Polarisru/kicad6_library/README.md

# Own parts library for KiCad6

## How to install

1. Start KiCad and select **Preferences → Configure Paths**:

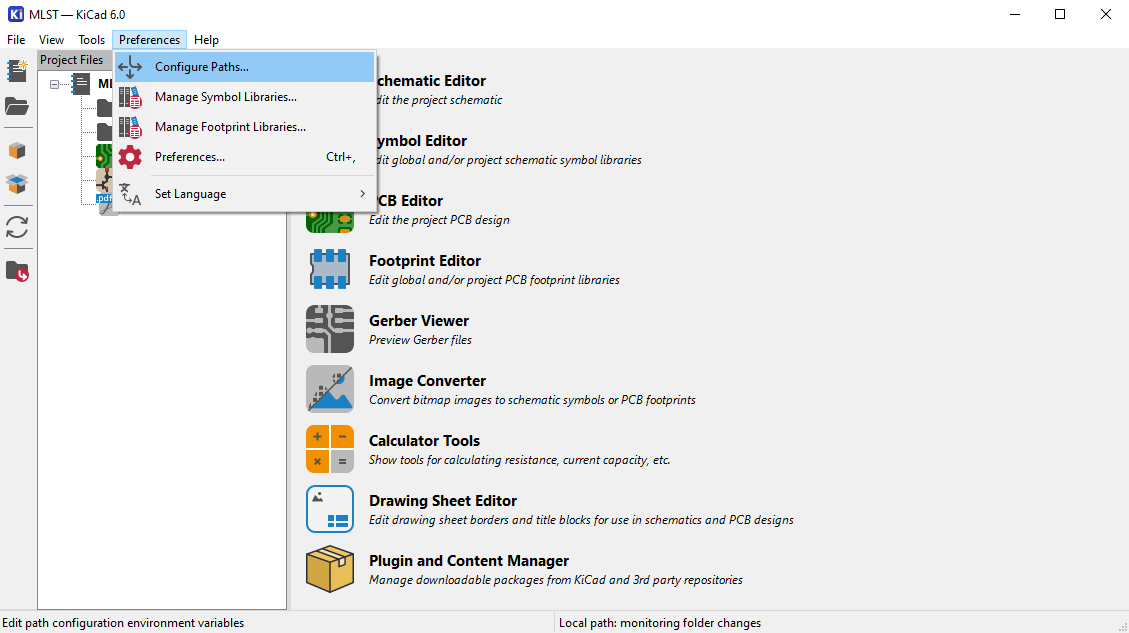
[picture p1: pics/KiCad_path_0.png]
Path configuration


2. Press **Plus** button and enter **KICAD_OWN_LIB** as Name, then select your kicad-library folder (here it‘s *E:\Projects\MLST\kicad-library*):

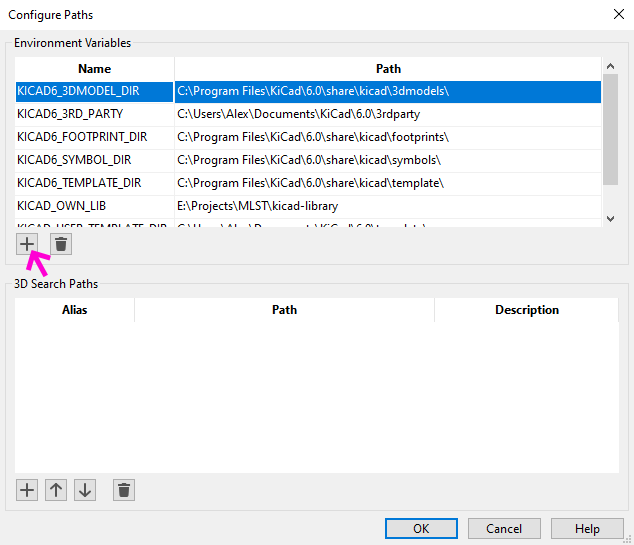
[picture p2: pics/KiCad_path.png]
Path configuration


3. Select **Preferences → Manage Symbol Libraries**:

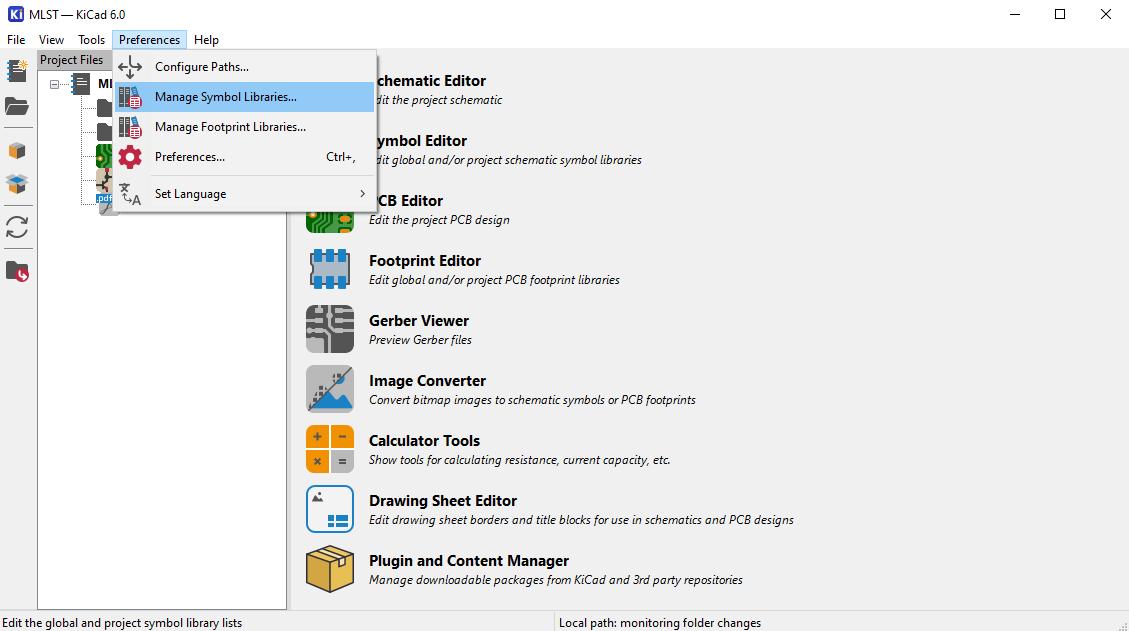
[picture p3: pics/KiCad_symbol_0.png]


4. Press **Folder** button and add you symbol library (*OwnLib.kicad_sym*):

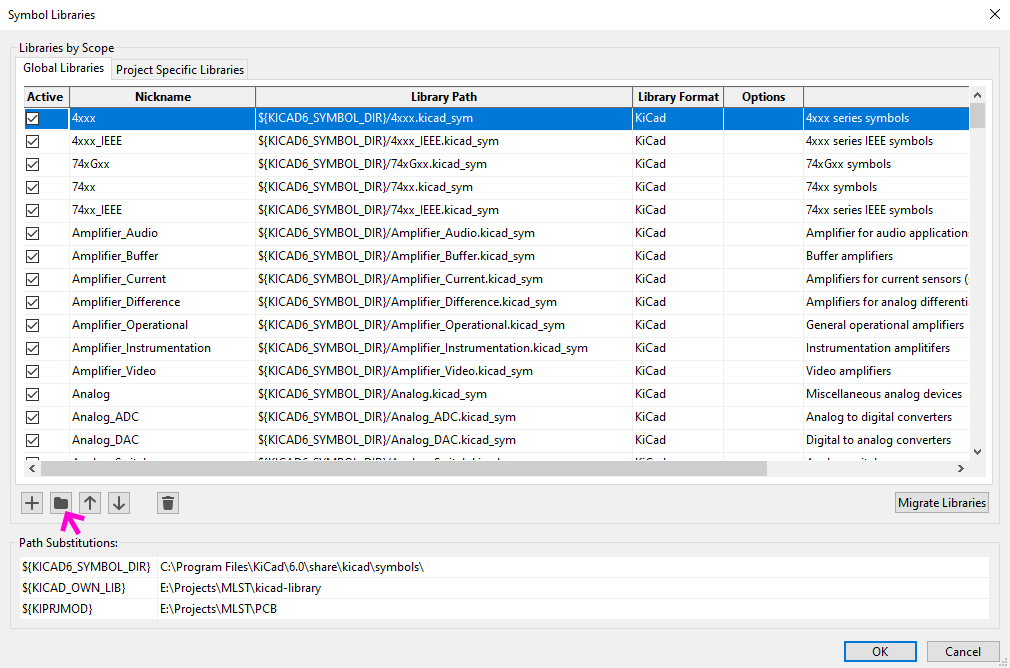
[picture p4: pics/KiCad_symbol.png]


5. Select **Preferences → Manage Footprint Libraries**:

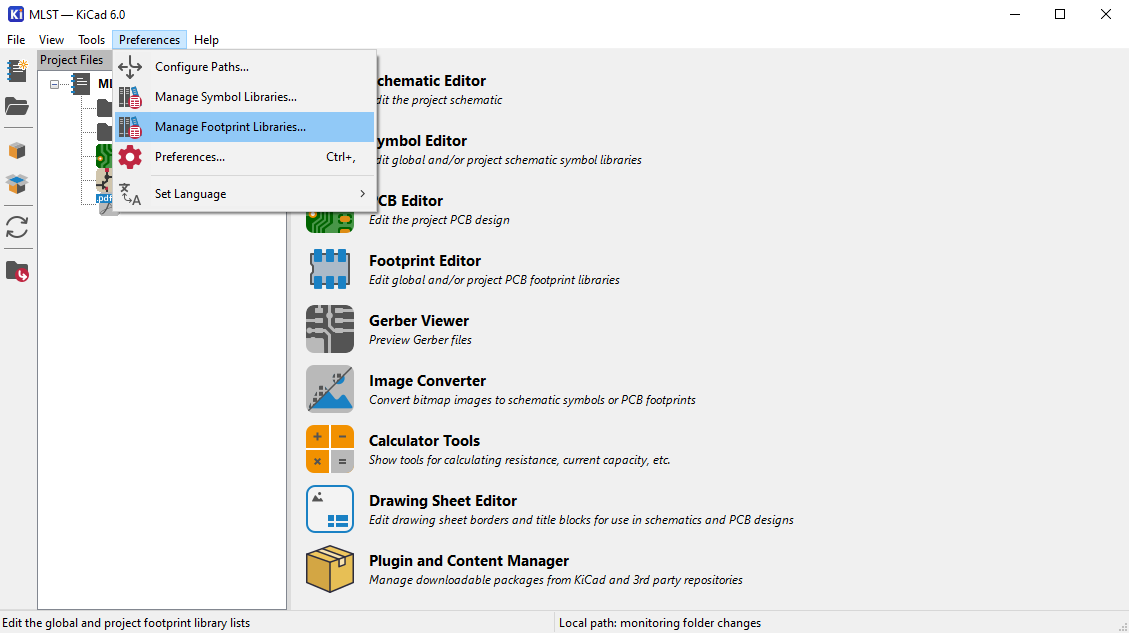
[picture p5: pics/KiCad_footprint_0.png]


6. Press **Folder** button and add you footprint folder (*OwnLib.pretty*):

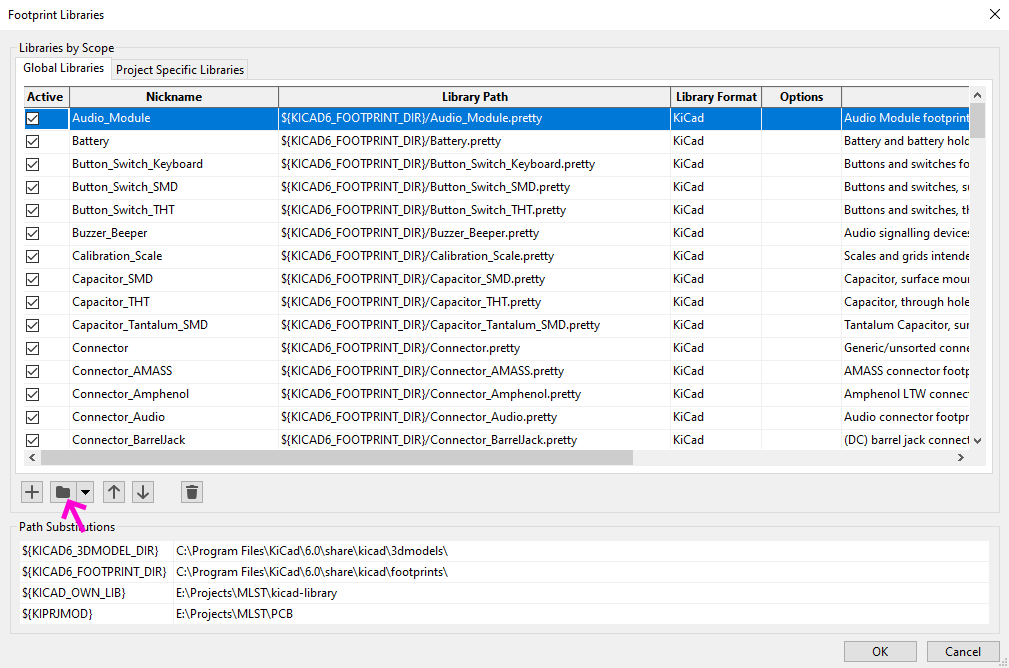
[picture p6: pics/KiCad_footprint.png]


Ready!
