Polarisru/kicad6_library/3DPackages/SX1262LoRaNode.step

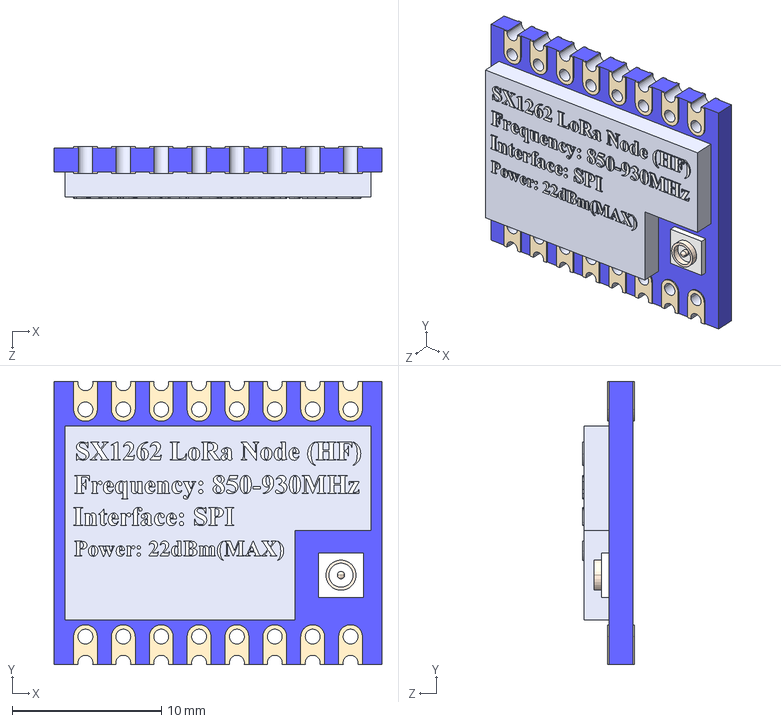
[picture p7: CAD file, 2026-10-09]
3DPackages/SX1262LoRaNode.step
22.0 x 19.0 x 3.47 mm
