Polarisru/kicad6_library/3DPackages/ATGM336H.step

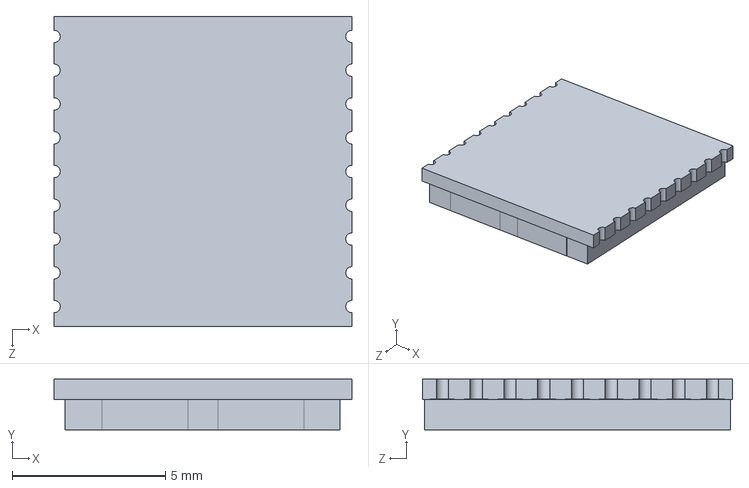
[picture p8: CAD file, 2026-10-09]
3DPackages/ATGM336H.step
9.70 x 1.66 x 10.1 mm
