Polarisru/kicad6_library/3DPackages/AA_Holder.step

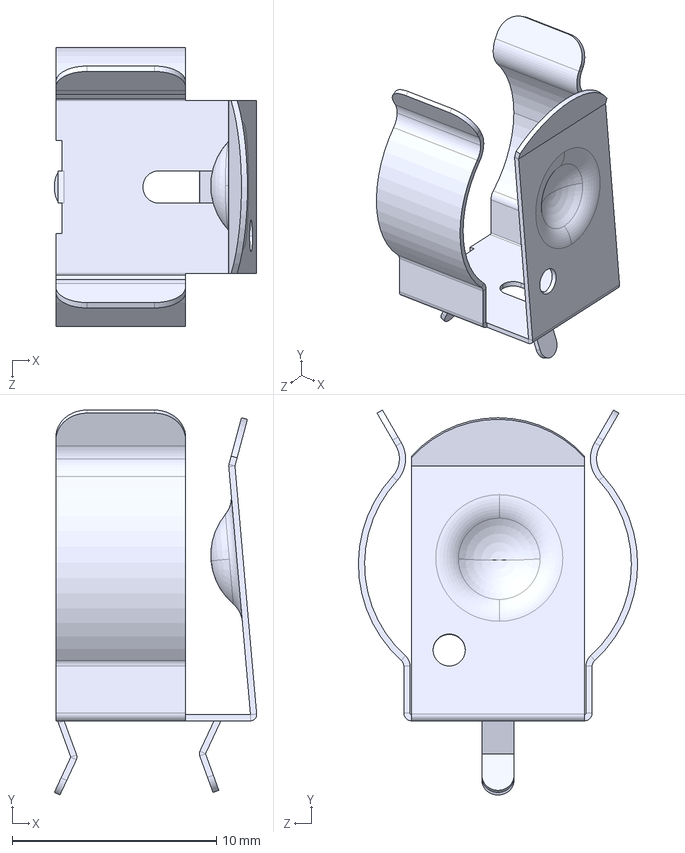
[picture p9: CAD file, 2026-04-12]
3DPackages/AA_Holder.step
9.91 x 18.8 x 13.7 mm
