Polarisru/kicad6_library/3DPackages/SW_PUSH-12mm.step

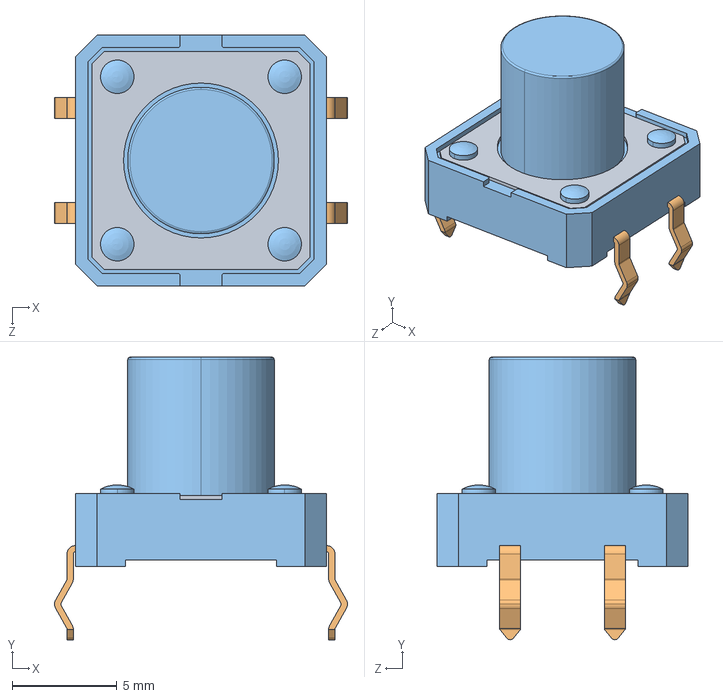
[picture p10: CAD file, 2026-04-12]
3DPackages/SW_PUSH-12mm.step
14.0 x 13.5 x 12.0 mm
