Polarisru/kicad6_library/3DPackages/MDBT42Q.step

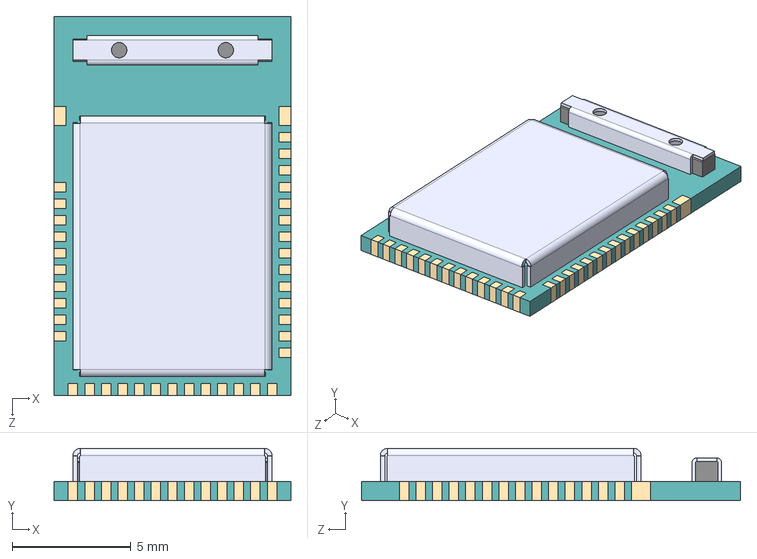
[picture p11: CAD file, 2025-12-02]
3DPackages/MDBT42Q.step
10.0 x 2.20 x 16.0 mm
