Polarisru/kicad6_library/3DPackages/DF11-6DP-2DSA.stp

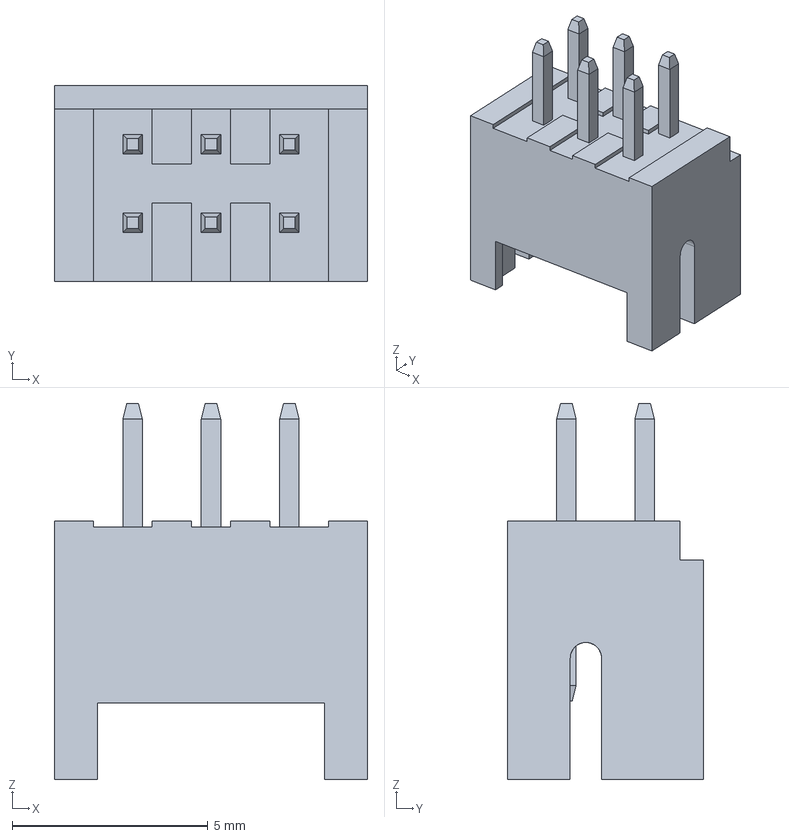
[picture p12: CAD file, 2025-06-15]
3DPackages/DF11-6DP-2DSA.stp
8.00 x 5.00 x 9.60 mm
