Polarisru/kicad6_library/3DPackages/PinHeader_1x07_P2.54mm_Vertical.step

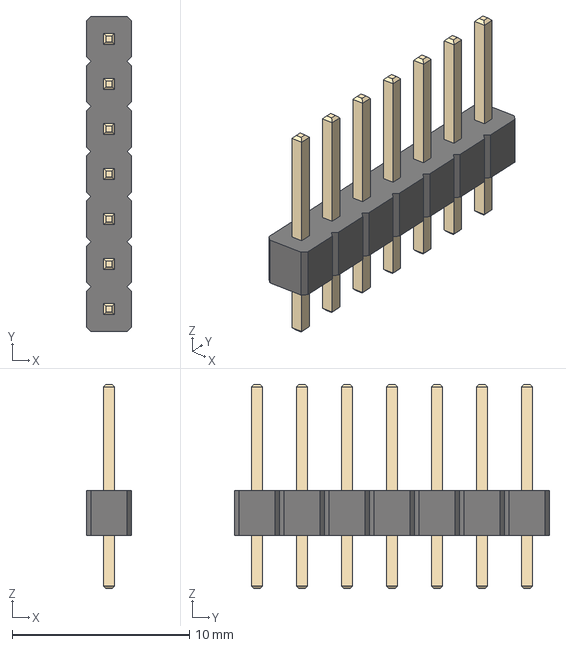
[picture p13: CAD file, 2025-06-12]
3DPackages/PinHeader_1x07_P2.54mm_Vertical.step
2.54 x 17.8 x 11.5 mm
