Polarisru/kicad6_library/3DPackages/TSSOP-16_4.4x5mm_P0.65mm.step

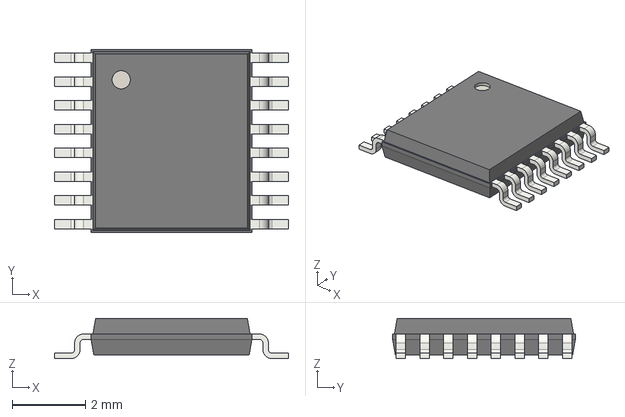
[picture p14: CAD file, 2025-06-05]
3DPackages/TSSOP-16_4.4x5mm_P0.65mm.step
6.40 x 5.00 x 1.10 mm
