Polarisru/kicad6_library/3DPackages/ICM-42688-P.step

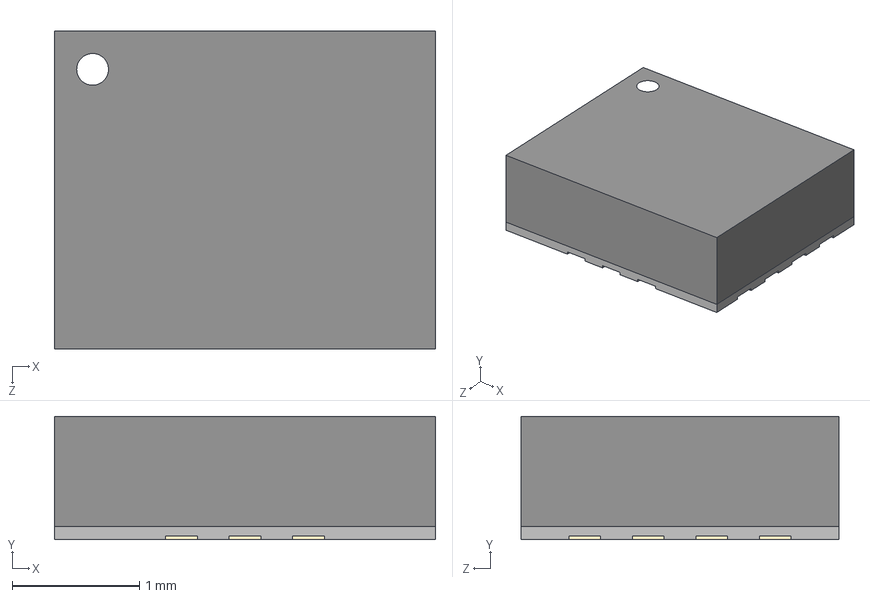
[picture p15: CAD file, 2025-06-04]
3DPackages/ICM-42688-P.step
3.00 x 0.97 x 2.50 mm
