Polarisru/kicad6_library/3DPackages/PinHeader_2x02_P2.54mm_Vertical.step

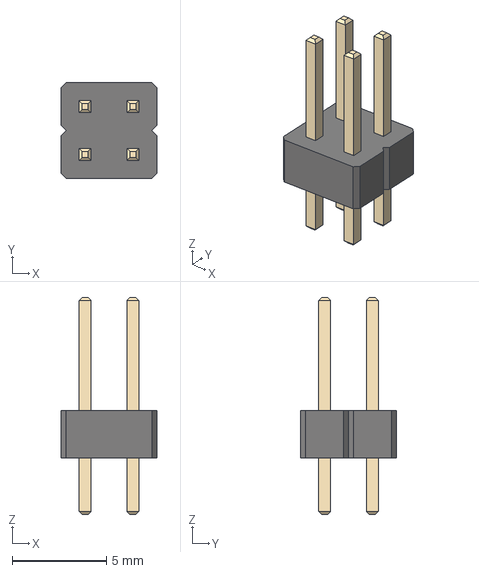
[picture p16: CAD file, 2025-06-04]
3DPackages/PinHeader_2x02_P2.54mm_Vertical.step
5.08 x 5.08 x 11.5 mm
