Polarisru/kicad6_library/3DPackages/Crystal_D2.1mm_L6.2mm_Horizontal_SMD.step

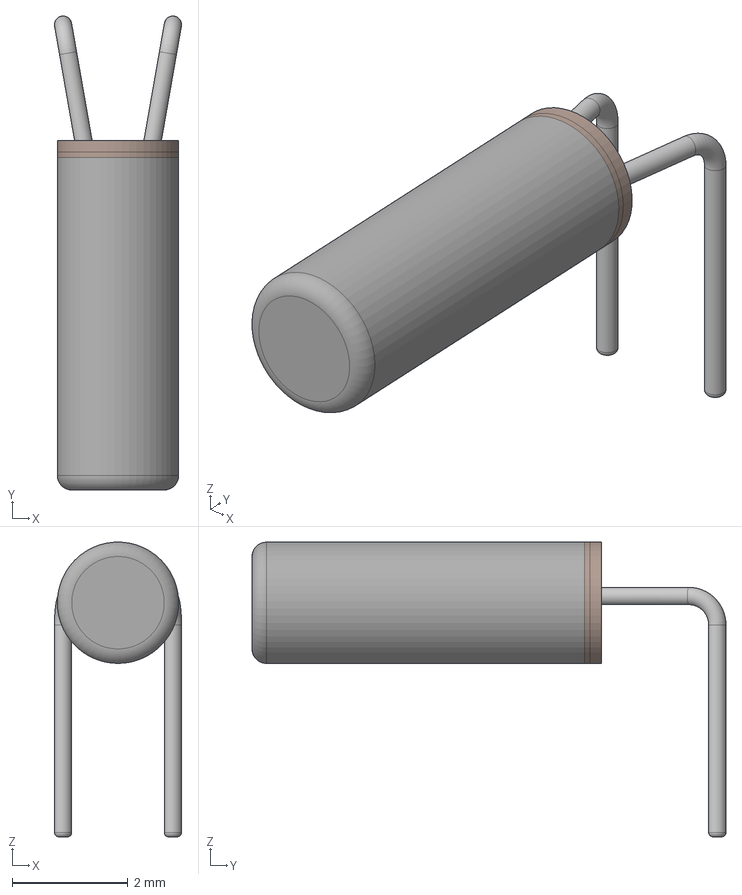
[picture p17: CAD file, 2025-04-22]
3DPackages/Crystal_D2.1mm_L6.2mm_Horizontal_SMD.step
2.20 x 8.20 x 5.10 mm
