Polarisru/kicad6_library/3DPackages/LGA-28.step

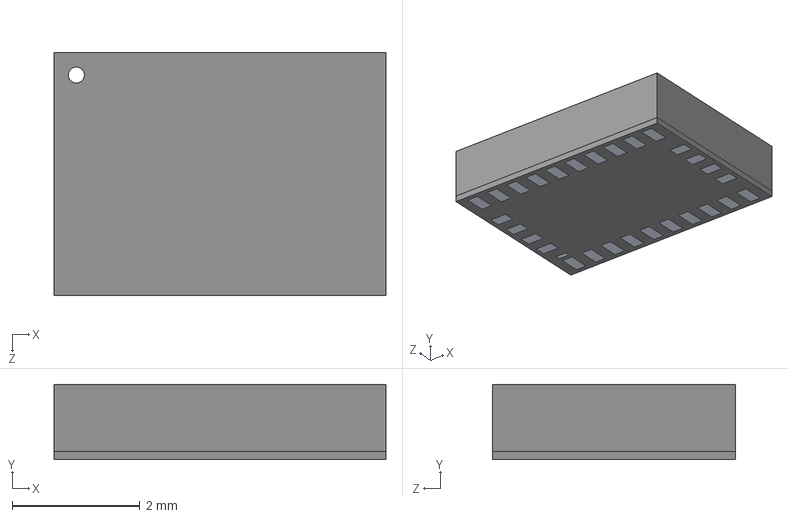
[picture p18: CAD file, 2025-04-22]
3DPackages/LGA-28.step
5.20 x 1.18 x 3.80 mm
