Polarisru/kicad6_library/3DPackages/ESP32-C3_SuperMini.step

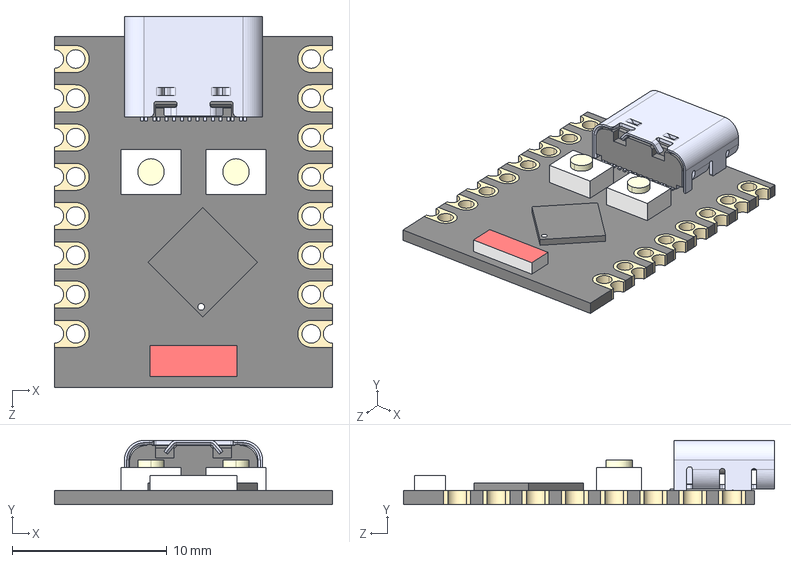
[picture p19: CAD file, 2025-02-22]
3DPackages/ESP32-C3_SuperMini.step
18.0 x 4.16 x 24.0 mm
Board c3mini
USB C
components (other)^ESP32-C3 SuperMini
