Polarisru/kicad6_library/3DPackages/LGA-14_3x2.5mm_P0.5mm.step

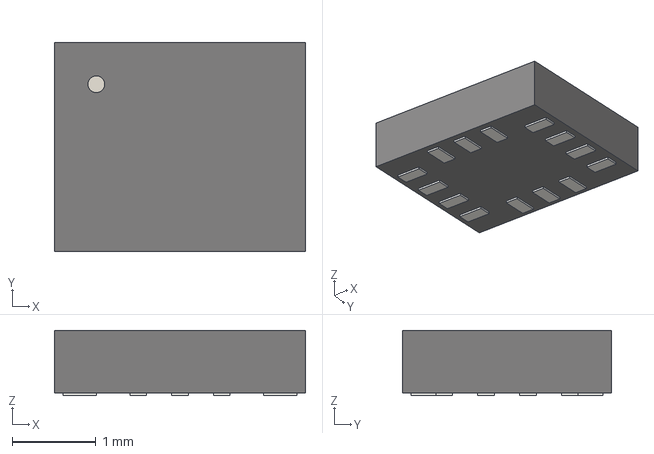
[picture p20: CAD file, 2025-02-09]
3DPackages/LGA-14_3x2.5mm_P0.5mm.step
3.00 x 2.50 x 0.78 mm
