Polarisru/kicad6_library/3DPackages/PinHeader_3x04_P2.54mm_Horizontal.step

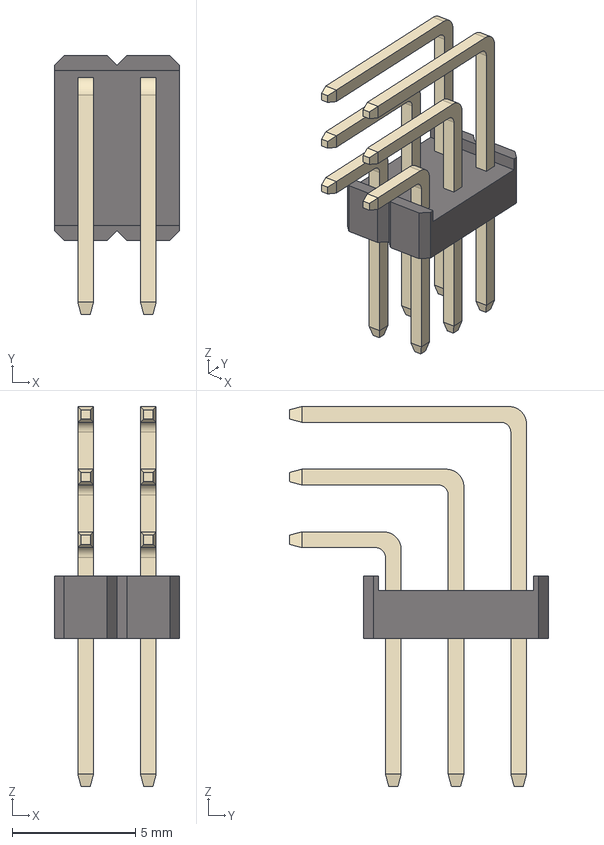
[picture p21: CAD file, 2025-01-01]
3DPackages/PinHeader_3x04_P2.54mm_Horizontal.step
5.08 x 10.5 x 15.4 mm
BG043-006-A-0300-0600-N-G_H
BG043-006-A-0300-0600-N-G_P_3 x 2
BG043-006-A-0300-0600-N-G_P_2 x 2
BG043-006-A-0300-0600-N-G_P_1 x 2
