Polarisru/kicad6_library/3DPackages/PinHeader_2x03_P2.54mm_Horizontal.step

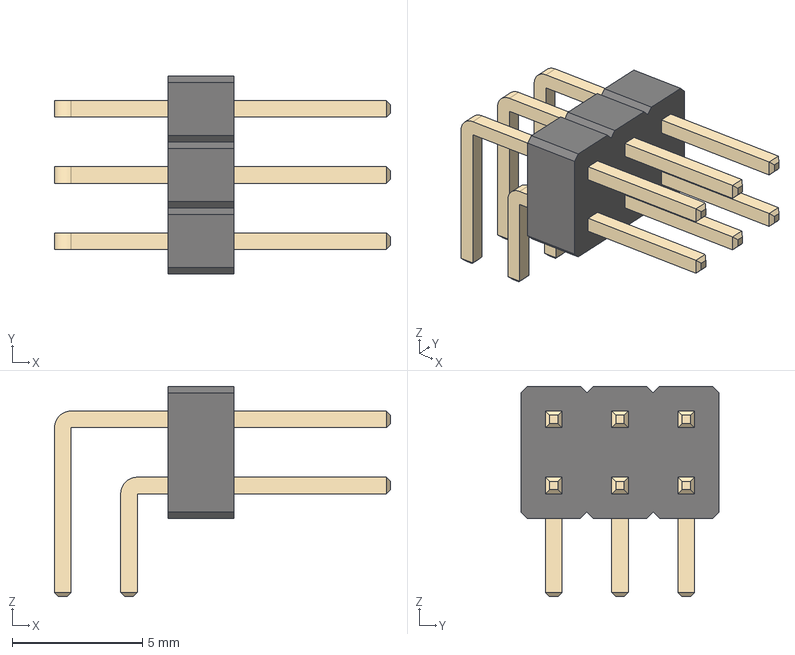
[picture p22: CAD file, 2024-12-31]
3DPackages/PinHeader_2x03_P2.54mm_Horizontal.step
12.9 x 7.62 x 8.08 mm
