Polarisru/kicad6_library/3DPackages/DFN-10_2x2mm_P0.4mm.step

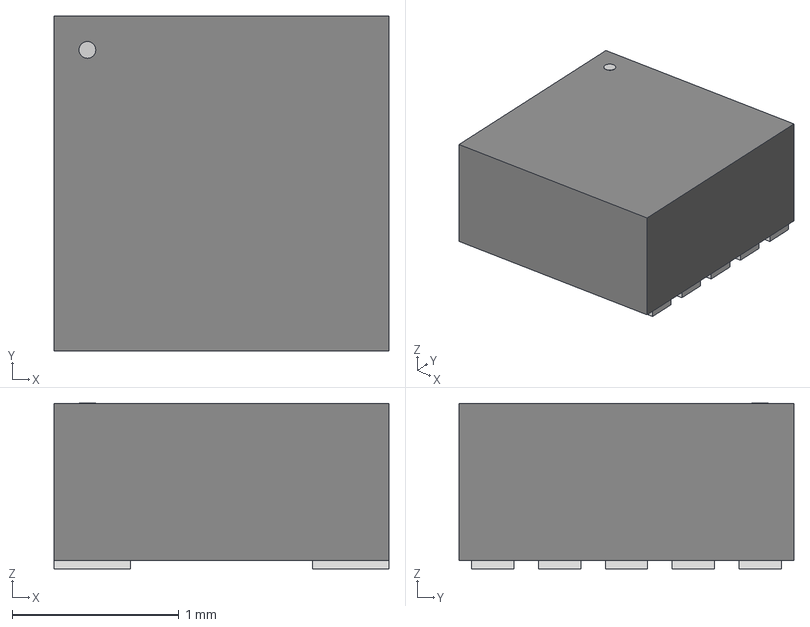
[picture p23: CAD file, 2024-12-31]
3DPackages/DFN-10_2x2mm_P0.4mm.step
2.01 x 2.01 x 0.993 mm
