Polarisru/kicad6_library/3DPackages/TSSOP-28_4.4x9.7mm_P0.65mm.step

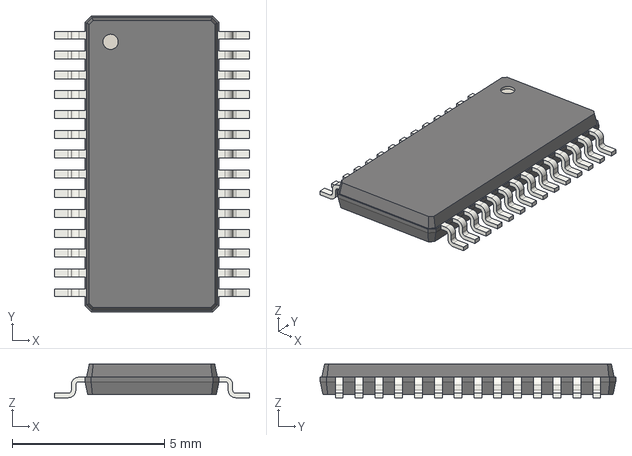
[picture p24: CAD file, 2024-12-31]
3DPackages/TSSOP-28_4.4x9.7mm_P0.65mm.step
6.40 x 9.70 x 1.10 mm
