Polarisru/kicad6_library/3DPackages/PinSocket_2x20_P2.54mm_Vertical.step

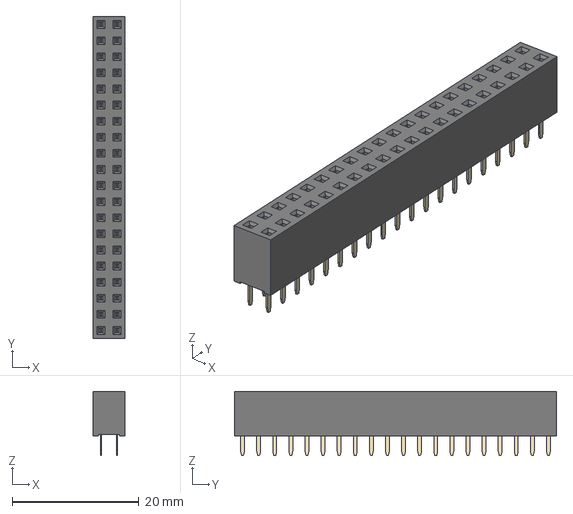
[picture p25: CAD file, 2024-12-31]
3DPackages/PinSocket_2x20_P2.54mm_Vertical.step
5.08 x 50.8 x 10.1 mm
