Polarisru/kicad6_library/3DPackages/GY-521.step

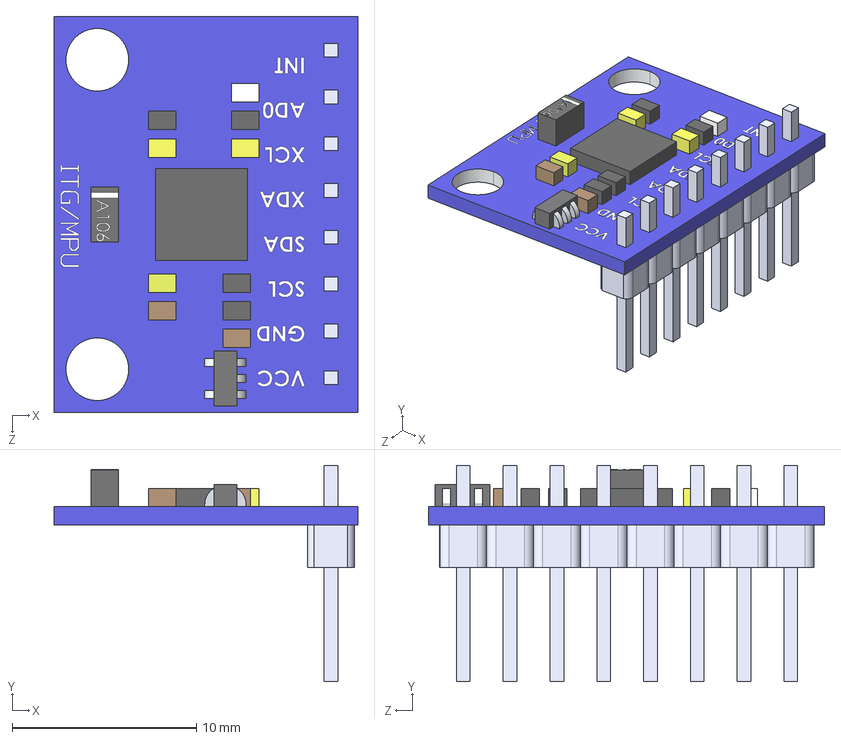
[picture p26: CAD file, 2024-08-14]
3DPackages/GY-521.step
16.5 x 11.8 x 21.5 mm
8 Header-Pin
Placa_Base
