Polarisru/kicad6_library/3DPackages/KTD2026CEWE-TR.stp

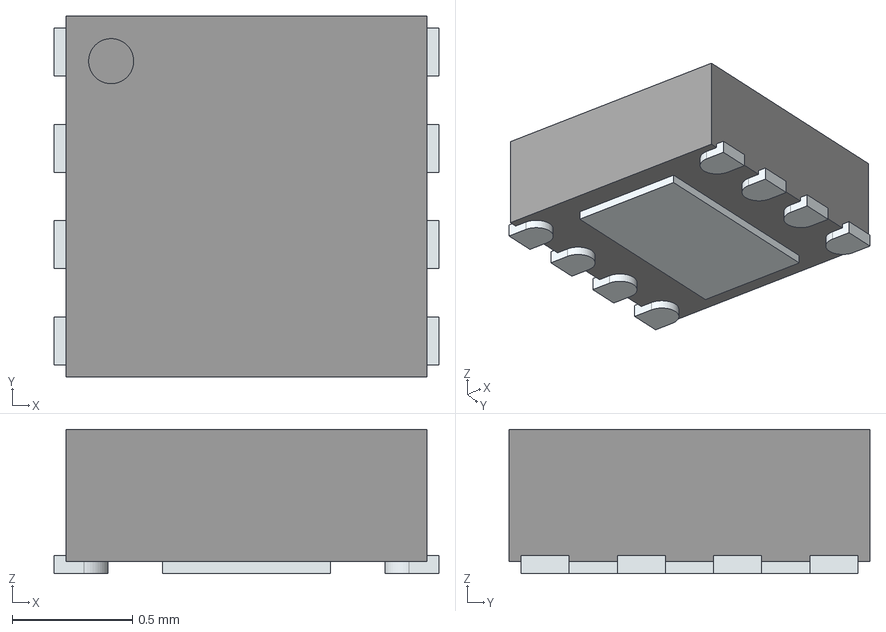
[picture p27: CAD file, 2023-10-21]
3DPackages/KTD2026CEWE-TR.stp
1.60 x 1.50 x 0.6 mm
ThermalPin
PinsArrayLR
