Polarisru/kicad6_library/3DPackages/PinHeader_2x05_P1.27mm_Vertical_SMD.step

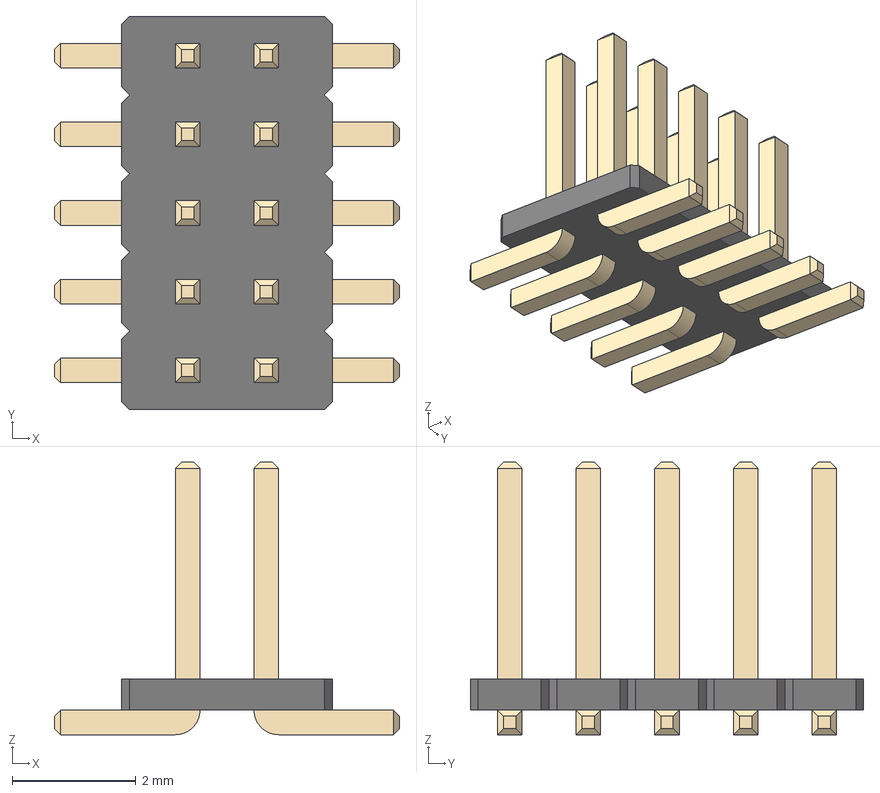
[picture p28: CAD file, 2023-07-05]
3DPackages/PinHeader_2x05_P1.27mm_Vertical_SMD.step
5.57 x 6.35 x 4.40 mm
