Polarisru/kicad6_library/3DPackages/WDFN-8-1EP_6x5mm_P1.27mm.step

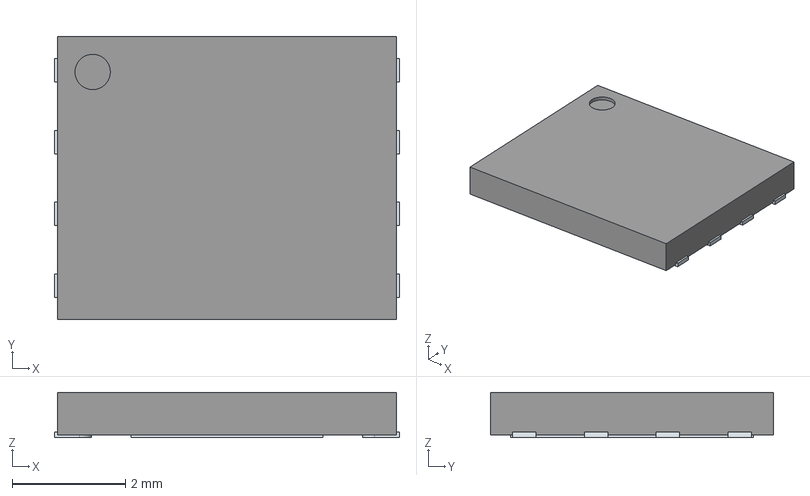
[picture p29: CAD file, 2023-07-05]
3DPackages/WDFN-8-1EP_6x5mm_P1.27mm.step
6.10 x 5.00 x 0.8 mm
ThermalPin
PinsArrayLR
