Polarisru/kicad6_library/3DPackages/LED_PLC4_2x2mm.stp

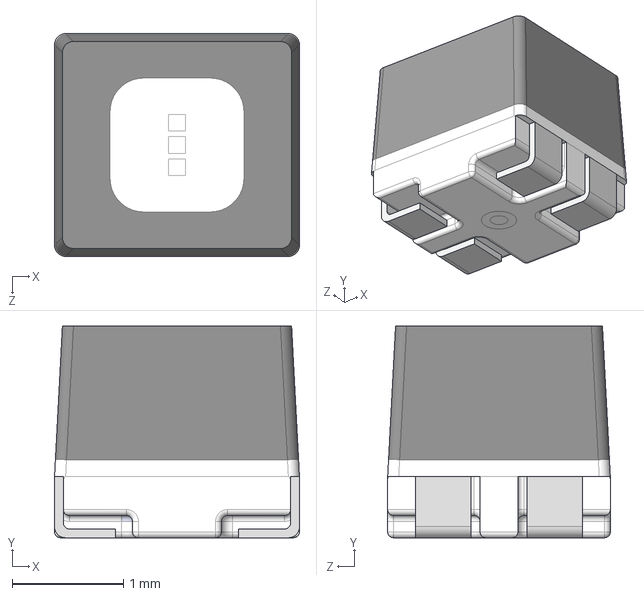
[picture p30: CAD file, 2023-04-28]
3DPackages/LED_PLC4_2x2mm.stp
2.20 x 1.90 x 2.00 mm
