Polarisru/kicad6_library/3DPackages/CLV1.step

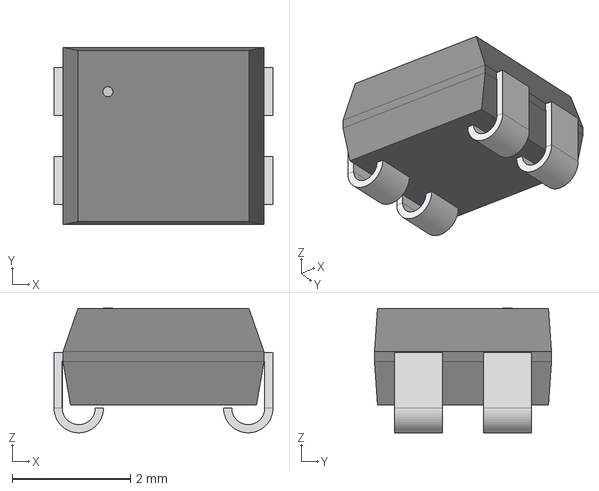
[picture p31: CAD file, 2023-04-26]
3DPackages/CLV1.step
3.71 x 3.00 x 2.11 mm
