Polarisru/kicad6_library/3DPackages/LED_IN-PI55TAT_INL.step

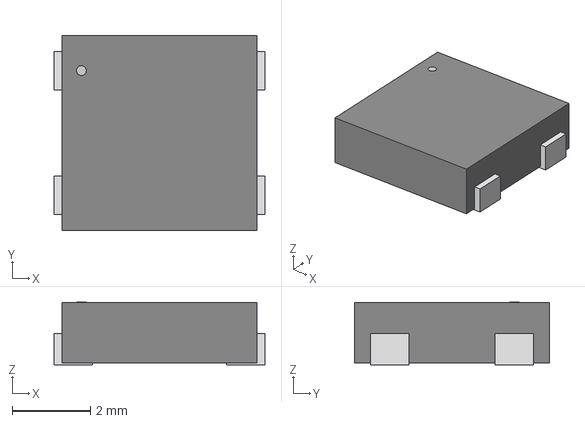
[picture p32: CAD file, 2023-04-26]
3DPackages/LED_IN-PI55TAT_INL.step
5.41 x 5.00 x 1.60 mm
