Polarisru/kicad6_library/3DPackages/Fuse_1206_3216Metric.step

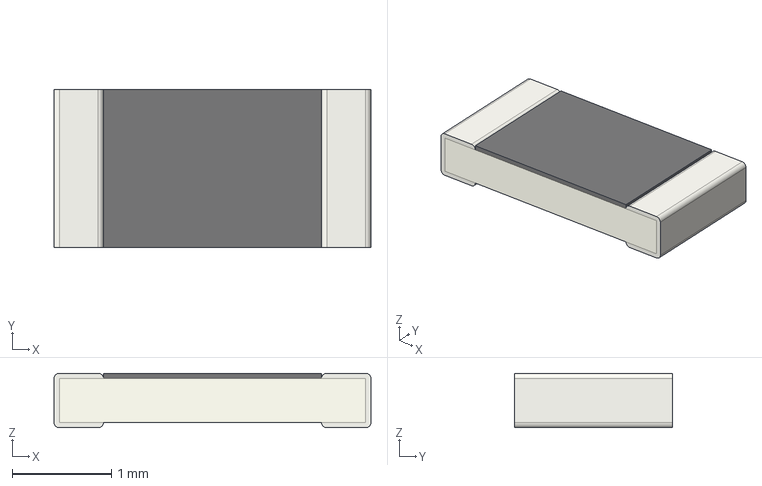
[picture p33: CAD file, 2023-04-25]
3DPackages/Fuse_1206_3216Metric.step
3.20 x 1.60 x 0.55 mm
