Polarisru/kicad6_library/3DPackages/VSON-14-EP-4.5x3mm_P0.65mm.step

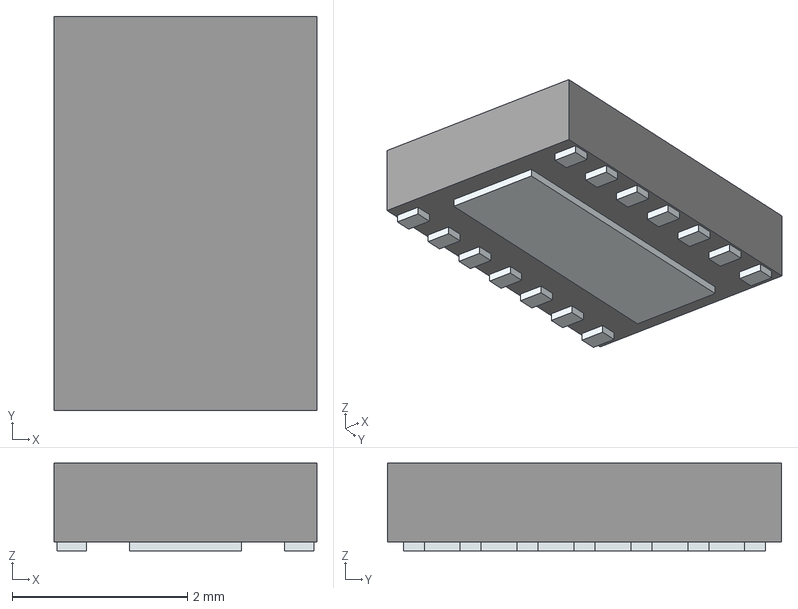
[picture p34: CAD file, 2023-04-22]
3DPackages/VSON-14-EP-4.5x3mm_P0.65mm.step
3.00 x 4.50 x 1.00 mm
Pins
