Polarisru/kicad6_library/3DPackages/E104-BT5010A.step

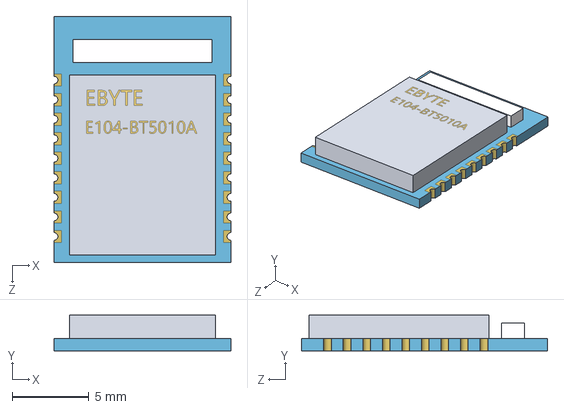
[picture p35: CAD file, 2023-04-22]
3DPackages/E104-BT5010A.step
11.5 x 2.32 x 16.0 mm
