Polarisru/kicad6_library/3DPackages/DM3CS-SF.stp

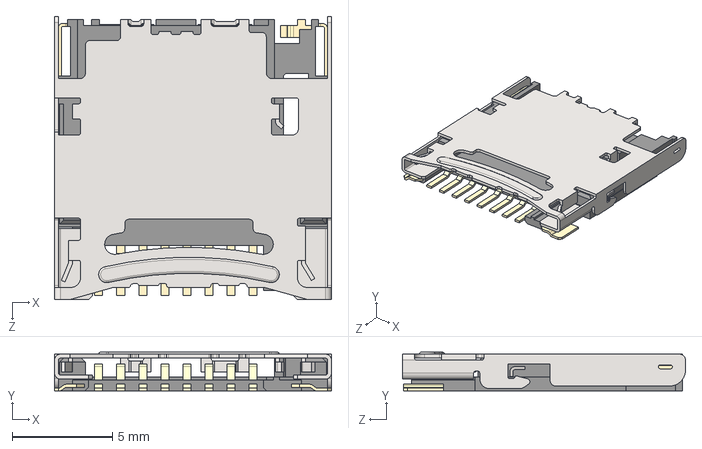
[picture p36: CAD file, 2023-04-02]
3DPackages/DM3CS-SF.stp
13.8 x 1.93 x 14.1 mm
