Polarisru/kicad6_library/3DPackages/FH12A-40S-0.5SH.stp

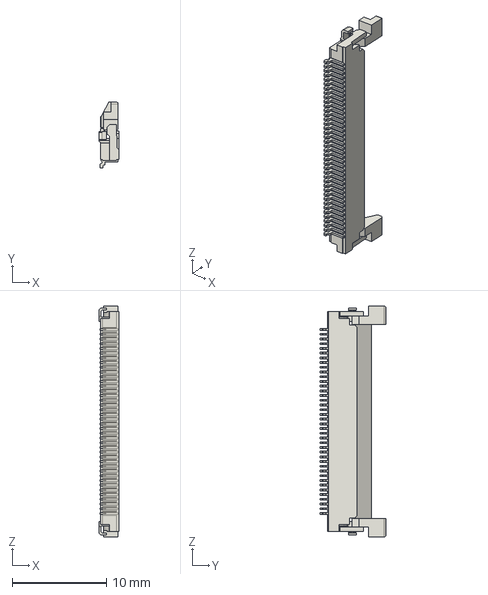
[picture p37: CAD file, 2023-03-31]
3DPackages/FH12A-40S-0.5SH.stp
2.15 x 7.00 x 24.5 mm
