Polarisru/kicad6_library/3DPackages/FFC2B35-10-T.stp

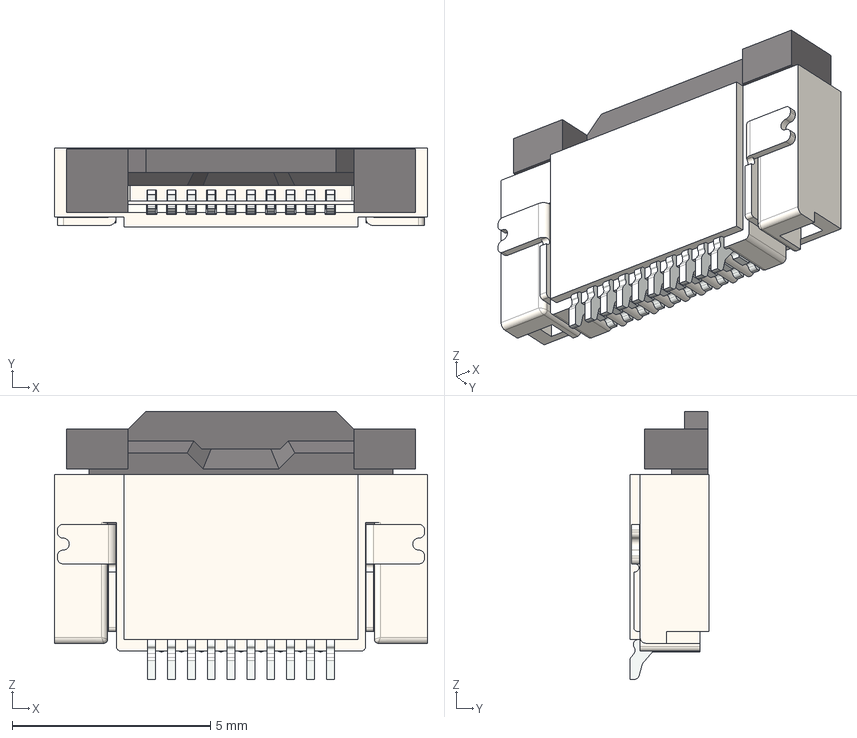
[picture p38: CAD file, 2023-03-31]
3DPackages/FFC2B35-10-T.stp
9.40 x 2.00 x 6.76 mm
FFC2B35-10-T_c
FFC2B35-04-T_sp
FFC2B35-04-T_sp2
FFC2B35-10-T_p x 10
FFC2B35-10-T_h
