Polarisru/kicad6_library/3DPackages/1-2328702-0.step

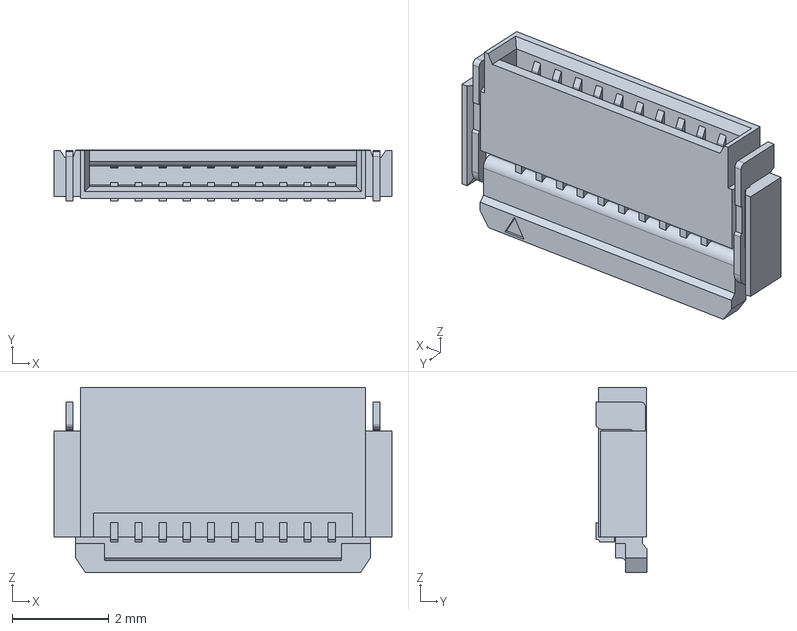
[picture p39: CAD file, 2023-03-28]
3DPackages/1-2328702-0.step
7.00 x 1.06 x 3.83 mm
