Polarisru/kicad6_library/3DPackages/SW_DIP_SPSTx04_Slide_Copal_CHS-04B_W7.62mm_P1.27mm.step

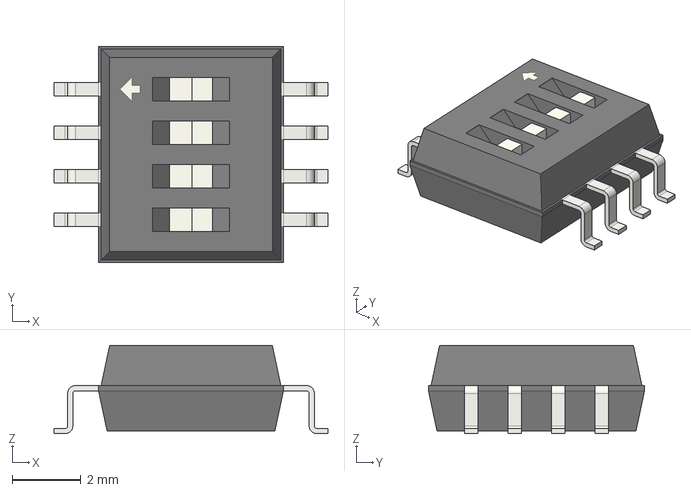
[picture p40: CAD file, 2023-03-24]
3DPackages/SW_DIP_SPSTx04_Slide_Copal_CHS-04B_W7.62mm_P1.27mm.step
8.00 x 6.31 x 2.58 mm
