Polarisru/kicad6_library/3DPackages/CUI_DEVICES_TS04-66-55-BK-160-SMT.step

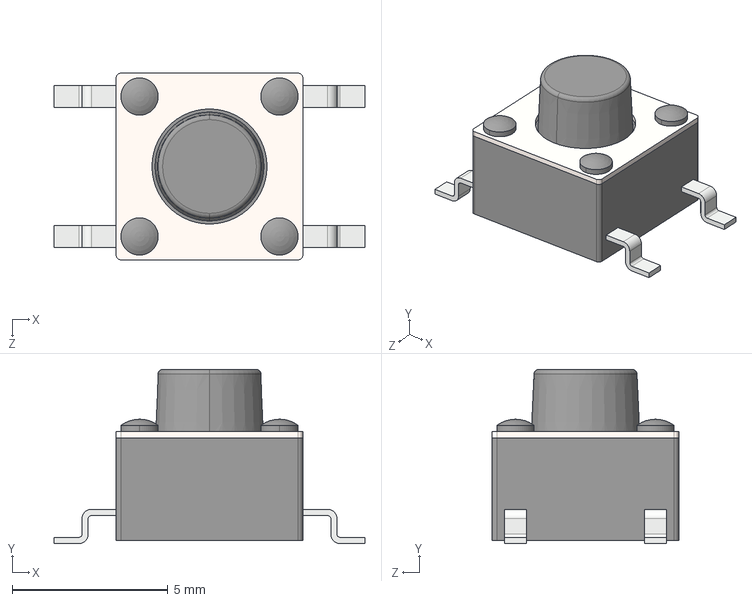
[picture p41: CAD file, 2023-03-24]
3DPackages/CUI_DEVICES_TS04-66-55-BK-160-SMT.step
10.0 x 5.60 x 6.00 mm
