Polarisru/kicad6_library/3DPackages/microSD_HC_Hirose_DM3D-SF.step

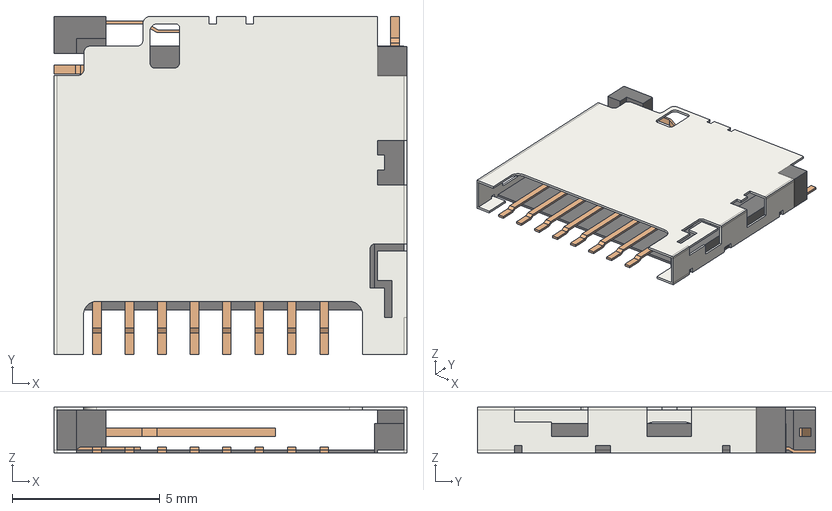
[picture p42: CAD file, 2023-03-22]
3DPackages/microSD_HC_Hirose_DM3D-SF.step
11.9 x 11.5 x 1.55 mm
