Polarisru/kicad6_library/3DPackages/PinHeader_1x05_P2.54mm_Vertical_SMD.step

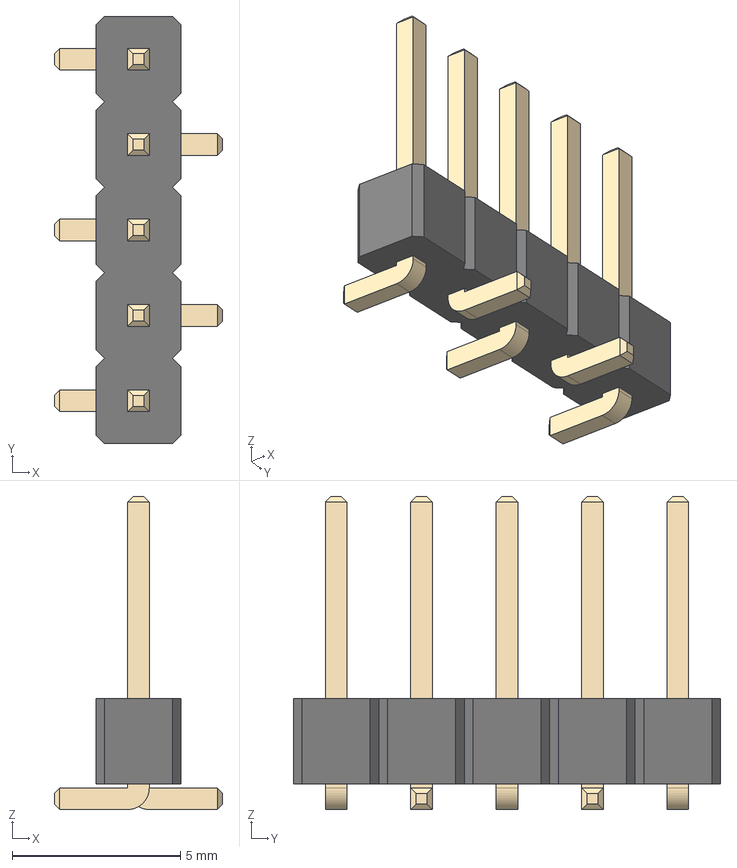
[picture p43: CAD file, 2023-01-25]
3DPackages/PinHeader_1x05_P2.54mm_Vertical_SMD.step
5.00 x 12.7 x 9.30 mm
