Polarisru/kicad6_library/3DPackages/LED_0805_2012Metric.step

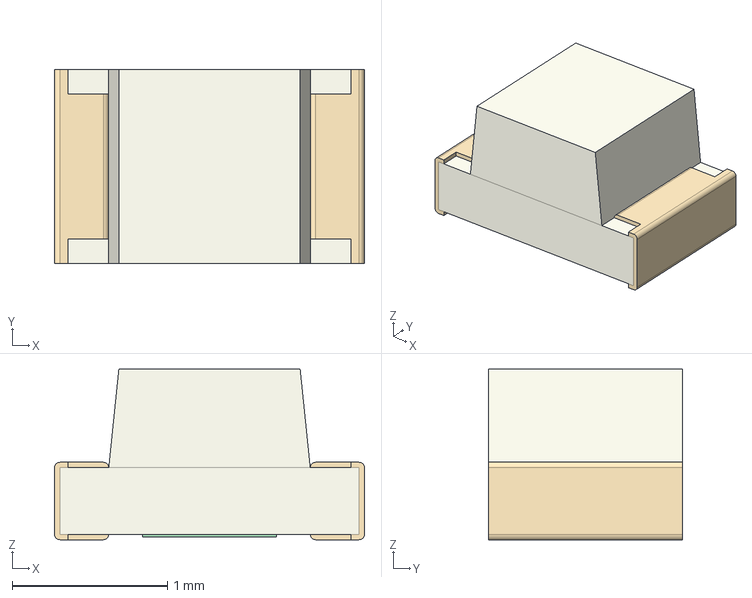
[picture p44: CAD file, 2023-01-25]
3DPackages/LED_0805_2012Metric.step
2.00 x 1.25 x 1.10 mm
