Polarisru/kicad6_library/3DPackages/L_1210_3225Metric.step

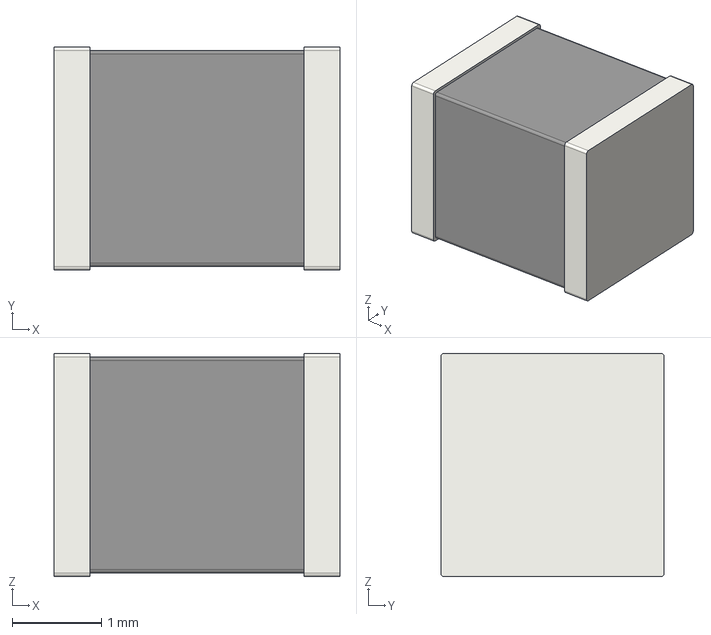
[picture p45: CAD file, 2023-01-25]
3DPackages/L_1210_3225Metric.step
3.20 x 2.50 x 2.50 mm
