Polarisru/kicad6_library/3DPackages/1255AY-220M_P3.step

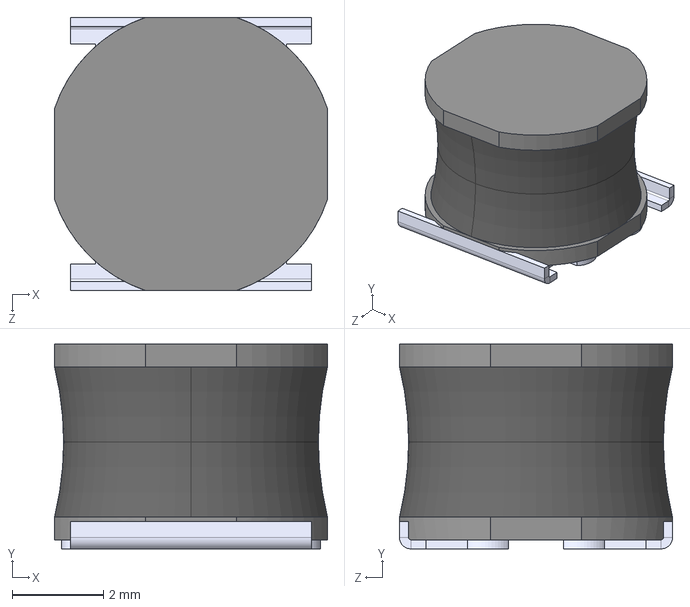
[picture p46: CAD file, 2023-01-23]
3DPackages/1255AY-220M_P3.step
6.00 x 4.50 x 6.00 mm
