Polarisru/kicad6_library/3DPackages/C_0805_2012Metric.step

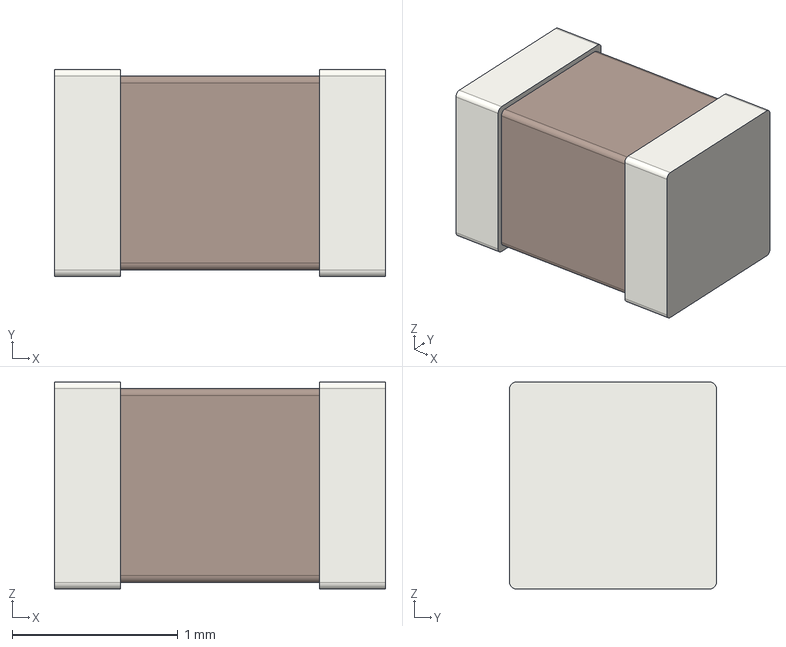
[picture p47: CAD file, 2023-01-22]
3DPackages/C_0805_2012Metric.step
2.00 x 1.25 x 1.25 mm
