Polarisru/kicad6_library/3DPackages/USB_Mini-B_Lumberg_2486_01_Horizontal.step

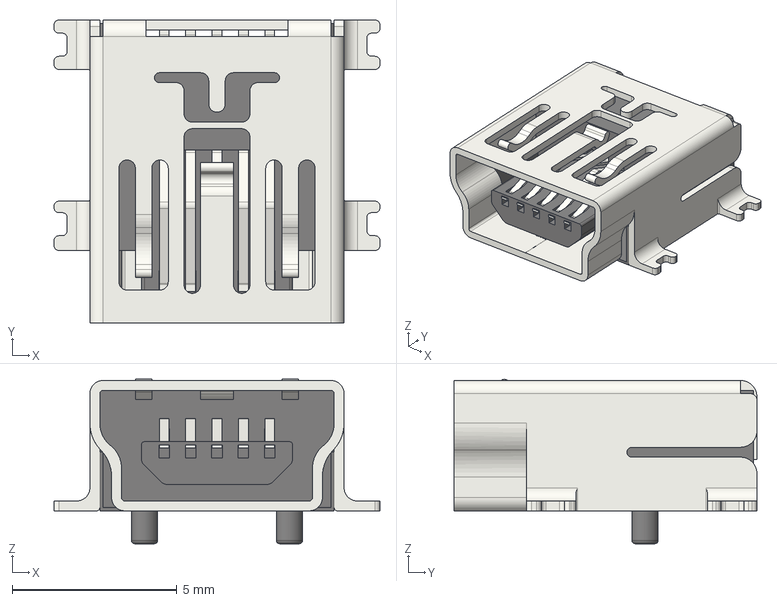
[picture p48: CAD file, 2023-01-22]
3DPackages/USB_Mini-B_Lumberg_2486_01_Horizontal.step
9.90 x 9.20 x 5.00 mm
