Polarisru/kicad6_library/3DPackages/LQH31CN100K03L.step

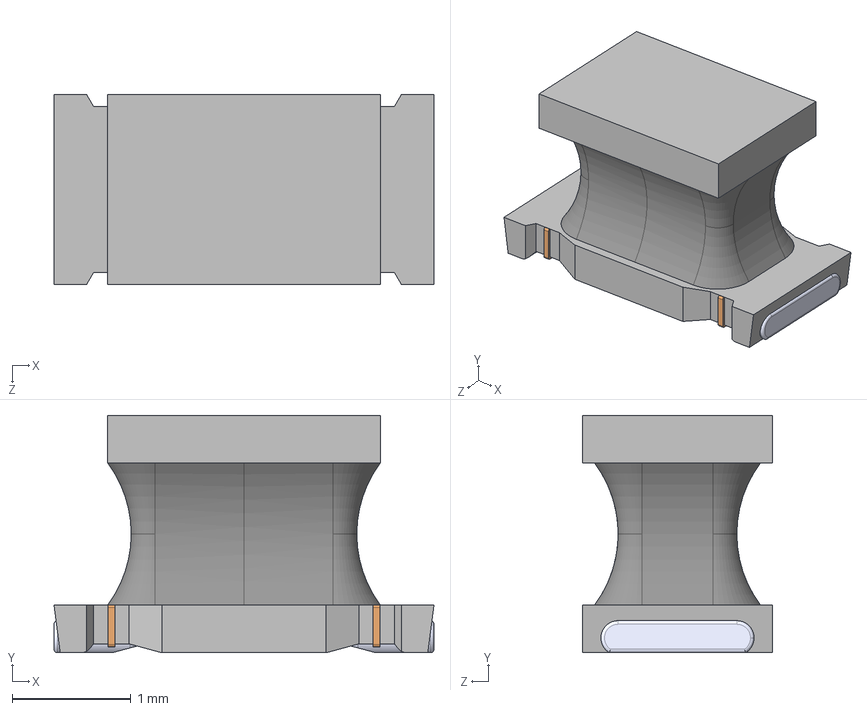
[picture p49: CAD file, 2023-01-22]
3DPackages/LQH31CN100K03L.step
3.20 x 2.00 x 1.60 mm
