Polarisru/kicad6_library/3DPackages/S08B-XASK-1.STEP

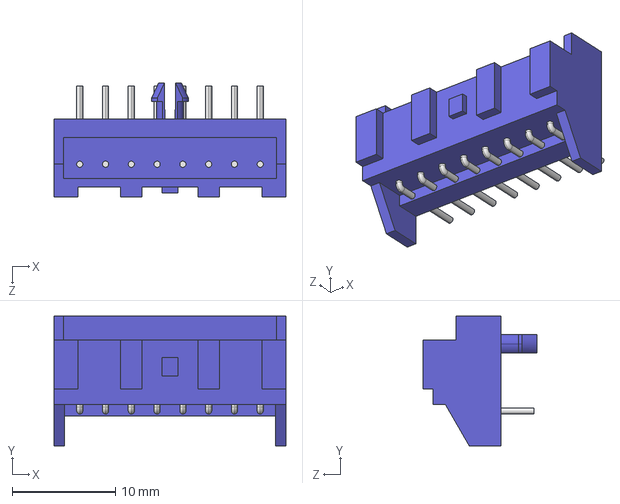
[picture p50: CAD file, 2023-01-22]
3DPackages/S08B-XASK-1.STEP
22.5 x 12.6 x 11.1 mm
