Polarisru/kicad6_library/3DPackages/DFN-6-1EP_3x3mm_P1mm_EP1.5x2.4mm.step

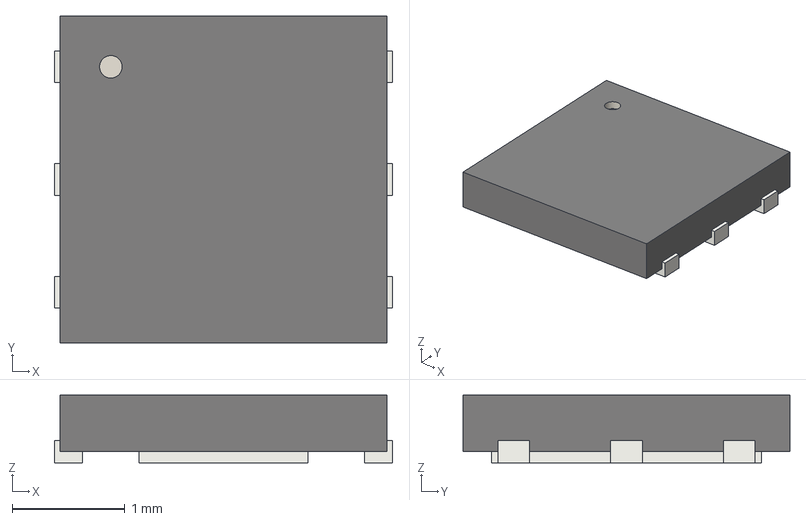
[picture p51: CAD file, 2023-01-22]
3DPackages/DFN-6-1EP_3x3mm_P1mm_EP1.5x2.4mm.step
3.00 x 2.90 x 0.6 mm
