Polarisru/kicad6_library/3DPackages/Banana jack_SLB4-I_90.step

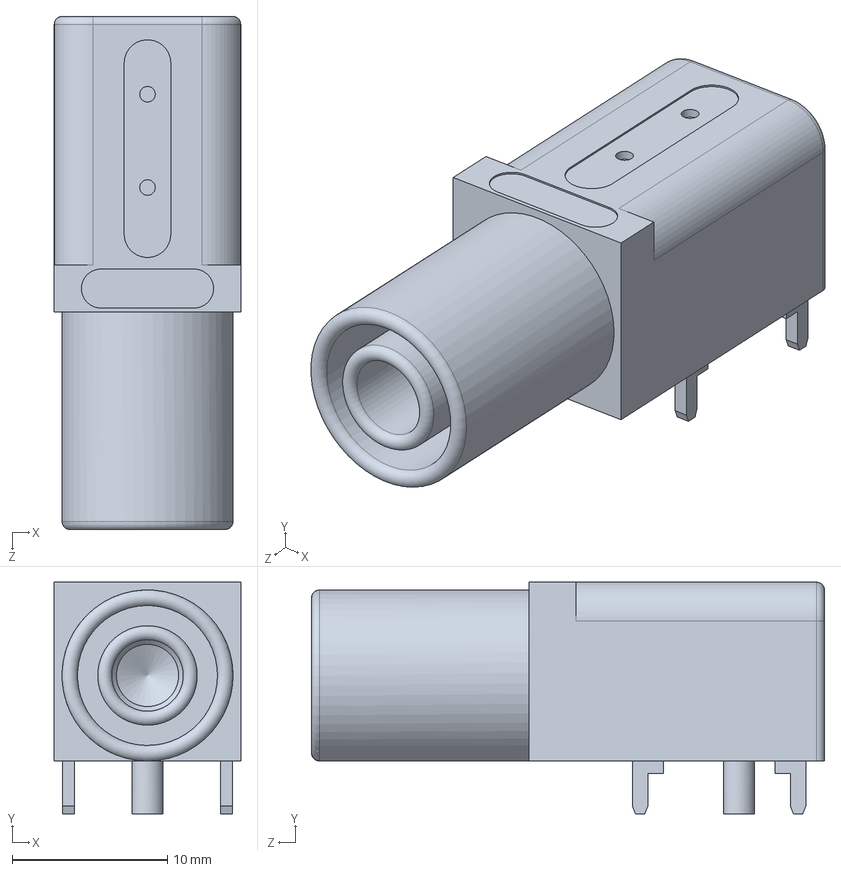
[picture p52: CAD file, 2023-01-22]
3DPackages/Banana jack_SLB4-I_90.step
12.0 x 14.9 x 33.0 mm
