Polarisru/kicad6_library/3DPackages/srf1280.stp

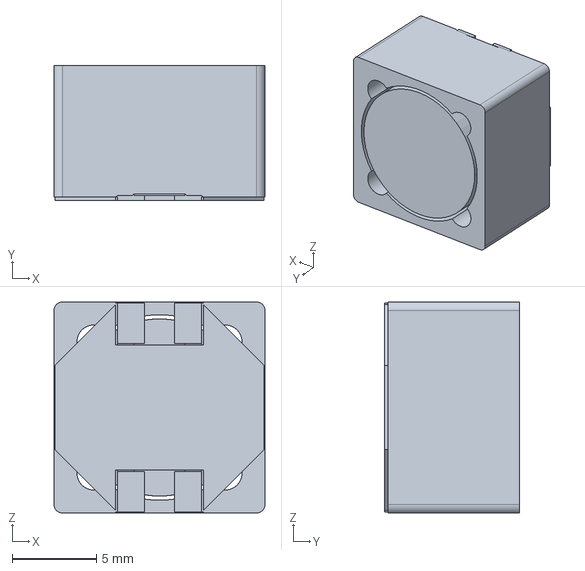
[picture p53: CAD file, 2023-01-22]
3DPackages/srf1280.stp
12.5 x 8.00 x 12.5 mm
