Polarisru/kicad6_library/3DPackages/D_SMC.step

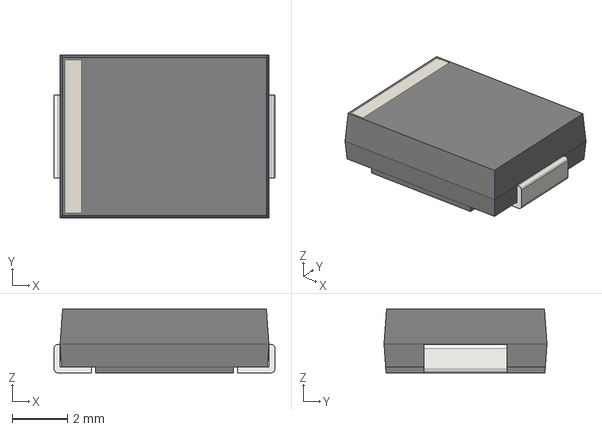
[picture p54: CAD file, 2023-01-22]
3DPackages/D_SMC.step
8.00 x 5.90 x 2.31 mm
