Polarisru/kicad6_library/3DPackages/IHA105.step

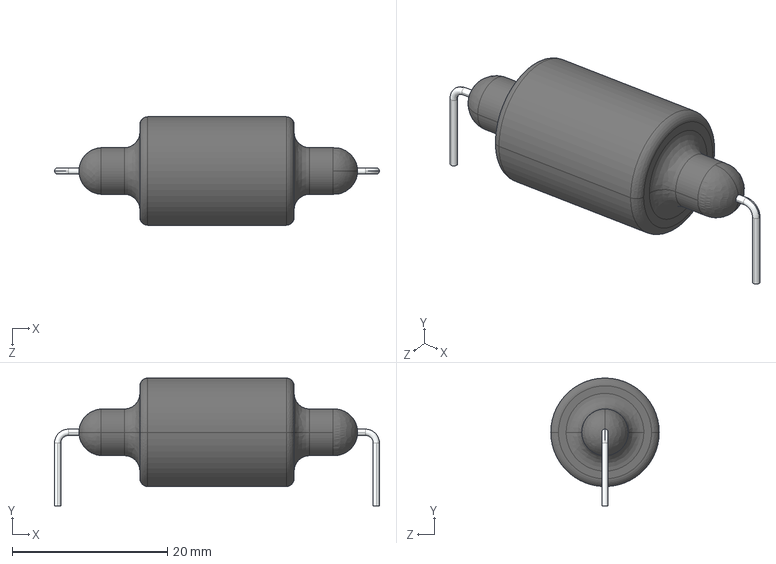
[picture p55: CAD file, 2023-01-22]
3DPackages/IHA105.step
41.8 x 16.5 x 14.0 mm
