Polarisru/kicad6_library/3DPackages/IND_BOURNS_5256.step

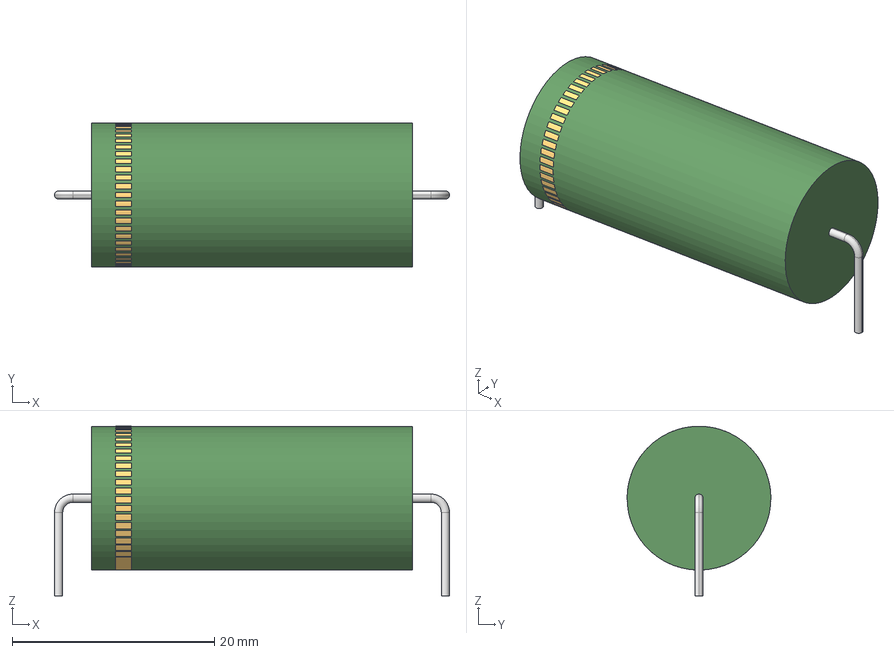
[picture p56: CAD file, 2023-01-22]
3DPackages/IND_BOURNS_5256.step
39.1 x 14.2 x 16.8 mm
