Polarisru/kicad6_library/3DPackages/WE_7448012501.step

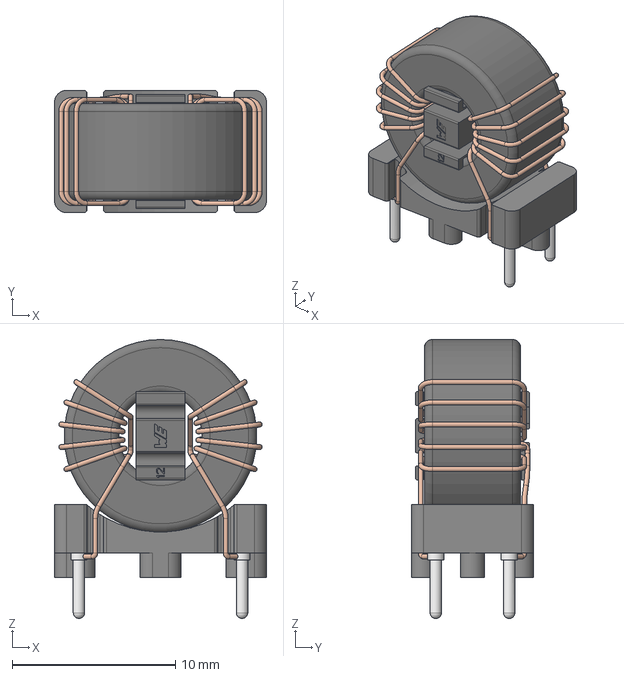
[picture p57: CAD file, 2023-01-22]
3DPackages/WE_7448012501.step
13.0 x 7.50 x 17.1 mm
