Polarisru/kicad6_library/3DPackages/Molex_Picoblade_1x12.step

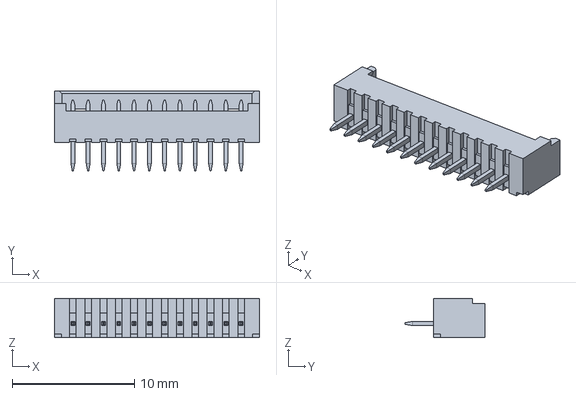
[picture p58: CAD file, 2023-01-22]
3DPackages/Molex_Picoblade_1x12.step
16.8 x 6.50 x 3.20 mm
