Polarisru/kicad6_library/3DPackages/S02B-PASK-2.STEP

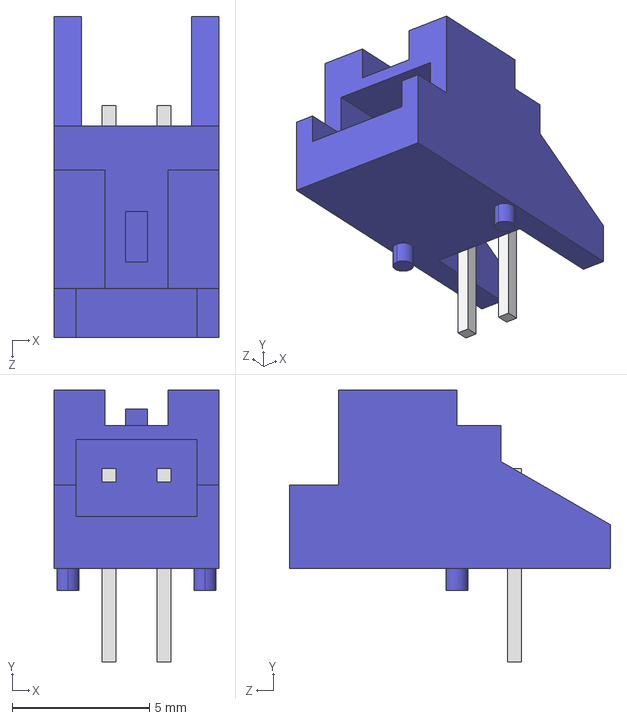
[picture p59: CAD file, 2023-01-22]
3DPackages/S02B-PASK-2.STEP
6.00 x 9.90 x 11.7 mm
