Polarisru/kicad6_library/3DPackages/C_Elec_8x10.2.step

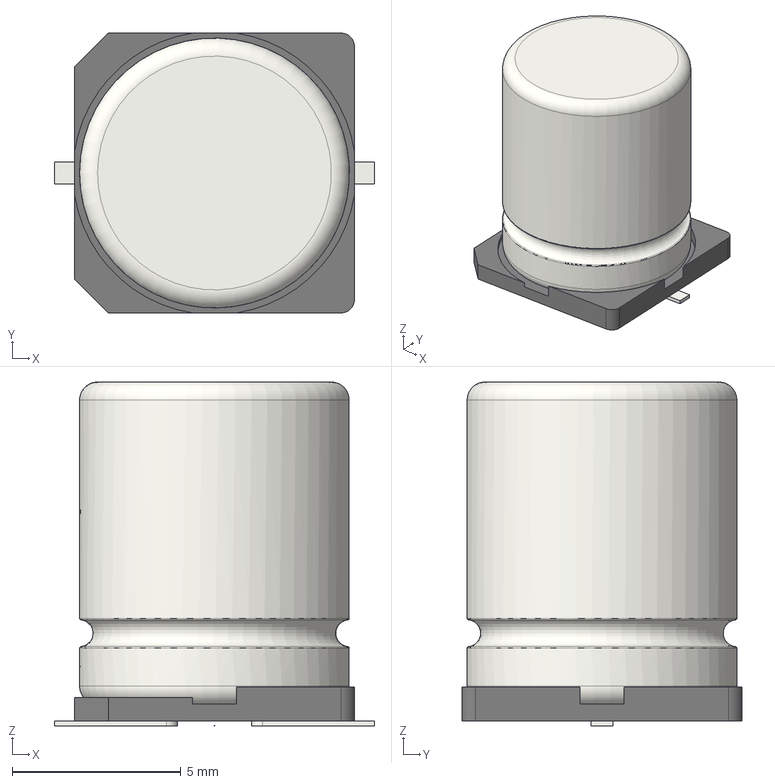
[picture p60: CAD file, 2023-01-22]
3DPackages/C_Elec_8x10.2.step
9.50 x 8.30 x 10.2 mm
