Polarisru/kicad6_library/3DPackages/SOT-363_SC-70-6.step

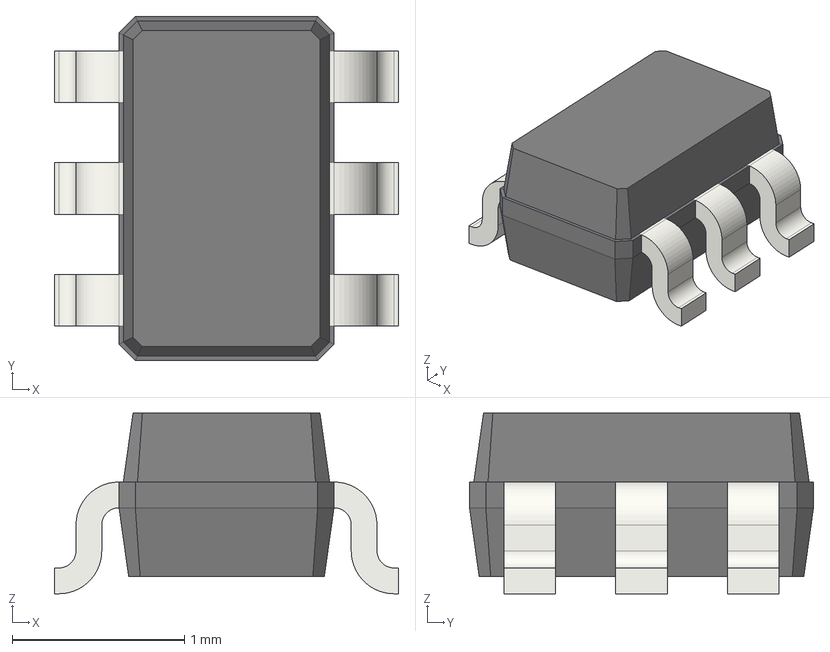
[picture p61: CAD file, 2023-01-22]
3DPackages/SOT-363_SC-70-6.step
2.00 x 2.00 x 1.05 mm
