Polarisru/kicad6_library/3DPackages/SOT-23-5.step

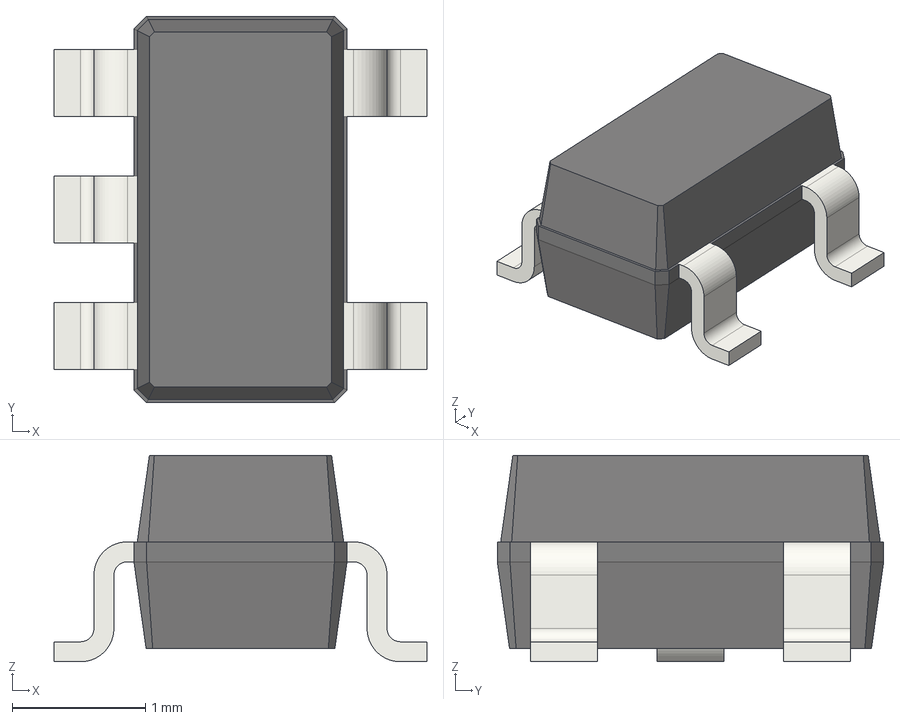
[picture p62: CAD file, 2023-01-22]
3DPackages/SOT-23-5.step
2.80 x 2.90 x 1.55 mm
