Polarisru/kicad6_library/3DPackages/PinHeader_2x04_P1.27mm_Vertical_SMD.step

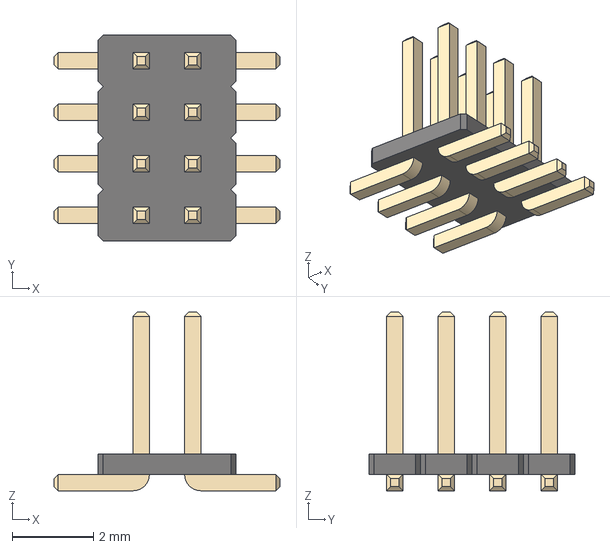
[picture p63: CAD file, 2023-01-22]
3DPackages/PinHeader_2x04_P1.27mm_Vertical_SMD.step
5.57 x 5.08 x 4.40 mm
