Polarisru/kicad6_library/3DPackages/Molex_MiniFit_Jr_1x02.step

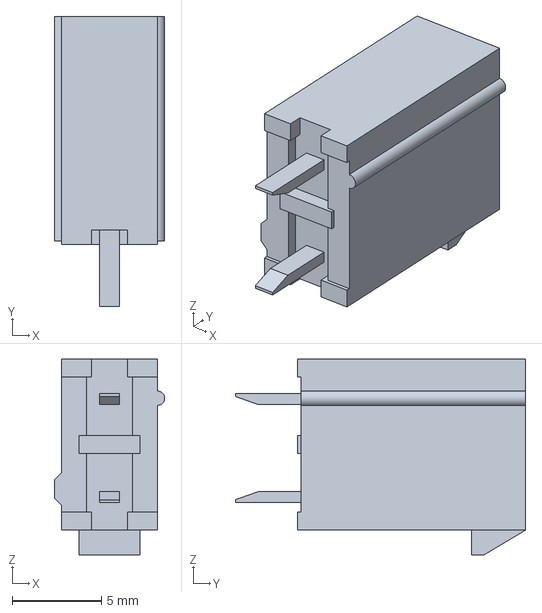
[picture p64: CAD file, 2023-01-22]
3DPackages/Molex_MiniFit_Jr_1x02.step
6.20 x 16.3 x 11.0 mm
