Polarisru/kicad6_library/3DPackages/JST_B4P-VH-FB-B.step

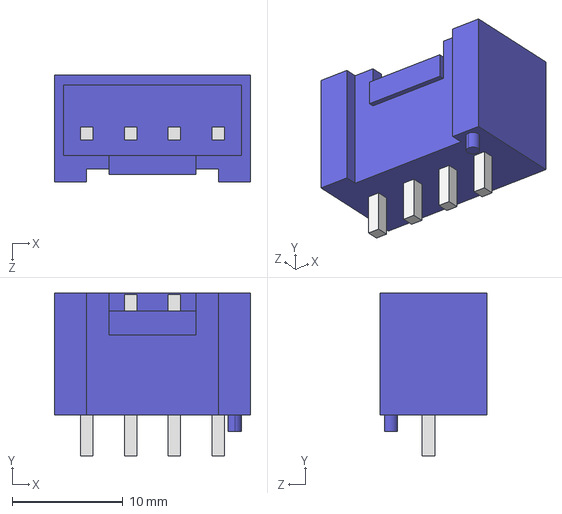
[picture p65: CAD file, 2023-01-22]
3DPackages/JST_B4P-VH-FB-B.step
17.7 x 14.7 x 9.70 mm
