Polarisru/kicad6_library/3DPackages/pin header 1x3 and jumper.step

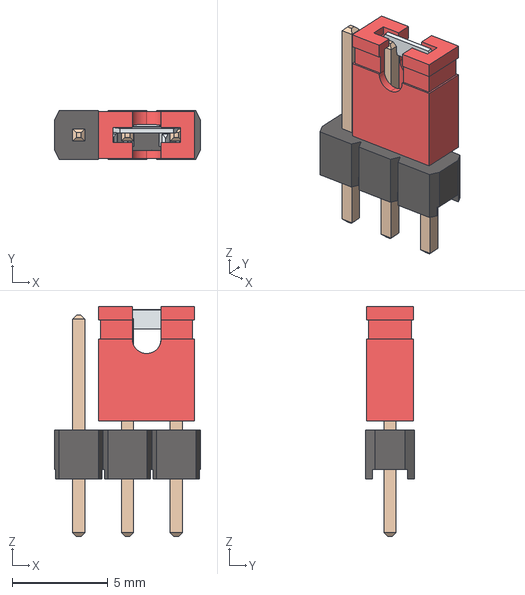
[picture p66: CAD file, 2023-01-22]
3DPackages/pin header 1x3 and jumper.step
7.62 x 2.54 x 12.0 mm
