Polarisru/kicad6_library/3DPackages/Relay Omron G6H-2 5VDC.STEP

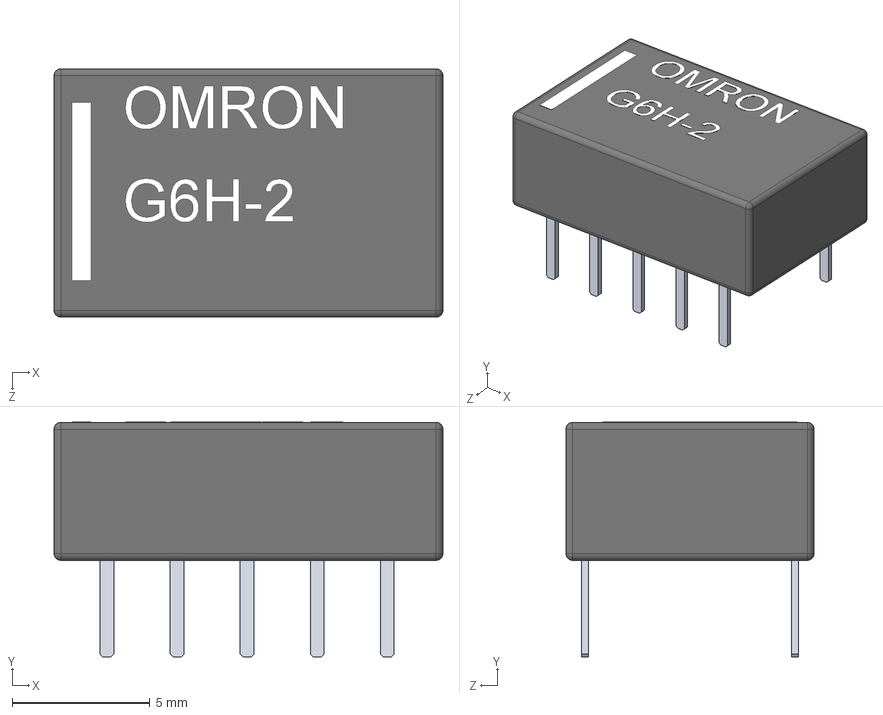
[picture p67: CAD file, 2023-01-22]
3DPackages/Relay Omron G6H-2 5VDC.STEP
14.1 x 8.51 x 9.00 mm
