Polarisru/kicad6_library/3DPackages/R_5W_SM_TE_Connectivity.stp

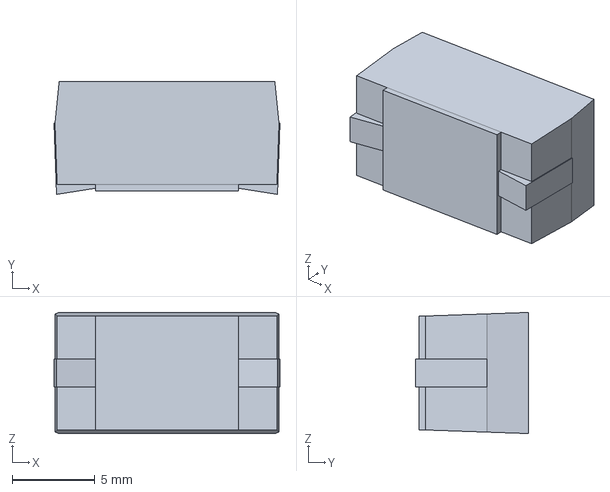
[picture p68: CAD file, 2023-01-22]
3DPackages/R_5W_SM_TE_Connectivity.stp
13.6 x 6.80 x 7.30 mm
