Polarisru/kicad6_library/3DPackages/R_0805_2012Metric.step

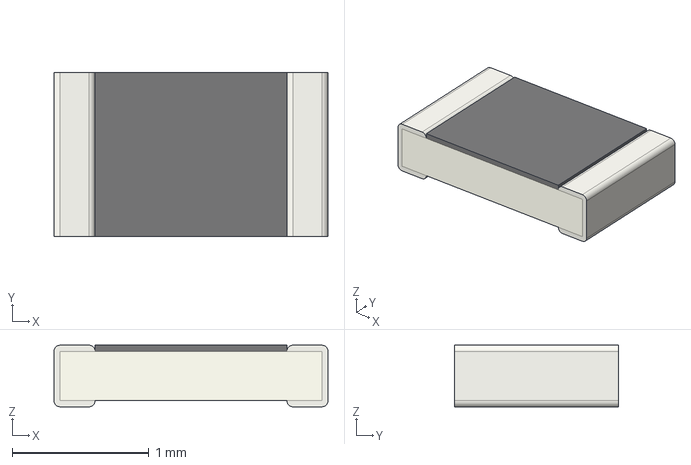
[picture p69: CAD file, 2023-01-22]
3DPackages/R_0805_2012Metric.step
2.00 x 1.20 x 0.45 mm
