Polarisru/kicad6_library/3DPackages/C_0402_1005Metric.step

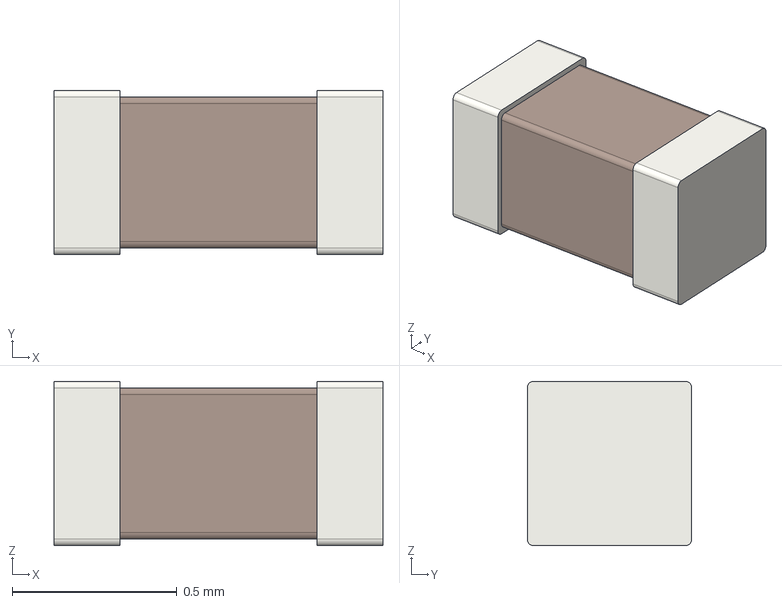
[picture p70: CAD file, 2023-01-22]
3DPackages/C_0402_1005Metric.step
1.00 x 0.5 x 0.5 mm
