Polarisru/kicad6_library/3DPackages/SSOP-16_3.9x4.9mm_P0.635mm.step

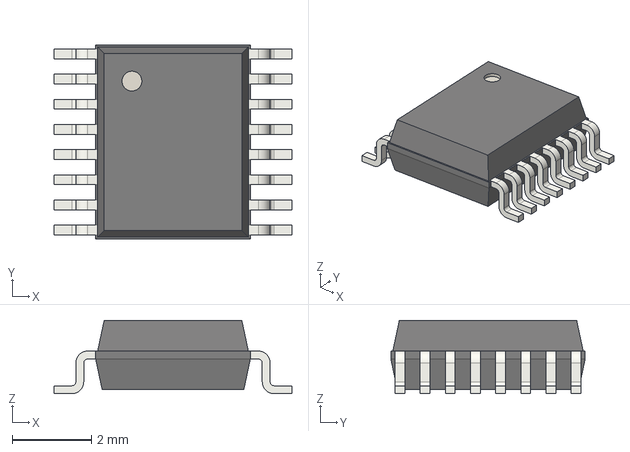
[picture p71: CAD file, 2023-01-22]
3DPackages/SSOP-16_3.9x4.9mm_P0.635mm.step
6.00 x 4.90 x 1.85 mm
