Polarisru/kicad6_library/3DPackages/SOT-23-6.step

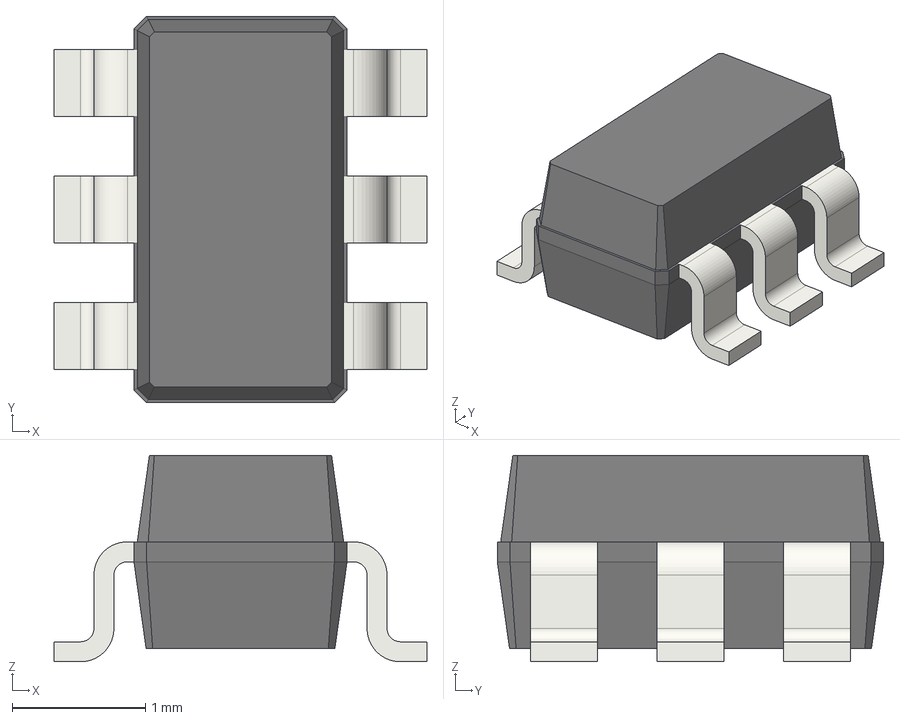
[picture p72: CAD file, 2023-01-22]
3DPackages/SOT-23-6.step
2.80 x 2.90 x 1.55 mm
