Polarisru/kicad6_library/3DPackages/QFN-48-1EP_7x7mm_P0.5mm_EP5.15x5.15mm.step

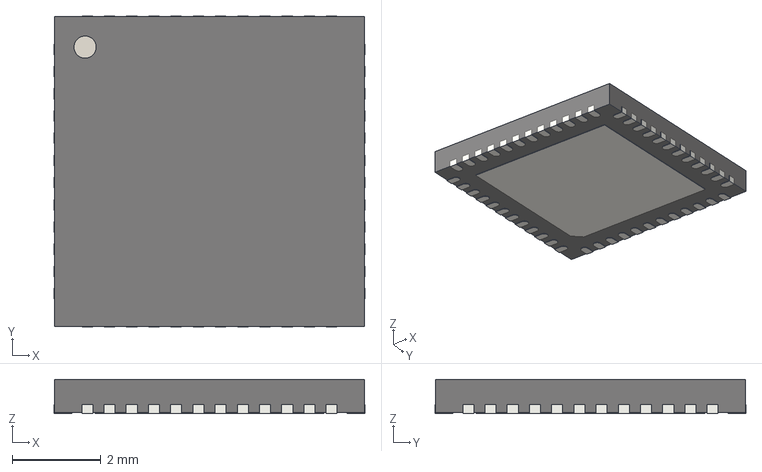
[picture p73: CAD file, 2023-01-22]
3DPackages/QFN-48-1EP_7x7mm_P0.5mm_EP5.15x5.15mm.step
7.00 x 7.00 x 0.77 mm
