Polarisru/kicad6_library/3DPackages/DB9F_Vertical.STEP

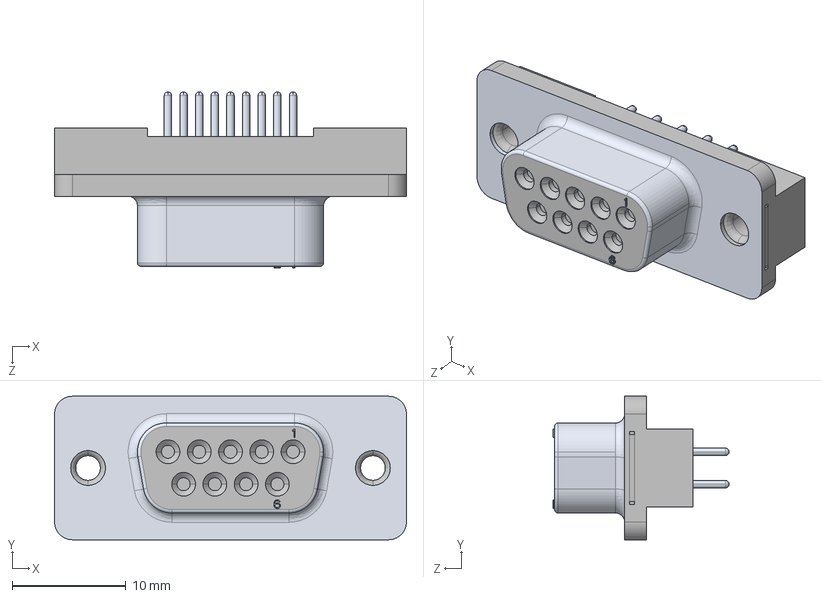
[picture p74: CAD file, 2023-01-22]
3DPackages/DB9F_Vertical.STEP
30.9 x 12.6 x 15.5 mm
