Polarisru/kicad6_library/3DPackages/QFN-40-1EP_6x6mm_P0.5mm_EP4.6x4.6mm.step

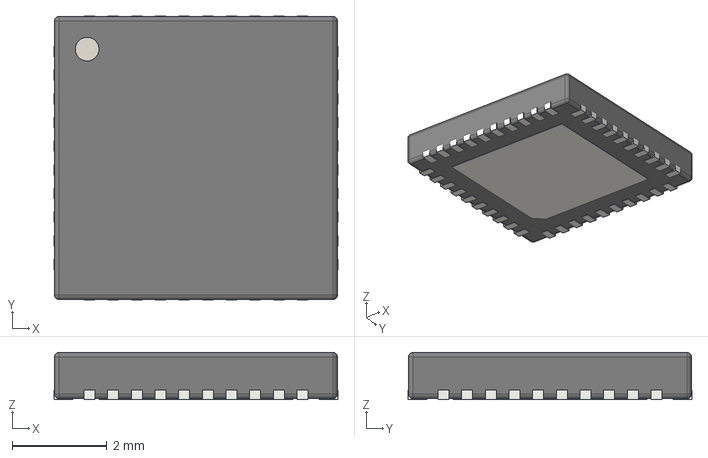
[picture p75: CAD file, 2023-01-22]
3DPackages/QFN-40-1EP_6x6mm_P0.5mm_EP4.6x4.6mm.step
6.00 x 6.00 x 1.00 mm
