Polarisru/kicad6_library/3DPackages/SOT-23-8.step

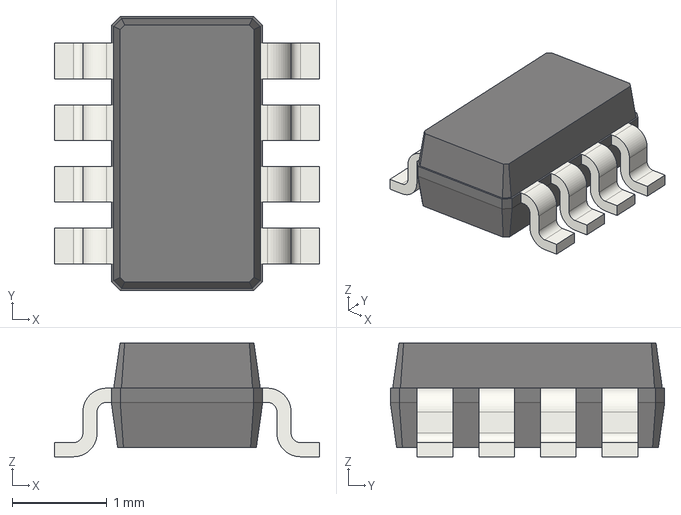
[picture p76: CAD file, 2023-01-22]
3DPackages/SOT-23-8.step
2.80 x 2.90 x 1.20 mm
