Polarisru/kicad6_library/3DPackages/PinHeader_2x03_P1.27mm_Vertical_SMD.step

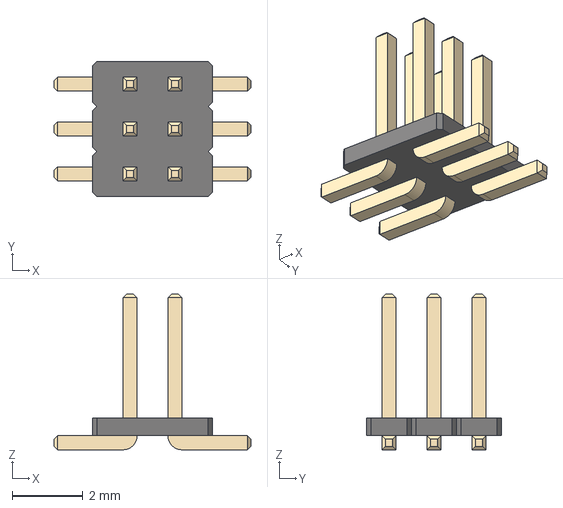
[picture p77: CAD file, 2023-01-22]
3DPackages/PinHeader_2x03_P1.27mm_Vertical_SMD.step
5.57 x 3.81 x 4.40 mm
