Polarisru/kicad6_library/3DPackages/Molex_MiniFit_Jr_2x02.step

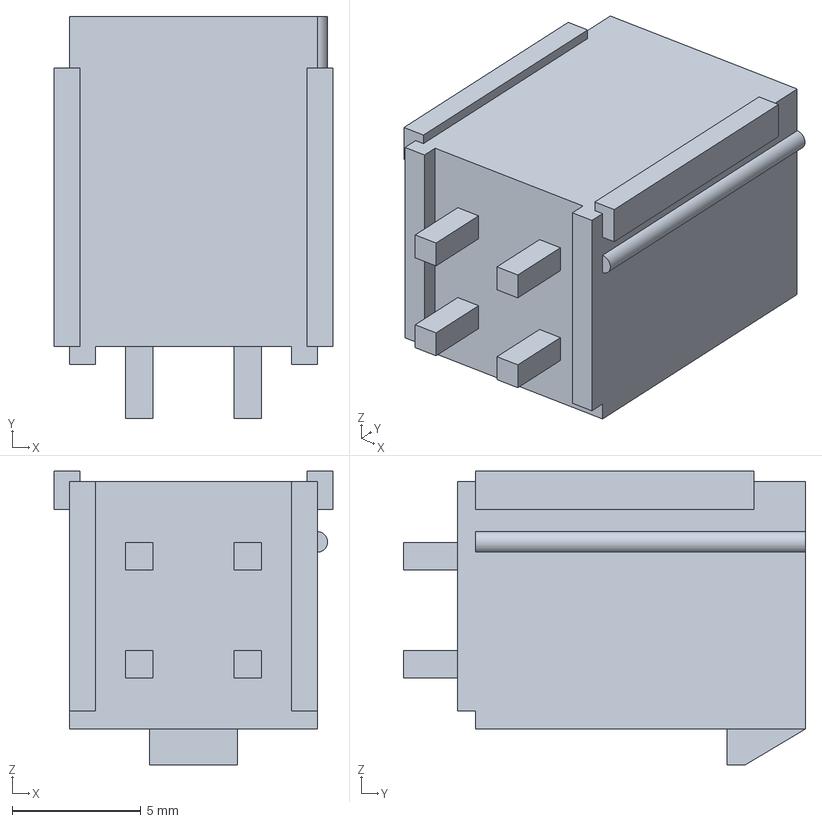
[picture p78: CAD file, 2023-01-22]
3DPackages/Molex_MiniFit_Jr_2x02.step
10.8 x 15.6 x 11.4 mm
