Polarisru/kicad6_library/3DPackages/pxc_1984714_02_PT-1-5-12-3-5-H_3D.stp

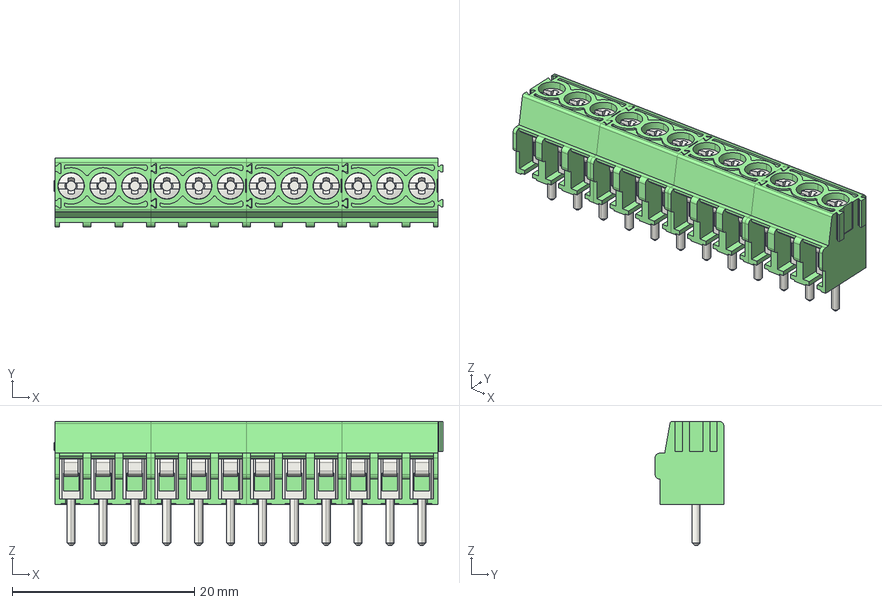
[picture p79: CAD file, 2023-01-22]
3DPackages/pxc_1984714_02_PT-1-5-12-3-5-H_3D.stp
42.7 x 7.55 x 13.6 mm
LP_PT_1_5_klh_3_5_horizontal.2 x 12
AC_PT_1_5_PVH_H0_Schraube.1 x 12
AT_PT_1_5_3_50_H x 4
