Polarisru/kicad6_library/3DPackages/SOT-223.step

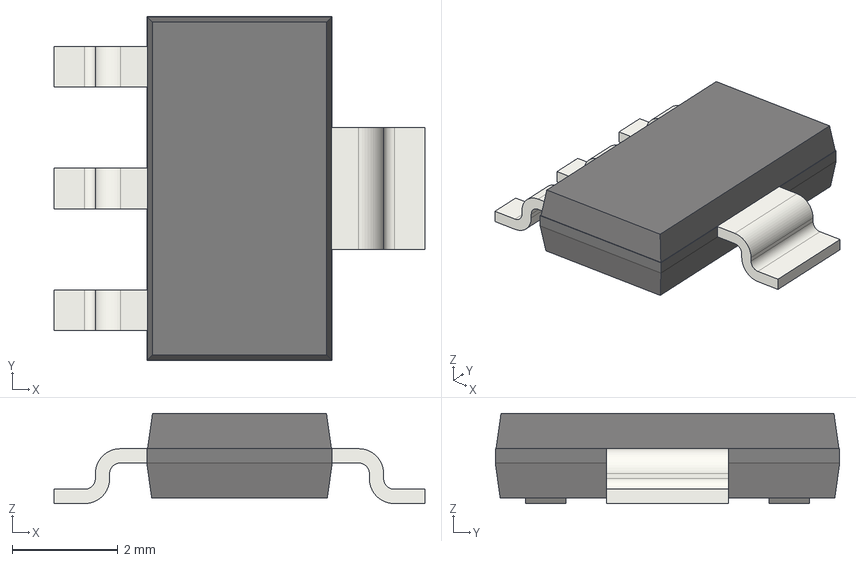
[picture p80: CAD file, 2023-01-22]
3DPackages/SOT-223.step
7.00 x 6.50 x 1.70 mm
