Polarisru/kicad6_library/3DPackages/B10B-PHDSS.step

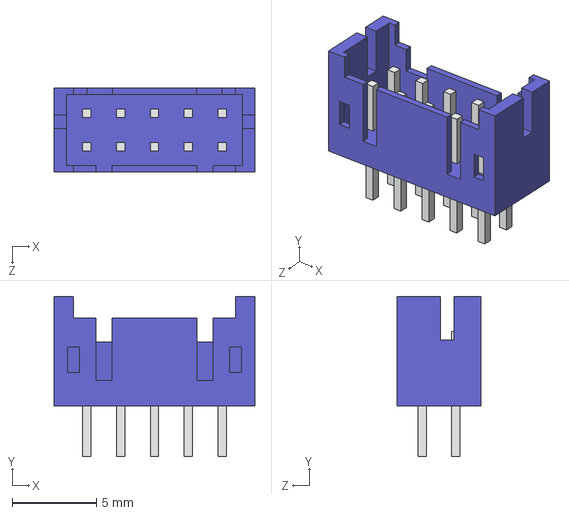
[picture p81: CAD file, 2023-01-22]
3DPackages/B10B-PHDSS.step
11.9 x 9.50 x 5.00 mm
