Polarisru/kicad6_library/3DPackages/FPC-40.stp

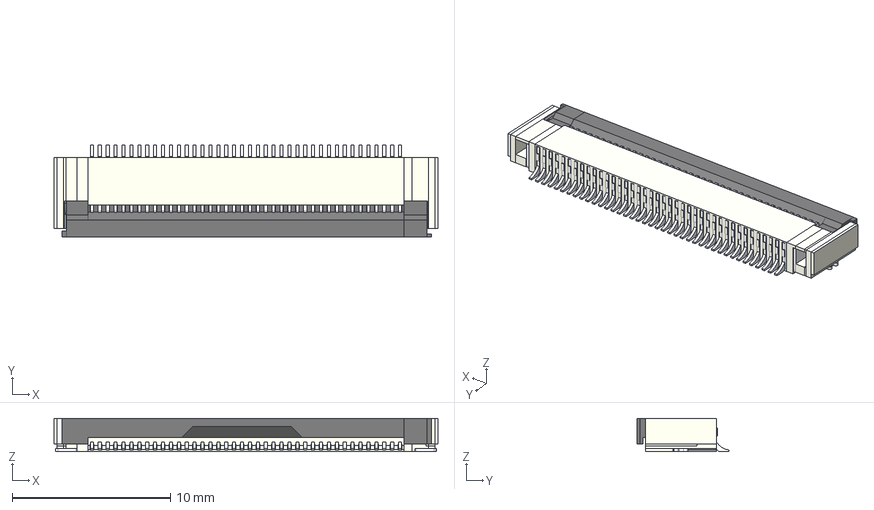
[picture p82: CAD file, 2023-01-22]
3DPackages/FPC-40.stp
24.3 x 5.85 x 2.11 mm
