Polarisru/kicad6_library/3DPackages/TEM_3-2423N.step

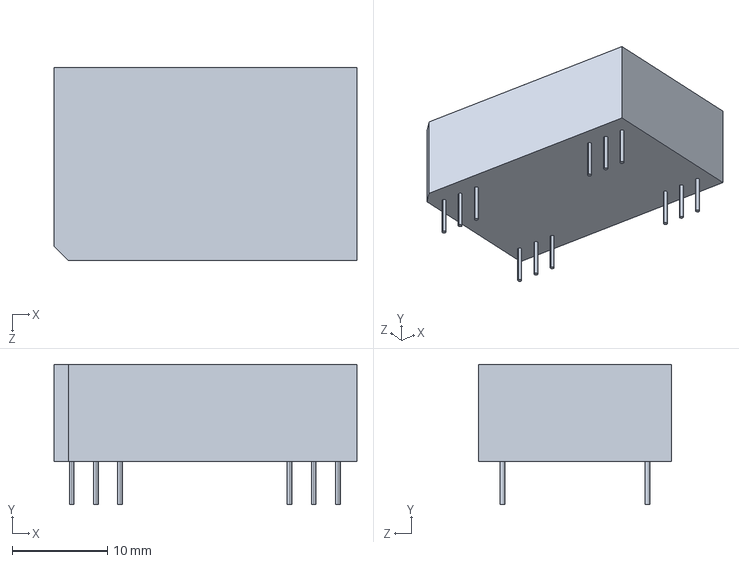
[picture p83: CAD file, 2023-01-22]
3DPackages/TEM_3-2423N.step
31.8 x 14.7 x 20.3 mm
