Polarisru/kicad6_library/3DPackages/WE_744877100.step

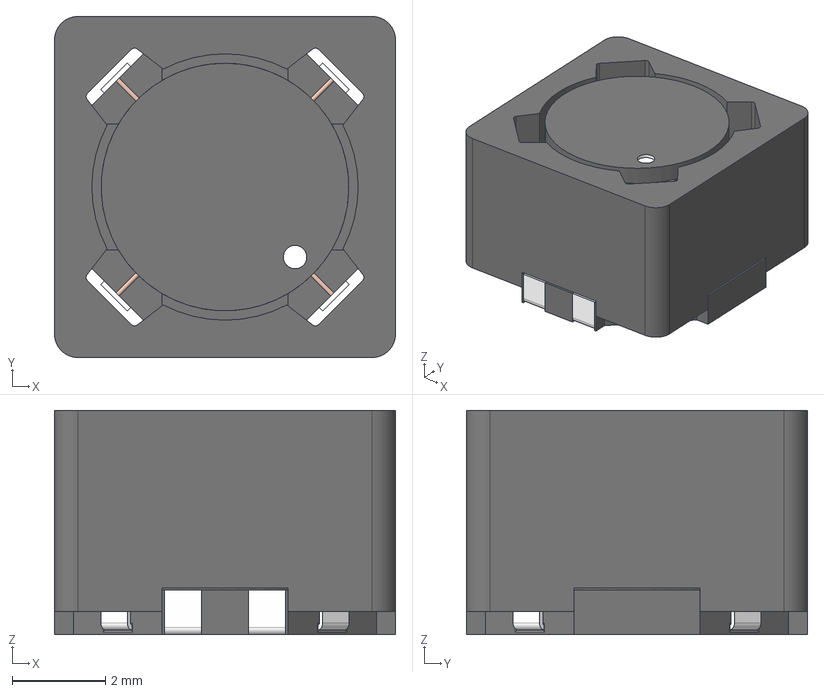
[picture p84: CAD file, 2023-01-22]
3DPackages/WE_744877100.step
7.30 x 7.30 x 4.80 mm
