Polarisru/kicad6_library/3DPackages/PinSocket_1x02_P2.54mm_Vertical.step

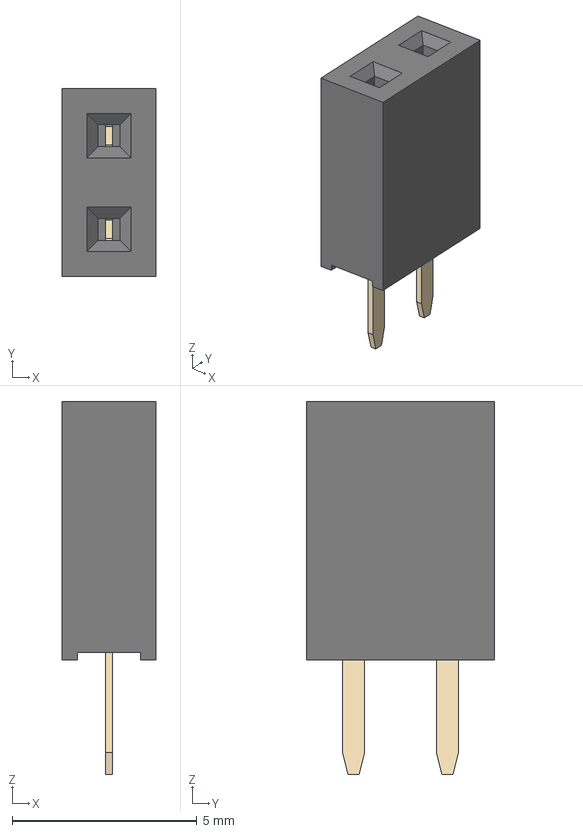
[picture p85: CAD file, 2023-01-22]
3DPackages/PinSocket_1x02_P2.54mm_Vertical.step
2.54 x 5.08 x 10.1 mm
