Polarisru/kicad6_library/3DPackages/C_Elec_6.3x5.8.step

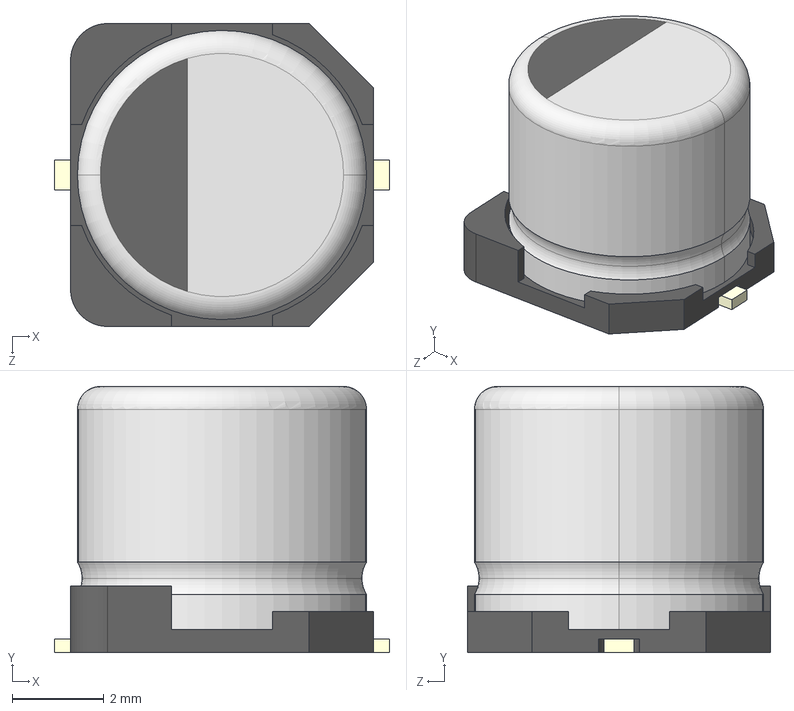
[picture p86: CAD file, 2023-01-22]
3DPackages/C_Elec_6.3x5.8.step
7.30 x 5.80 x 6.60 mm
標準SIZE CODE D-001
標準SIZE CODE D-002
標準SIZE CODE D-003 x 2
