Polarisru/kicad6_library/3DPackages/RW5S0FA10R0JE.stp

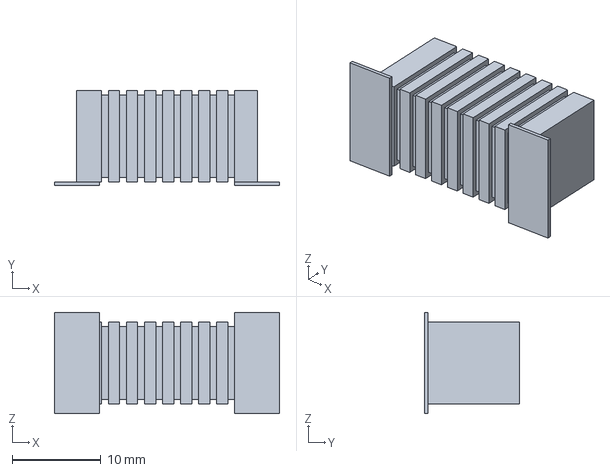
[picture p87: CAD file, 2023-01-22]
3DPackages/RW5S0FA10R0JE.stp
25.4 x 10.7 x 11.4 mm
