Polarisru/kicad6_library/3DPackages/D09P33E4GX00LFC.step

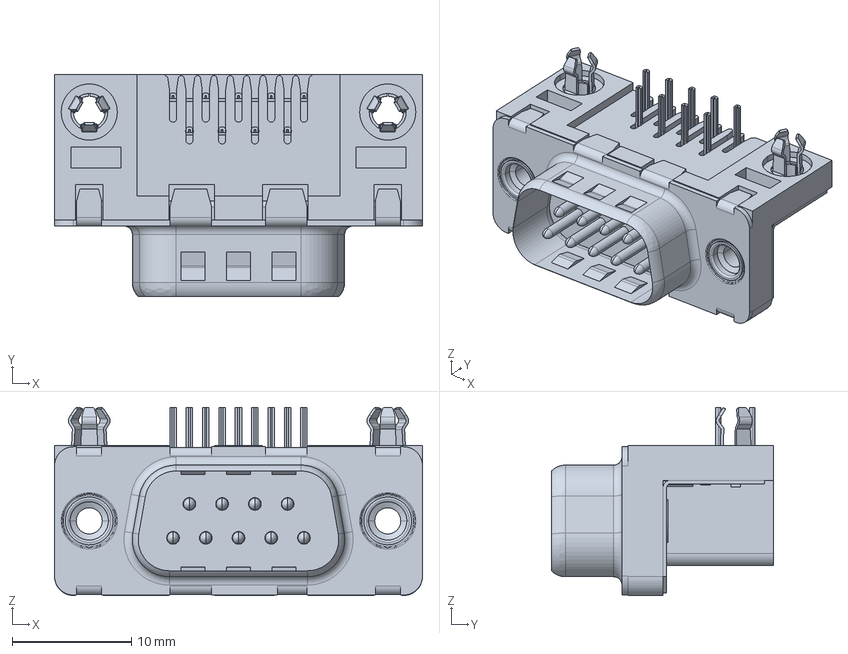
[picture p88: CAD file, 2023-01-22]
3DPackages/D09P33E4GX00LFC.step
30.8 x 18.6 x 15.8 mm
