Polarisru/kicad6_library/3DPackages/LED_0603_1608Metric.step

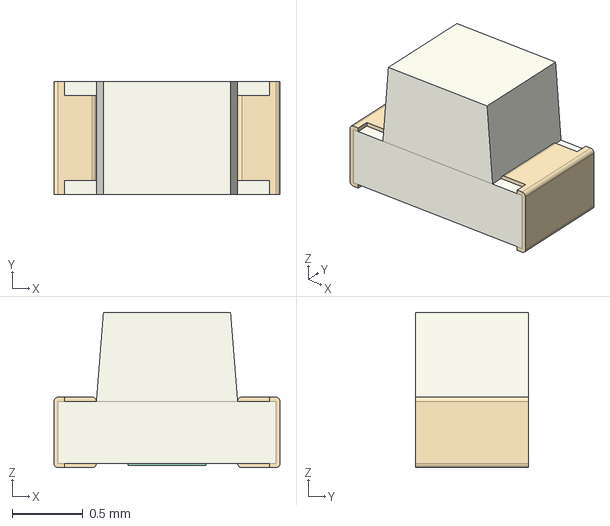
[picture p89: CAD file, 2023-01-22]
3DPackages/LED_0603_1608Metric.step
1.60 x 0.8 x 1.10 mm
