Polarisru/kicad6_library/3DPackages/Molex_Picoblade_1x03.step

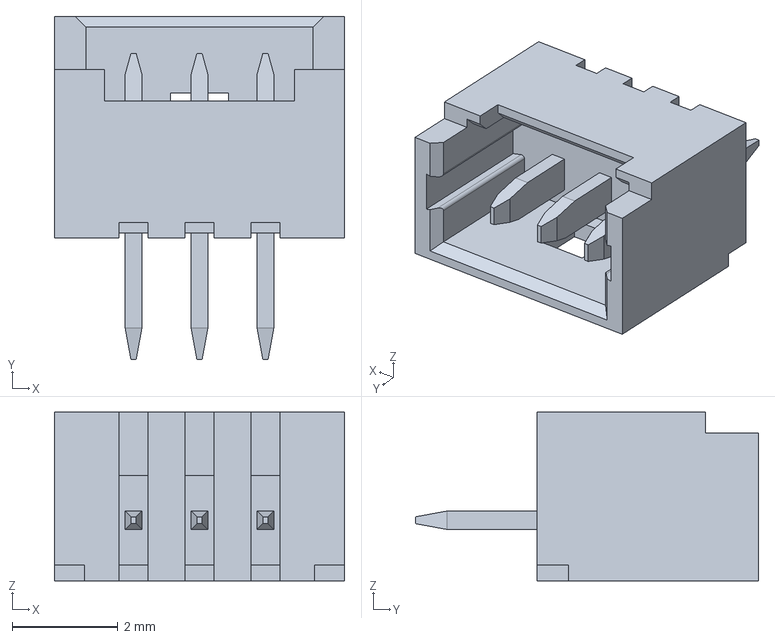
[picture p90: CAD file, 2023-01-22]
3DPackages/Molex_Picoblade_1x03.step
5.50 x 6.50 x 3.20 mm
