Polarisru/kicad6_library/3DPackages/WE-CMB-S_rev1.step

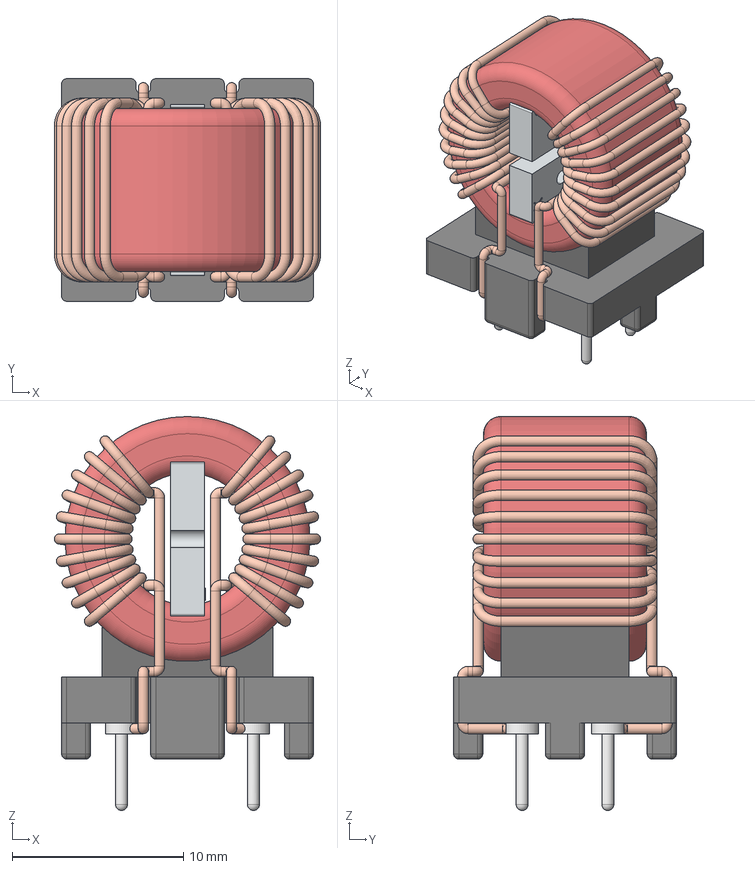
[picture p91: CAD file, 2023-01-22]
3DPackages/WE-CMB-S_rev1.step
15.5 x 13.0 x 23.0 mm
Base x 4
Klebemasse
Pin x 4
WE-CMB S-Model_data
