Polarisru/kicad6_library/3DPackages/B4B-EH.step

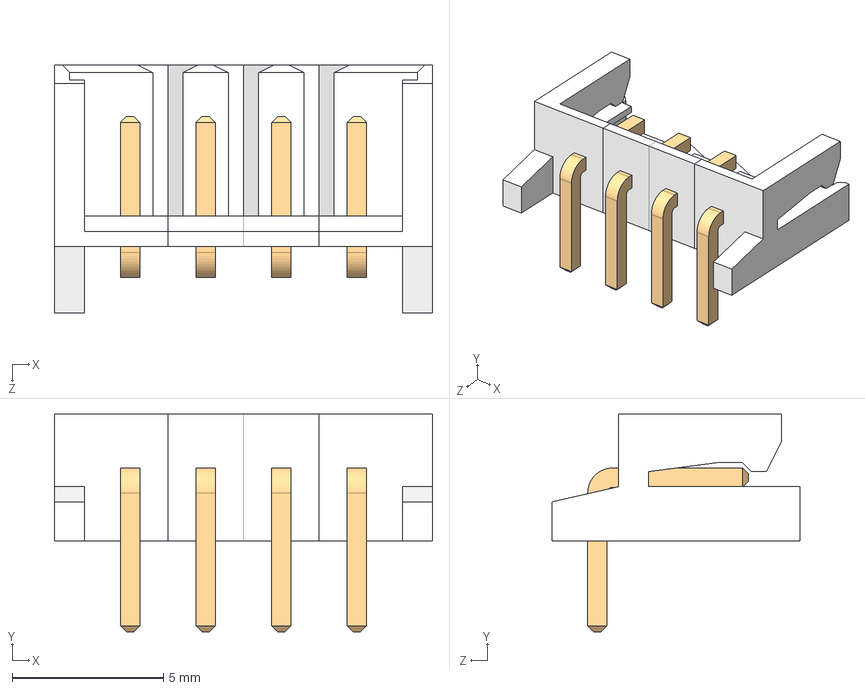
[picture p92: CAD file, 2023-01-22]
3DPackages/B4B-EH.step
12.5 x 7.20 x 8.20 mm
B2B-EH(膴骫)
B2B-EH(瀔鍎樉麔鍧) x 2
B2B-EH(膴骫2)
