Polarisru/kicad6_library/3DPackages/SNT-4A.step

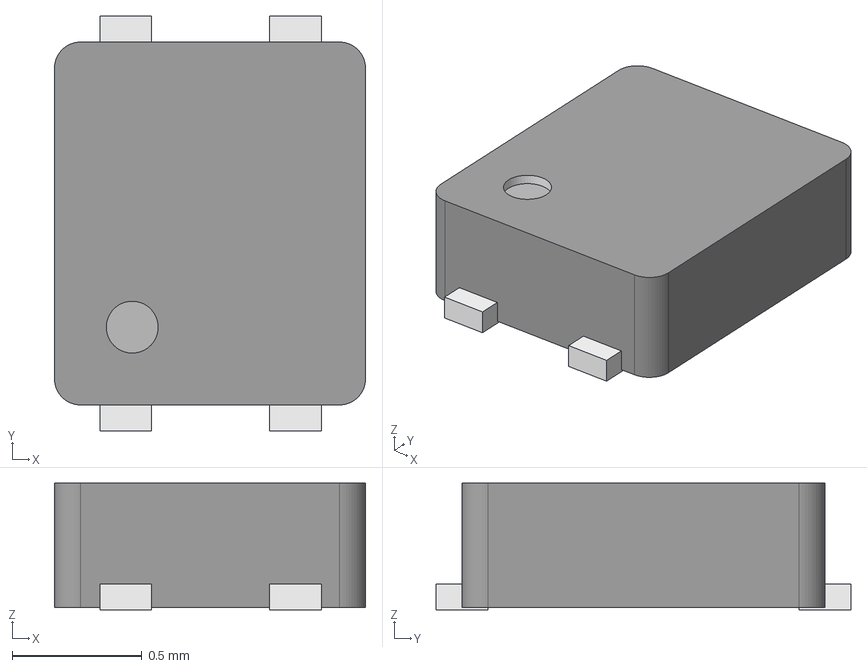
[picture p93: CAD file, 2023-01-22]
3DPackages/SNT-4A.step
1.20 x 1.60 x 0.49 mm
