Polarisru/kicad6_library/3DPackages/S04B-PASK-2.step

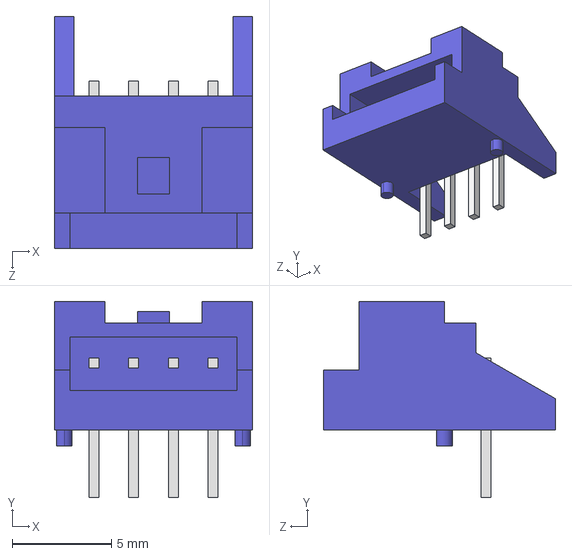
[picture p94: CAD file, 2023-01-22]
3DPackages/S04B-PASK-2.step
10.0 x 9.90 x 11.7 mm
