Polarisru/kicad6_library/3DPackages/EC11B15242AZ.STEP

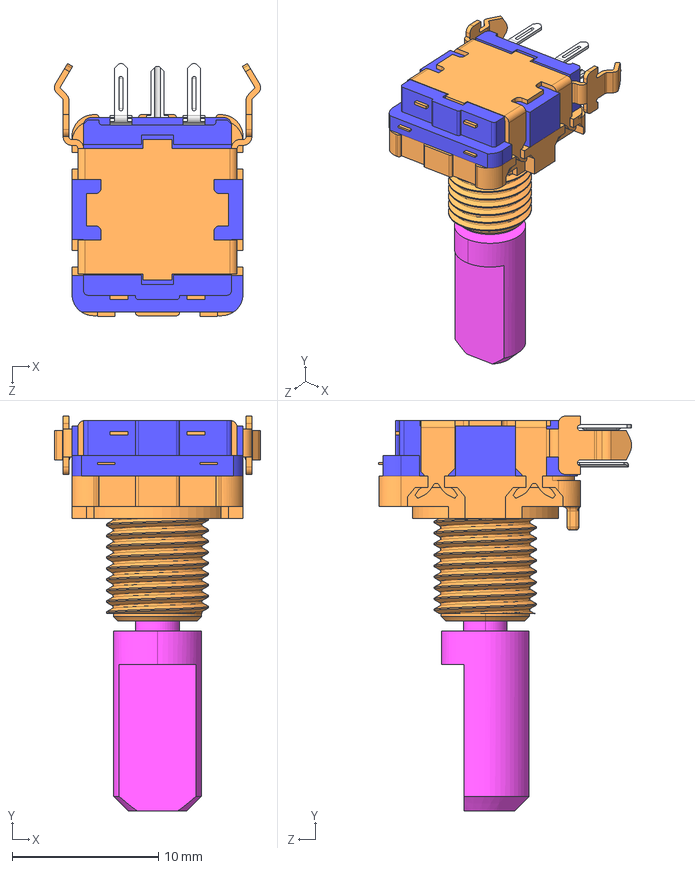
[picture p96: CAD file, 2023-01-22]
3DPackages/EC11B15242AZ.STEP
14.1 x 27.0 x 17.3 mm
