Polarisru/kicad6_library/3DPackages/SOIC-18W_7.5x11.6mm_P1.27mm.step

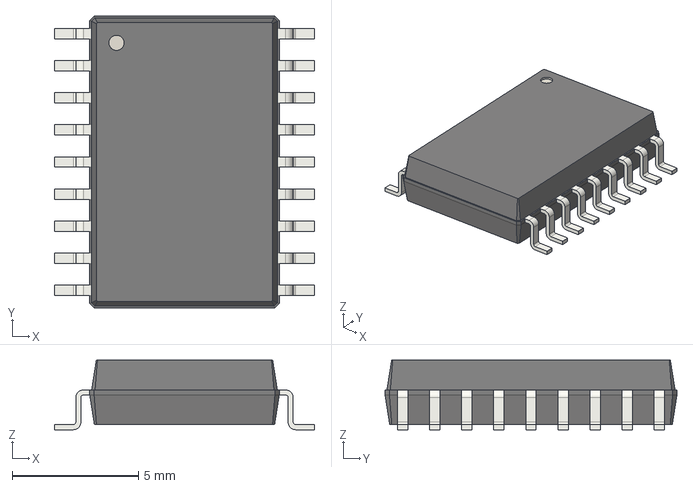
[picture p97: CAD file, 2023-01-22]
3DPackages/SOIC-18W_7.5x11.6mm_P1.27mm.step
10.3 x 11.6 x 2.75 mm
