Polarisru/kicad6_library/3DPackages/PinHeader_1x04_P2.54mm_Vertical.step

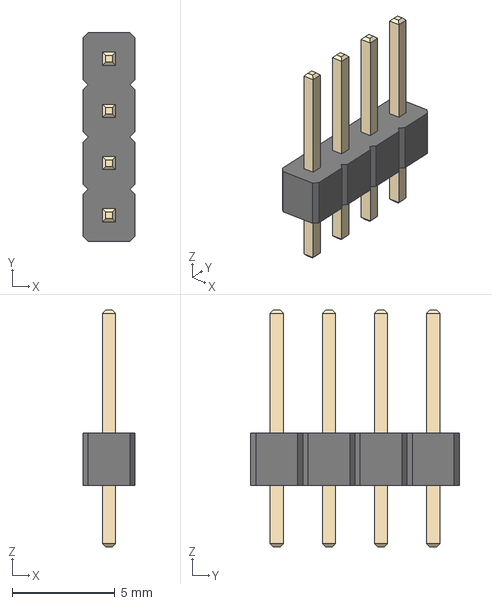
[picture p98: CAD file, 2023-01-22]
3DPackages/PinHeader_1x04_P2.54mm_Vertical.step
2.54 x 10.2 x 11.5 mm
