Polarisru/kicad6_library/3DPackages/DSUB-9_Female_Vertical_P2.77x2.84mm_MountingHoles.step

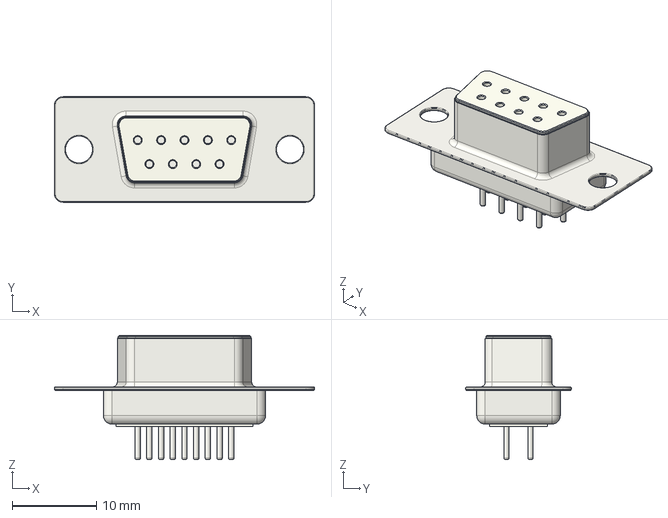
[picture p99: CAD file, 2023-01-22]
3DPackages/DSUB-9_Female_Vertical_P2.77x2.84mm_MountingHoles.step
30.8 x 12.5 x 14.7 mm
