Polarisru/kicad6_library/3DPackages/PinHeader_1x02_P2.54mm_Vertical.step

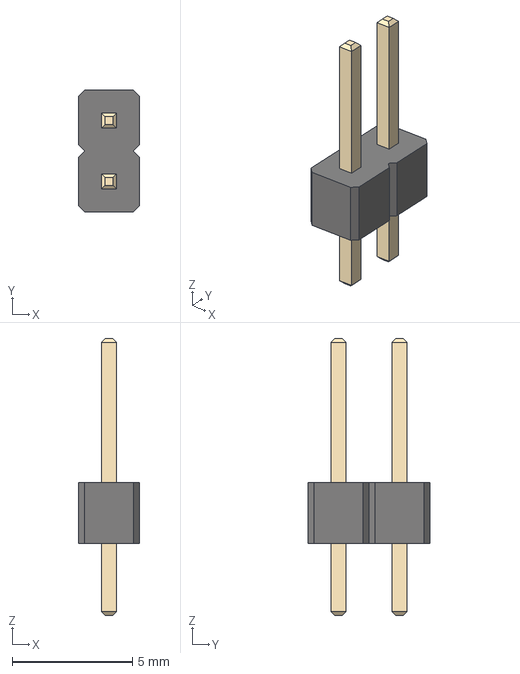
[picture p100: CAD file, 2023-01-22]
3DPackages/PinHeader_1x02_P2.54mm_Vertical.step
2.54 x 5.08 x 11.5 mm
