Polarisru/kicad6_library/3DPackages/Molex_MicroFit_2x03.step

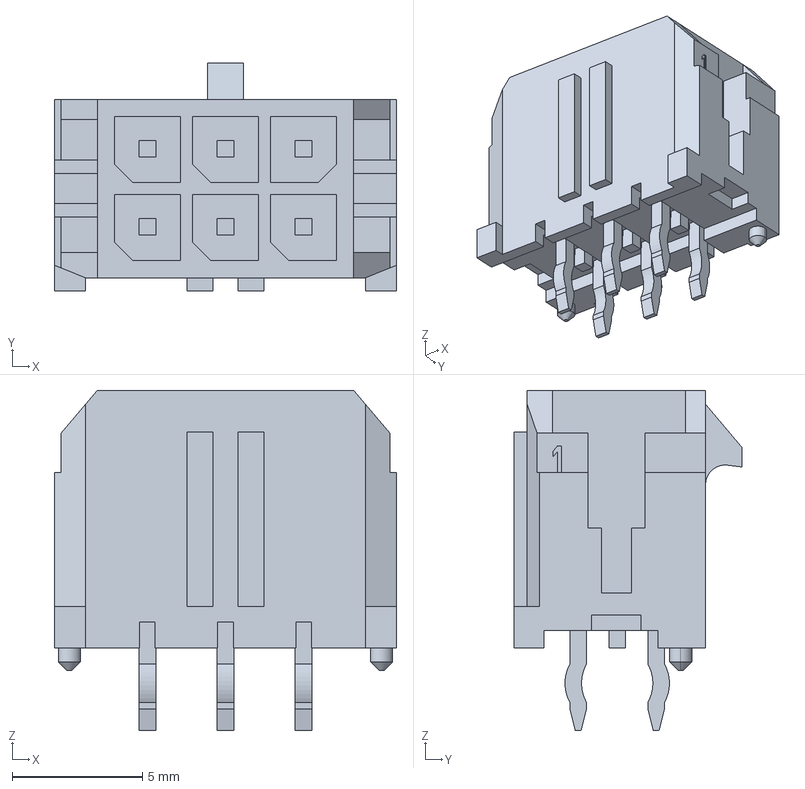
[picture p101: CAD file, 2023-01-22]
3DPackages/Molex_MicroFit_2x03.step
13.2 x 8.77 x 13.1 mm
