Polarisru/kicad6_library/3DPackages/srf1260.stp

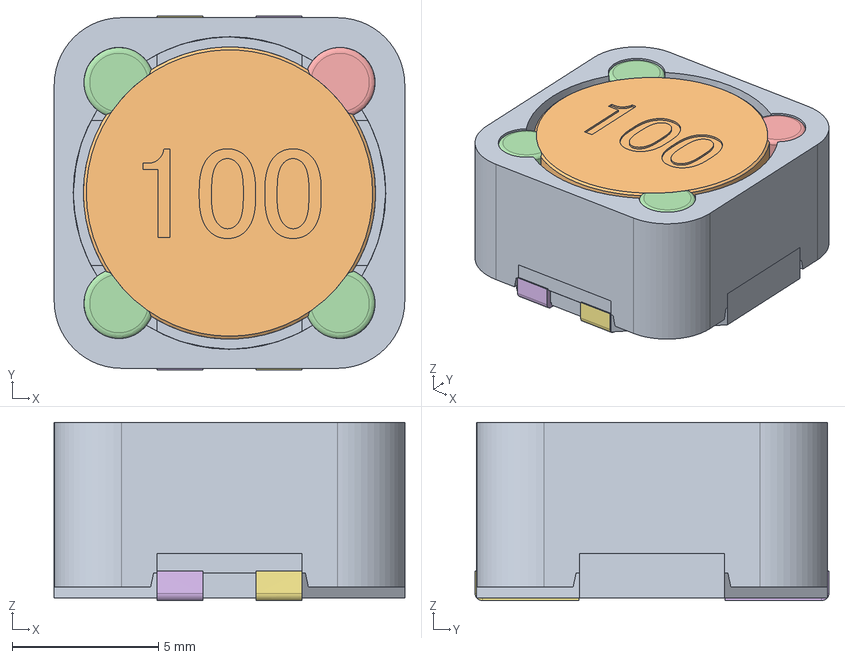
[picture p102: CAD file, 2023-01-22]
3DPackages/srf1260.stp
12.0 x 12.1 x 6.09 mm
