Polarisru/kicad6_library/3DPackages/C_1206_3216Metric.step

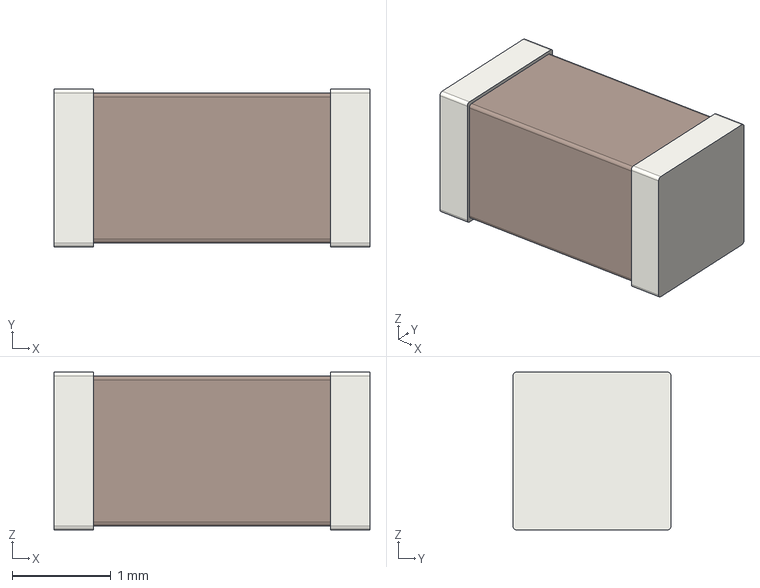
[picture p103: CAD file, 2023-01-22]
3DPackages/C_1206_3216Metric.step
3.20 x 1.60 x 1.60 mm
