Polarisru/kicad6_library/3DPackages/UDFN-4L_STM.step

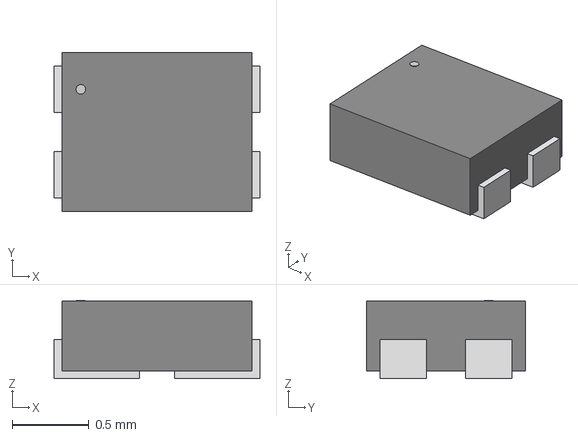
[picture p104: CAD file, 2023-01-22]
3DPackages/UDFN-4L_STM.step
1.35 x 1.04 x 0.511 mm
