Polarisru/kicad6_library/3DPackages/TES 1-2411.step

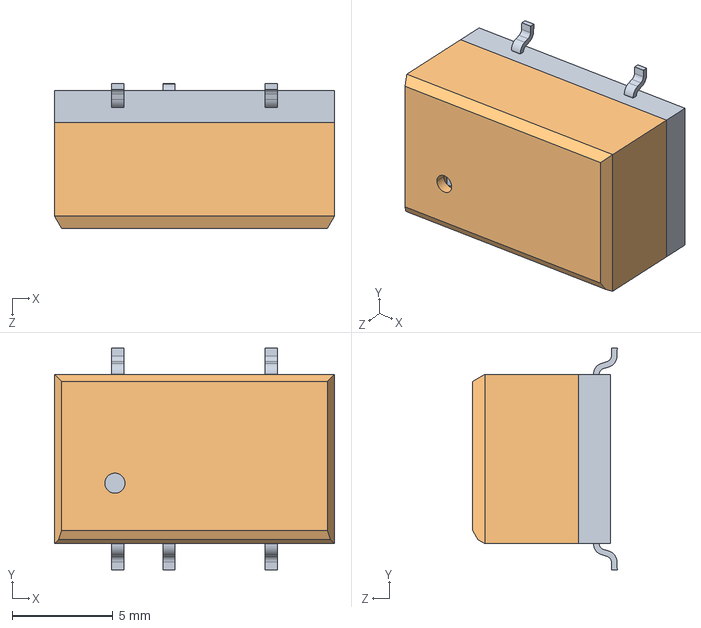
[picture p105: CAD file, 2023-01-22]
3DPackages/TES 1-2411.step
13.9 x 11.0 x 7.18 mm
base
cover
