Polarisru/kicad6_library/3DPackages/TO-247.step

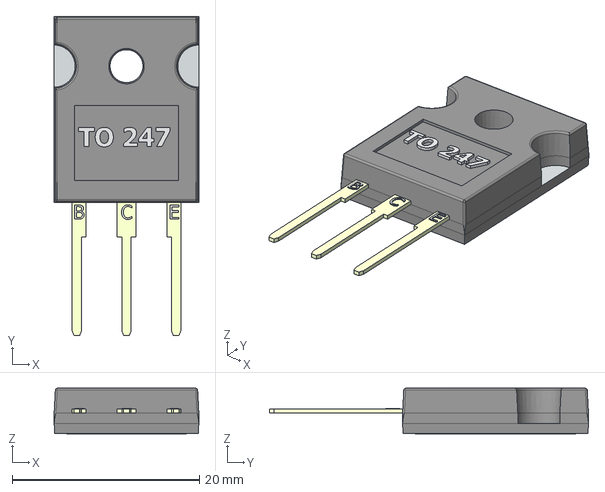
[picture p107: CAD file, 2023-01-22]
3DPackages/TO-247.step
15.4 x 34.0 x 4.86 mm
