Polarisru/kicad6_library/3DPackages/Spule22mm.STEP

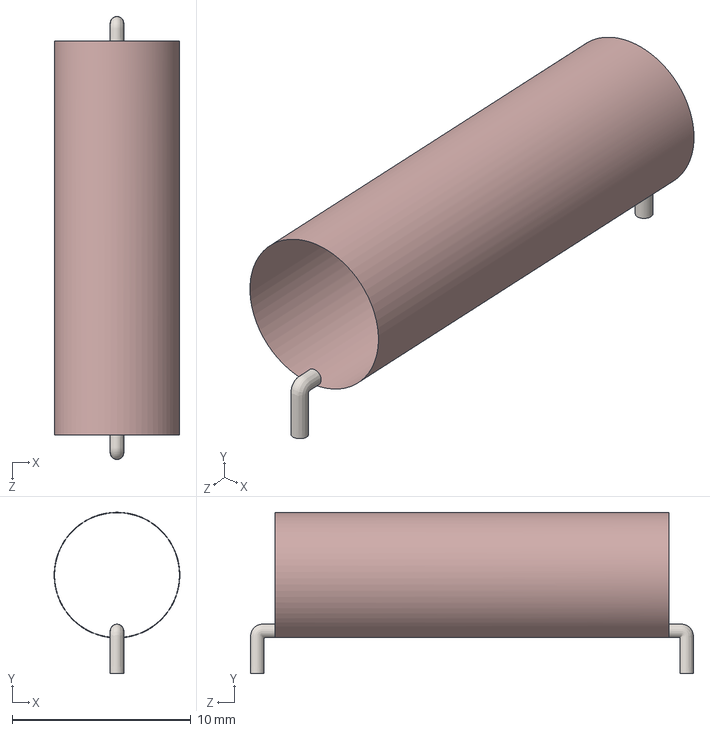
[picture p108: CAD file, 2023-01-22]
3DPackages/Spule22mm.STEP
7.00 x 9.00 x 24.8 mm
