Polarisru/kicad6_library/3DPackages/DFN-8-1EP_3x2mm_P0.5mm_EP1.3x1.5mm.step

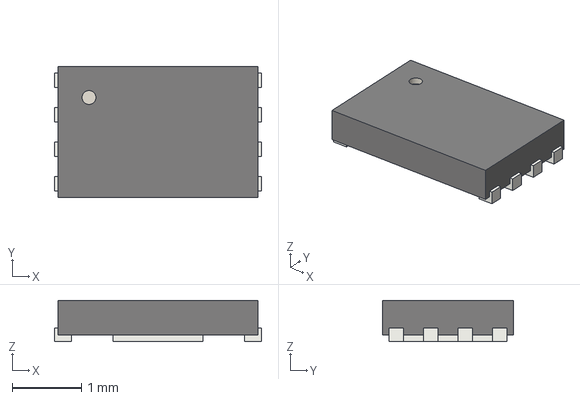
[picture p109: CAD file, 2023-01-22]
3DPackages/DFN-8-1EP_3x2mm_P0.5mm_EP1.3x1.5mm.step
3.00 x 1.90 x 0.6 mm
