Polarisru/kicad6_library/3DPackages/TO-247AC-HB.step

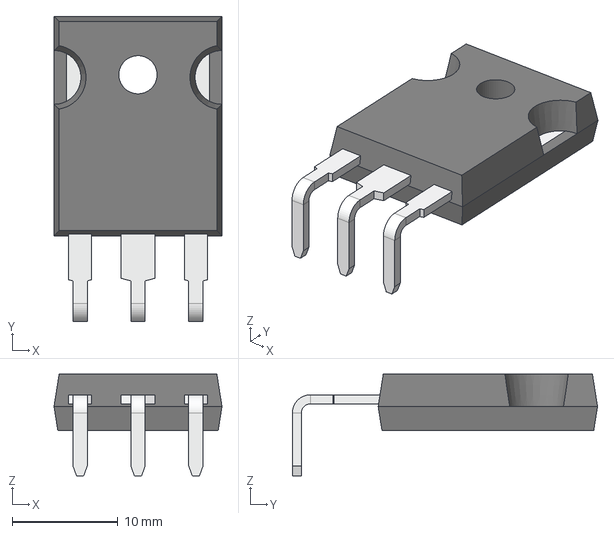
[picture p110: CAD file, 2023-01-22]
3DPackages/TO-247AC-HB.step
15.8 x 28.8 x 9.60 mm
