Polarisru/kicad6_library/3DPackages/EC11E-05SW.STEP

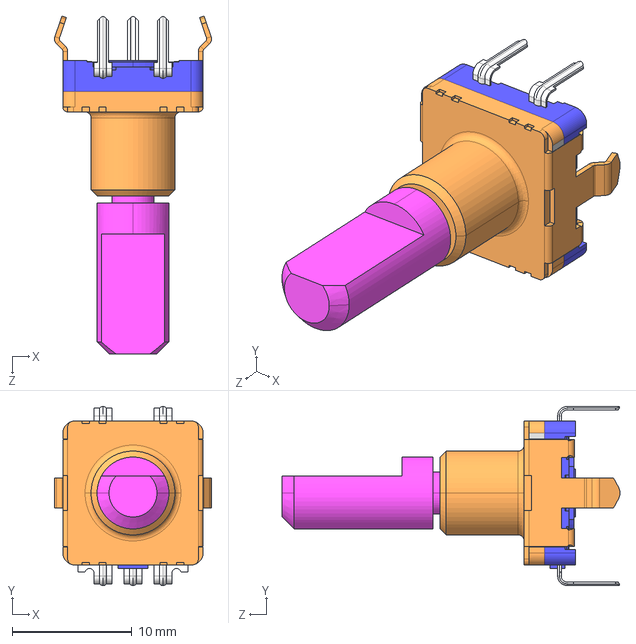
[picture p111: CAD file, 2023-01-22]
3DPackages/EC11E-05SW.STEP
13.1 x 15.0 x 28.2 mm
