Polarisru/kicad6_library/3DPackages/DFN-8-1EP_2x2mm_P0.5mm_EP0.7x1.3mm.step

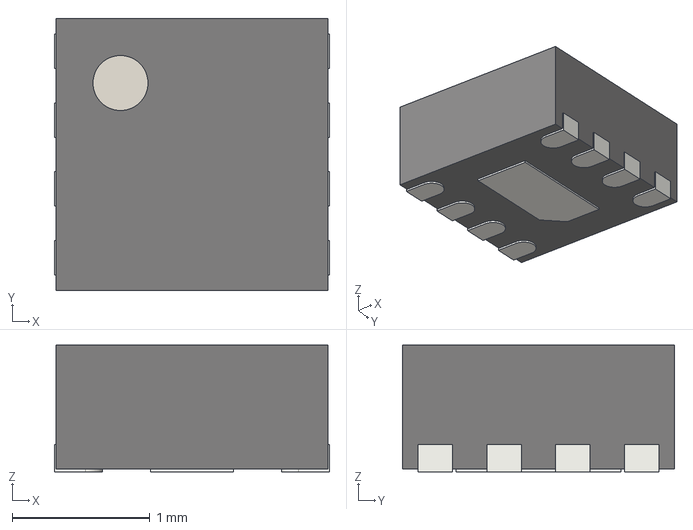
[picture p112: CAD file, 2023-01-22]
3DPackages/DFN-8-1EP_2x2mm_P0.5mm_EP0.7x1.3mm.step
2.00 x 1.98 x 0.92 mm
