Polarisru/kicad6_library/3DPackages/D_SOD-123F.step

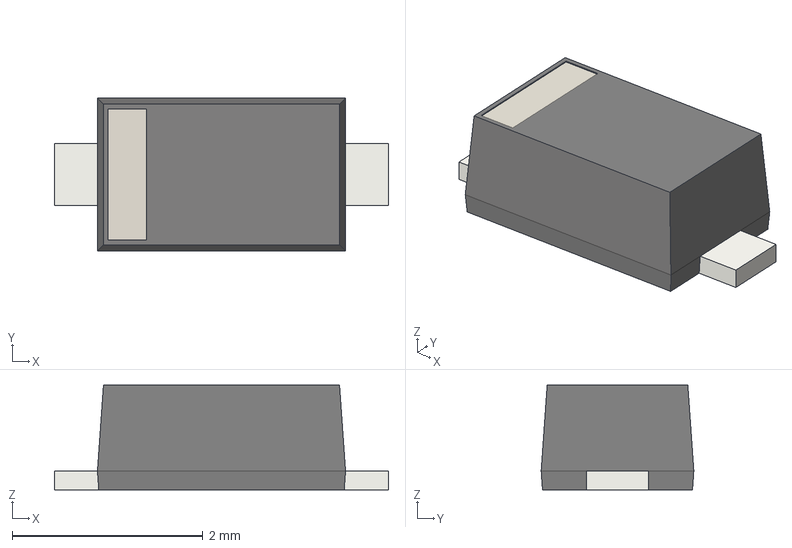
[picture p113: CAD file, 2023-01-22]
3DPackages/D_SOD-123F.step
3.50 x 1.60 x 1.10 mm
