Polarisru/kicad6_library/3DPackages/WE-CMB-XS.stp

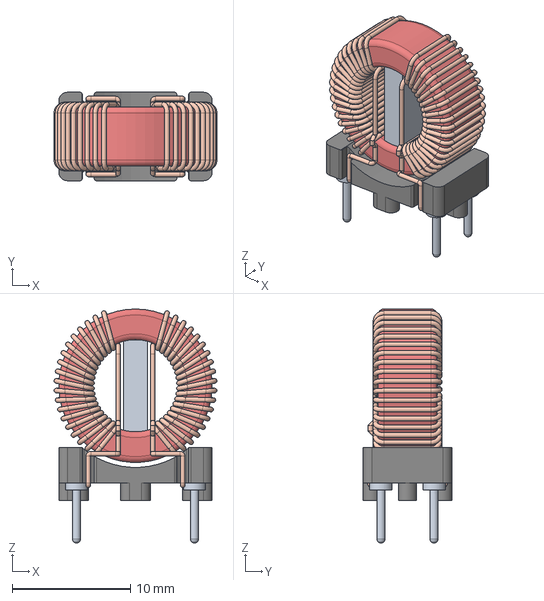
[picture p114: CAD file, 2023-01-22]
3DPackages/WE-CMB-XS.stp
13.8 x 7.50 x 19.8 mm
