Polarisru/kicad6_library/3DPackages/JST_EH_B4B-EH-A_1x04_P2.50mm_Vertical.step

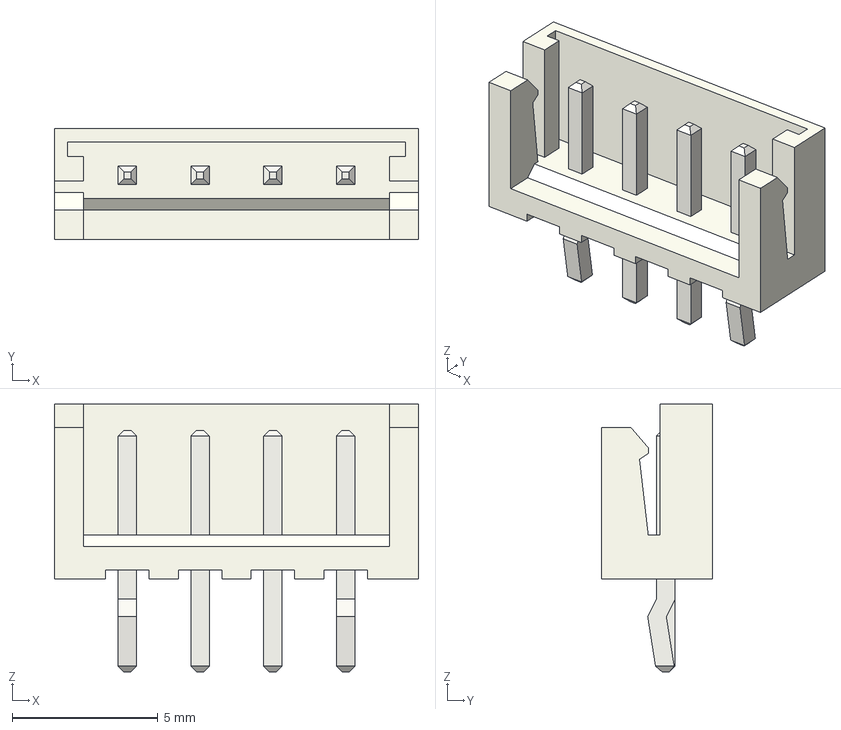
[picture p115: CAD file, 2023-01-22]
3DPackages/JST_EH_B4B-EH-A_1x04_P2.50mm_Vertical.step
12.5 x 3.80 x 9.20 mm
