Polarisru/kicad6_library/3DPackages/JST_EH_B7B-EH-A_1x07_P2.50mm_Vertical.step

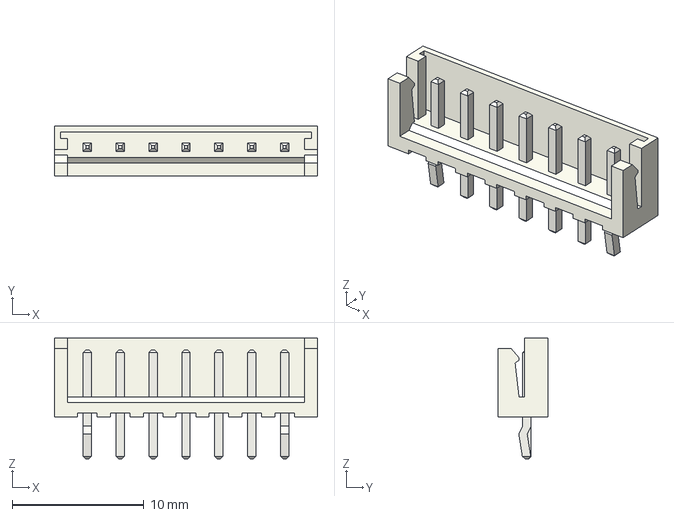
[picture p116: CAD file, 2023-01-22]
3DPackages/JST_EH_B7B-EH-A_1x07_P2.50mm_Vertical.step
20.0 x 3.80 x 9.20 mm
