Polarisru/kicad6_library/3DPackages/DSBGA-6__CASE-YZP0006.step

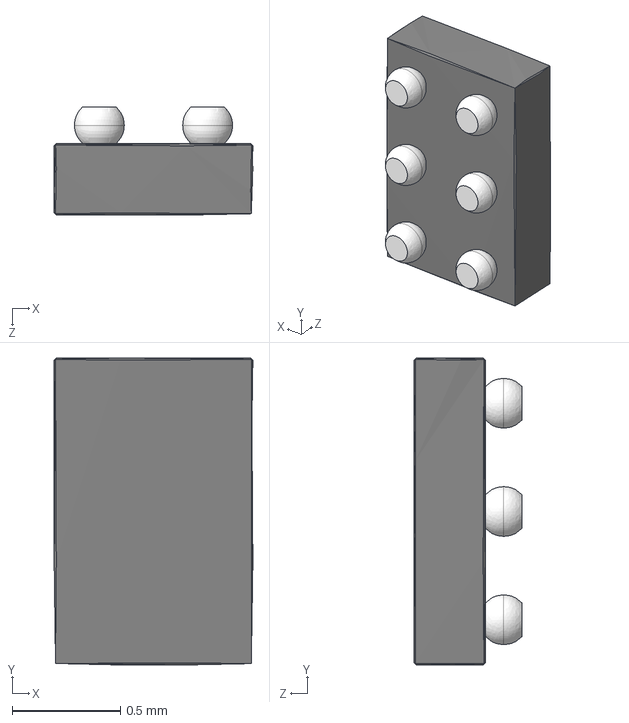
[picture p117: CAD file, 2023-01-22]
3DPackages/DSBGA-6__CASE-YZP0006.step
0.918 x 1.42 x 0.5 mm
