Polarisru/kicad6_library/3DPackages/TO-252-2.step

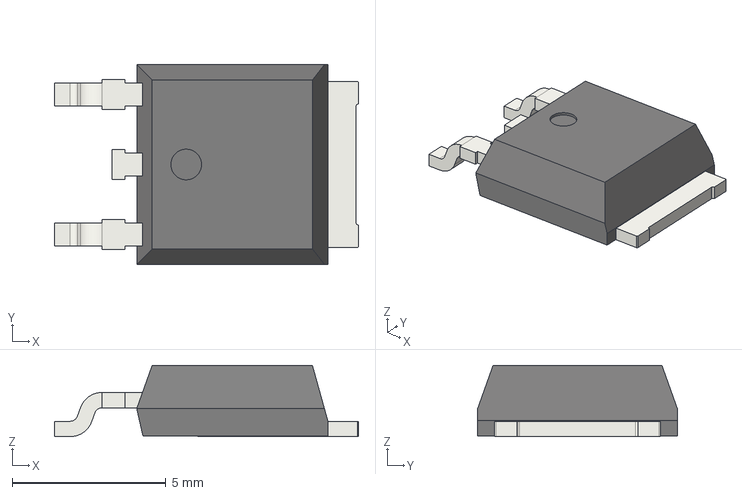
[picture p118: CAD file, 2023-01-22]
3DPackages/TO-252-2.step
9.90 x 6.50 x 2.32 mm
