Polarisru/kicad6_library/3DPackages/CRR-106-M120.step

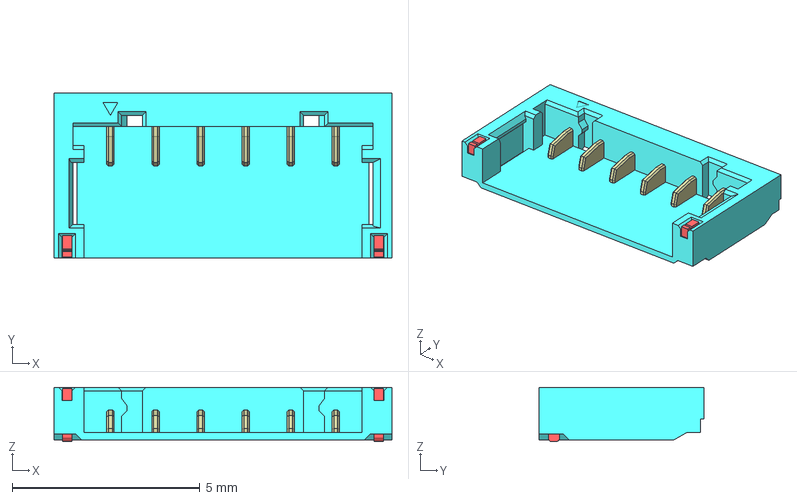
[picture p119: CAD file, 2023-01-22]
3DPackages/CRR-106-M120.step
9.00 x 4.40 x 1.45 mm
