Polarisru/kicad6_library/3DPackages/Molex_Picoblade_1x04.step

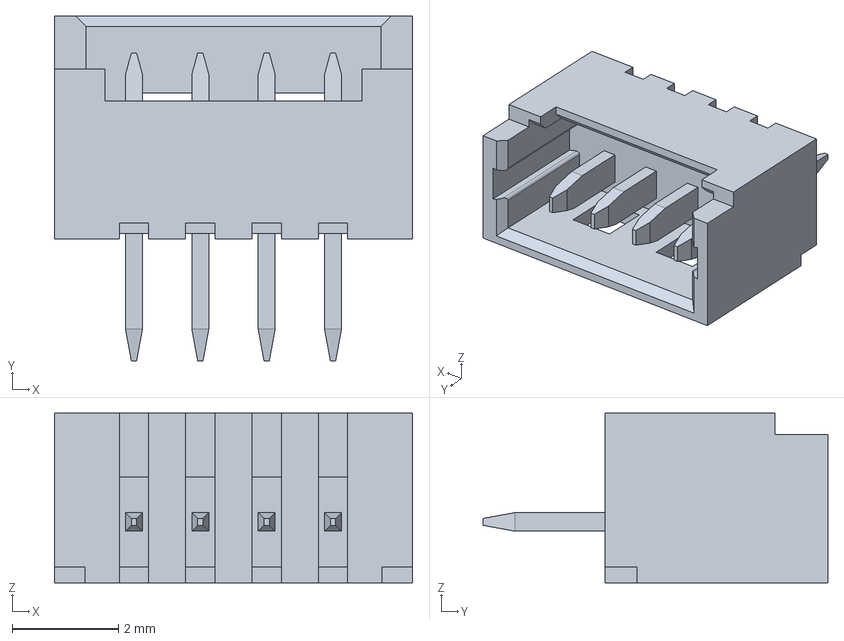
[picture p120: CAD file, 2023-01-22]
3DPackages/Molex_Picoblade_1x04.step
6.75 x 6.50 x 3.20 mm
