Polarisru/kicad6_library/3DPackages/Doat-5volt Relay v1.step

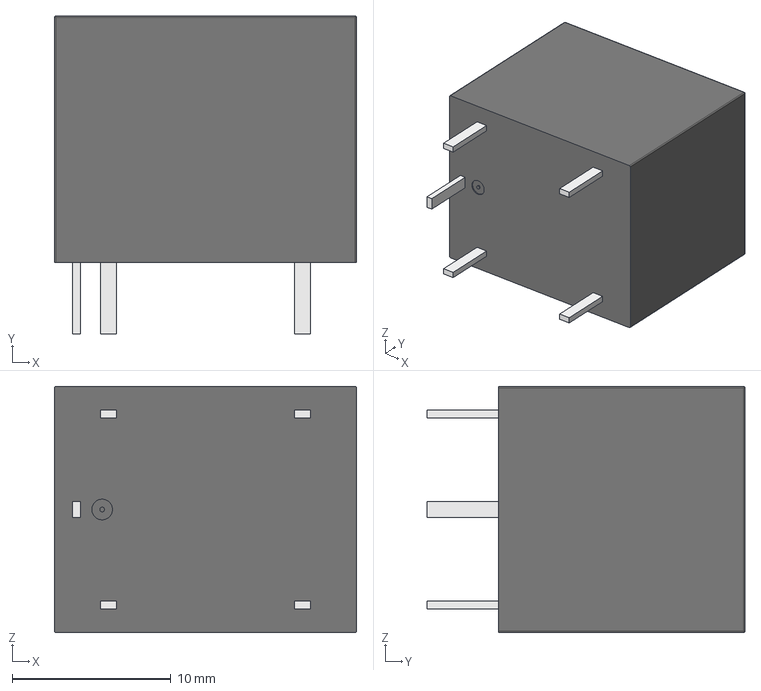
[picture p121: CAD file, 2023-01-22]
3DPackages/Doat-5volt Relay v1.step
19.0 x 20.0 x 15.5 mm
