Polarisru/kicad6_library/3DPackages/SOIC-8_3.9x4.9mm_P1.27mm.step

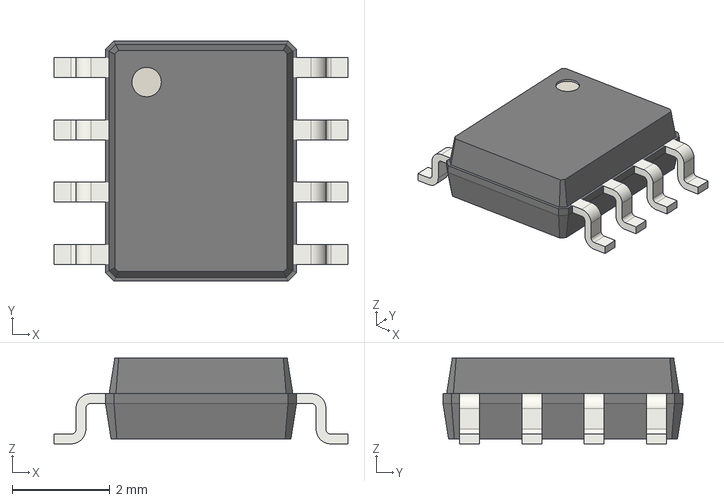
[picture p122: CAD file, 2023-01-22]
3DPackages/SOIC-8_3.9x4.9mm_P1.27mm.step
6.00 x 4.90 x 1.75 mm
