Polarisru/kicad6_library/3DPackages/SOT-23.step

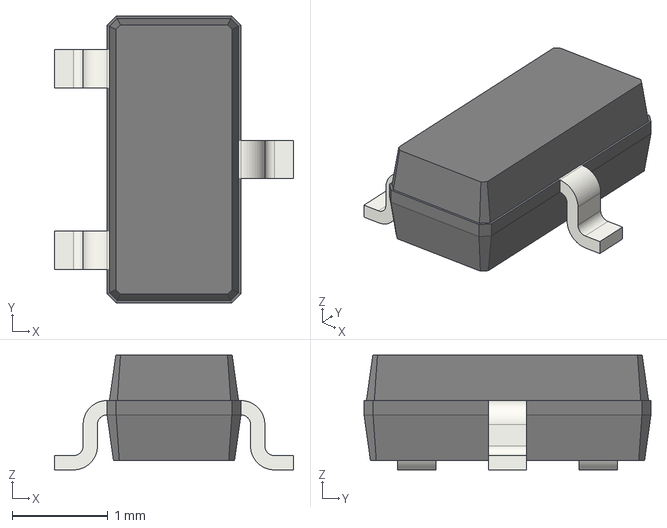
[picture p123: CAD file, 2023-01-22]
3DPackages/SOT-23.step
2.50 x 3.00 x 1.20 mm
