Polarisru/kicad6_library/3DPackages/SOIC-16_3.9x9.9mm_P1.27mm.step

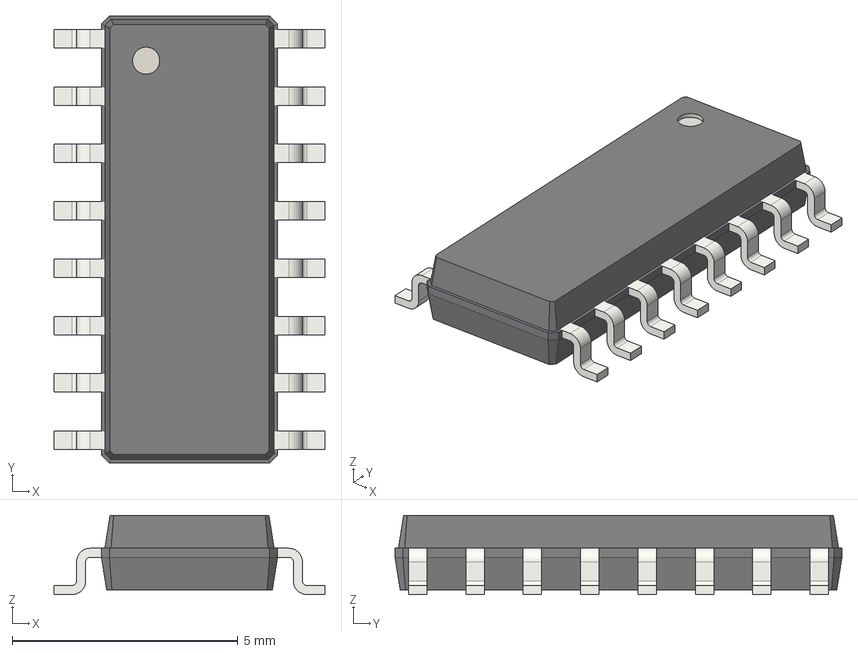
[picture p124: CAD file, 2023-01-22]
3DPackages/SOIC-16_3.9x9.9mm_P1.27mm.step
6.00 x 9.90 x 1.75 mm
