Polarisru/kicad6_library/3DPackages/pxc_1935161_02_PT-1-5-2-5-0-H-3D.step

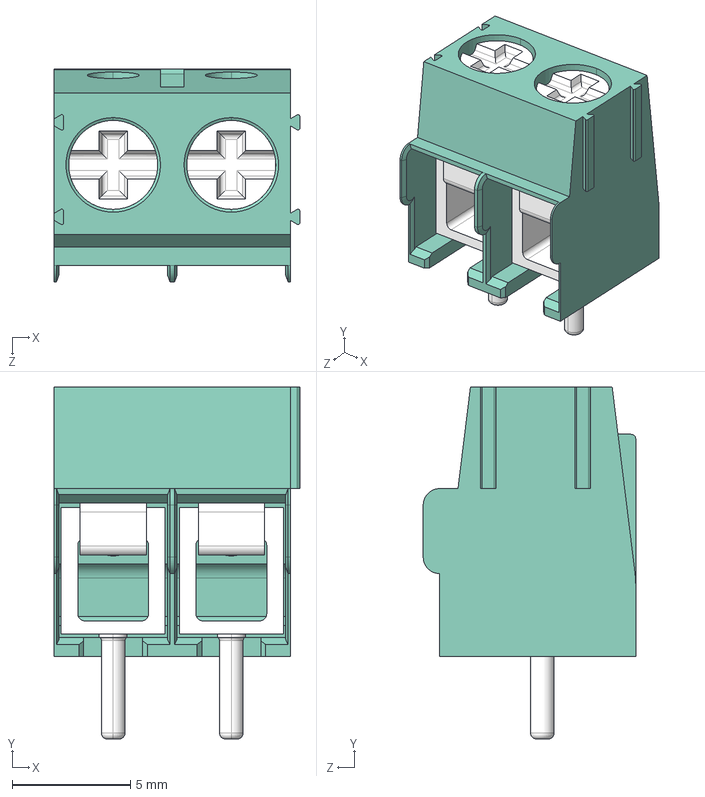
[picture p125: CAD file, 2023-01-22]
3DPackages/pxc_1935161_02_PT-1-5-2-5-0-H-3D.step
10.4 x 14.9 x 9.00 mm
