Polarisru/kicad6_library/3DPackages/SOP-4_4.4x2.6mm_P1.27mm.step

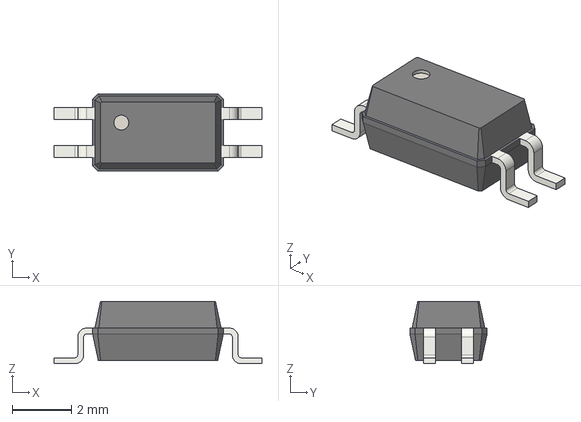
[picture p126: CAD file, 2023-01-22]
3DPackages/SOP-4_4.4x2.6mm_P1.27mm.step
7.00 x 2.60 x 2.10 mm
