Polarisru/kicad6_library/3DPackages/D_SOD-323.step

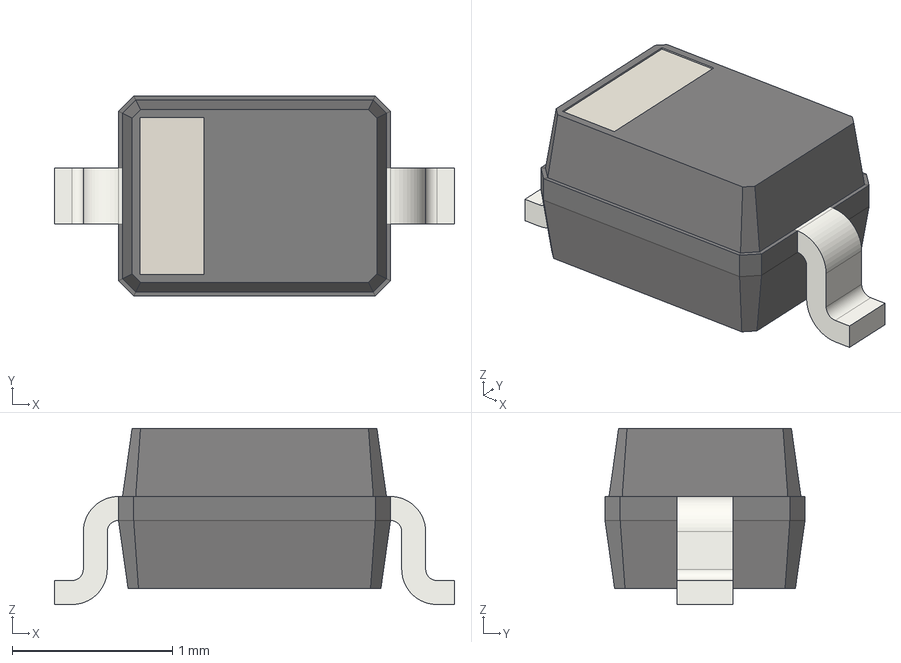
[picture p127: CAD file, 2023-01-22]
3DPackages/D_SOD-323.step
2.50 x 1.25 x 1.10 mm
