Polarisru/kicad6_library/3DPackages/IND_BOURNS_5254.step

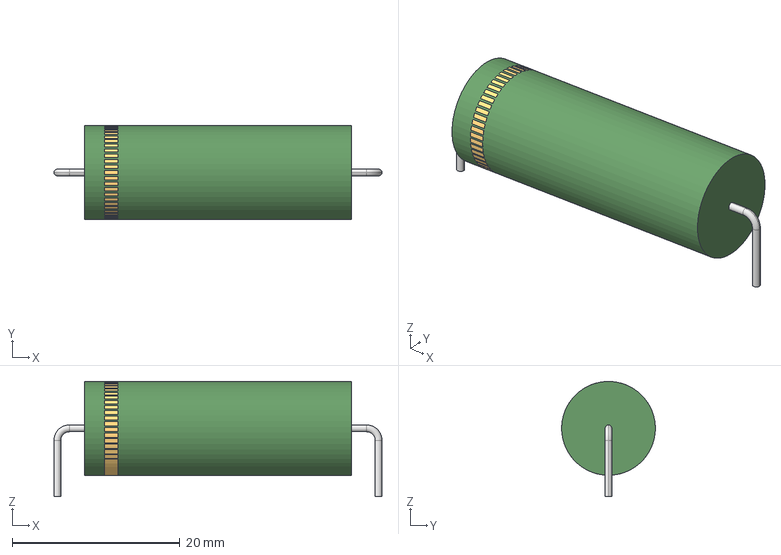
[picture p128: CAD file, 2023-01-22]
3DPackages/IND_BOURNS_5254.step
39.1 x 11.2 x 13.7 mm
