Polarisru/kicad6_library/3DPackages/Molex_Picoblade_1x08.STEP

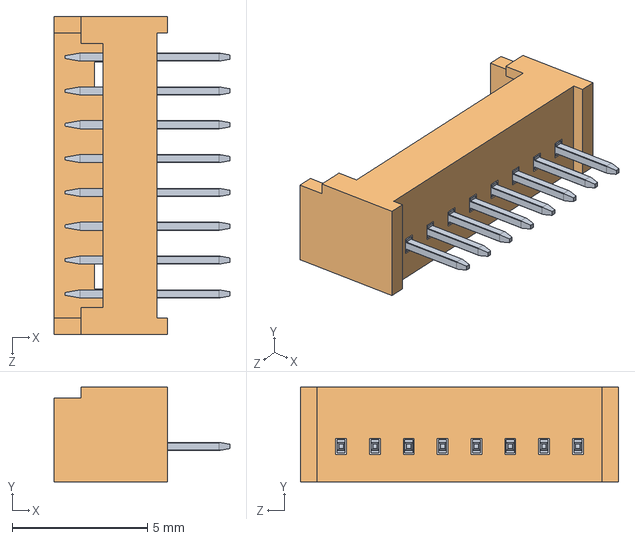
[picture p129: CAD file, 2023-01-22]
3DPackages/Molex_Picoblade_1x08.STEP
6.50 x 3.50 x 11.8 mm
