Polarisru/kicad6_library/3DPackages/PBH-010-H615W-55_8E.stp

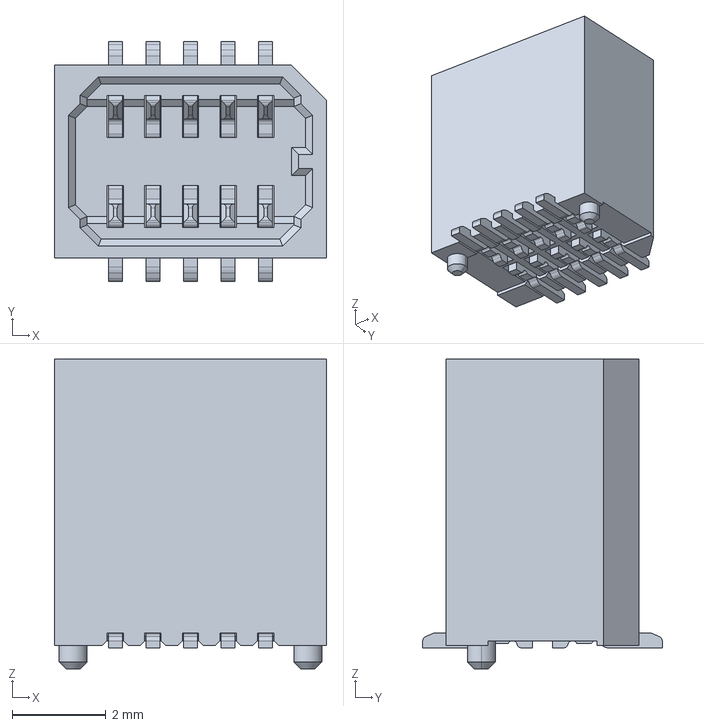
[picture p130: CAD file, 2023-01-22]
3DPackages/PBH-010-H615W-55_8E.stp
5.80 x 5.10 x 6.60 mm
