Polarisru/kicad6_library/3DPackages/pec11r-4x15f-sxxxx.step

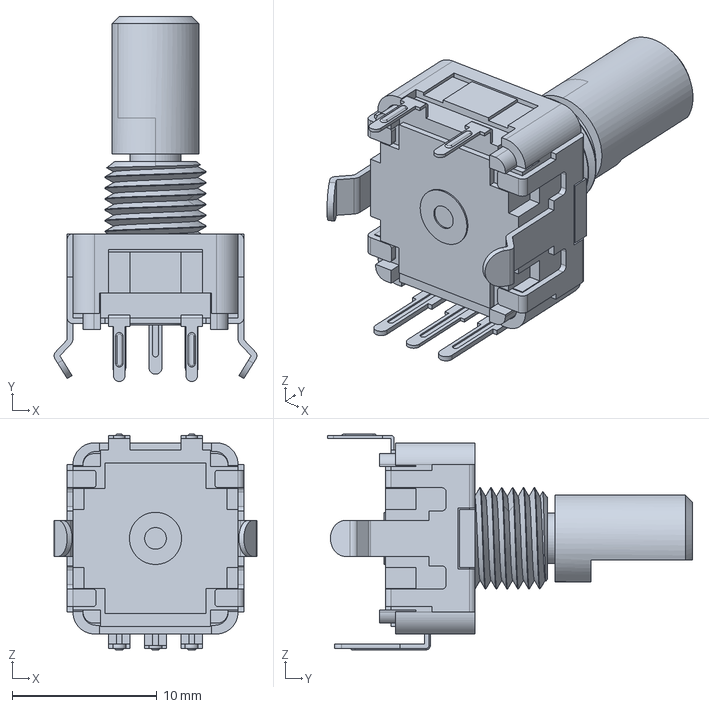
[picture p131: CAD file, 2023-01-22]
3DPackages/pec11r-4x15f-sxxxx.step
14.0 x 25.2 x 14.9 mm
