Polarisru/kicad6_library/3DPackages/TBA 1-2411.STEP

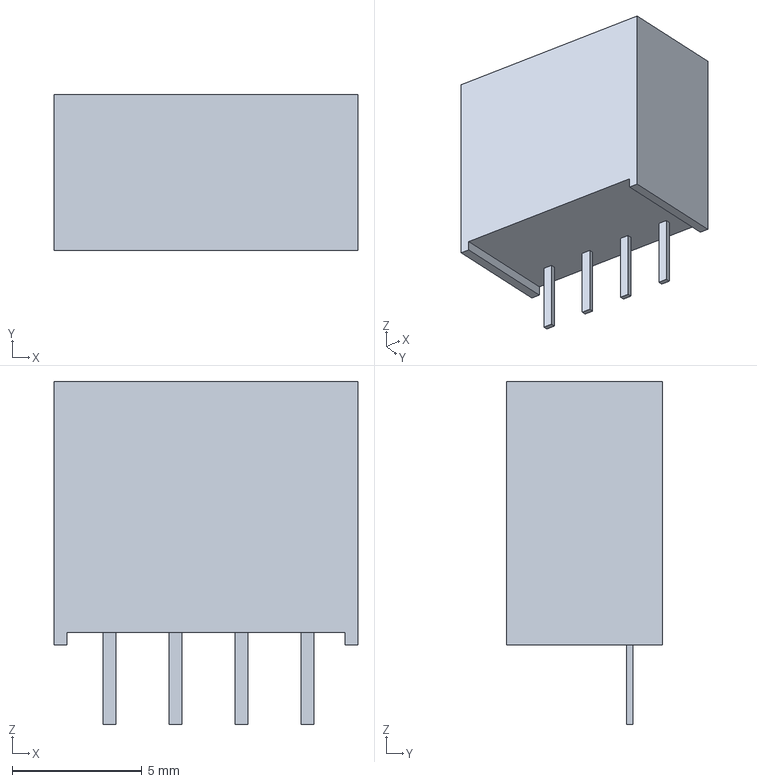
[picture p132: CAD file, 2023-01-22]
3DPackages/TBA 1-2411.STEP
11.7 x 6.00 x 13.2 mm
