Polarisru/kicad6_library/3DPackages/QFN-24_4x4mm_P0.5mm.step

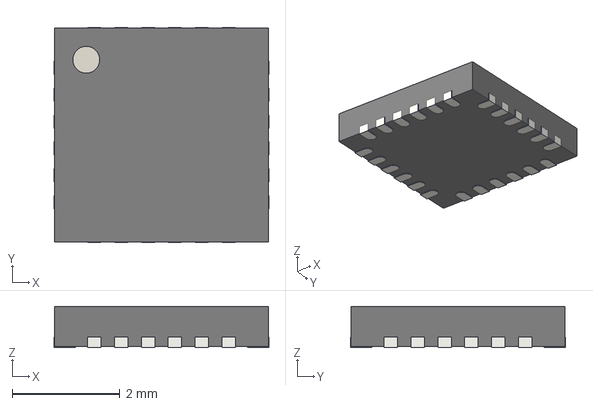
[picture p133: CAD file, 2023-01-22]
3DPackages/QFN-24_4x4mm_P0.5mm.step
4.00 x 4.00 x 0.77 mm
