Polarisru/kicad6_library/3DPackages/Omron Single.stp

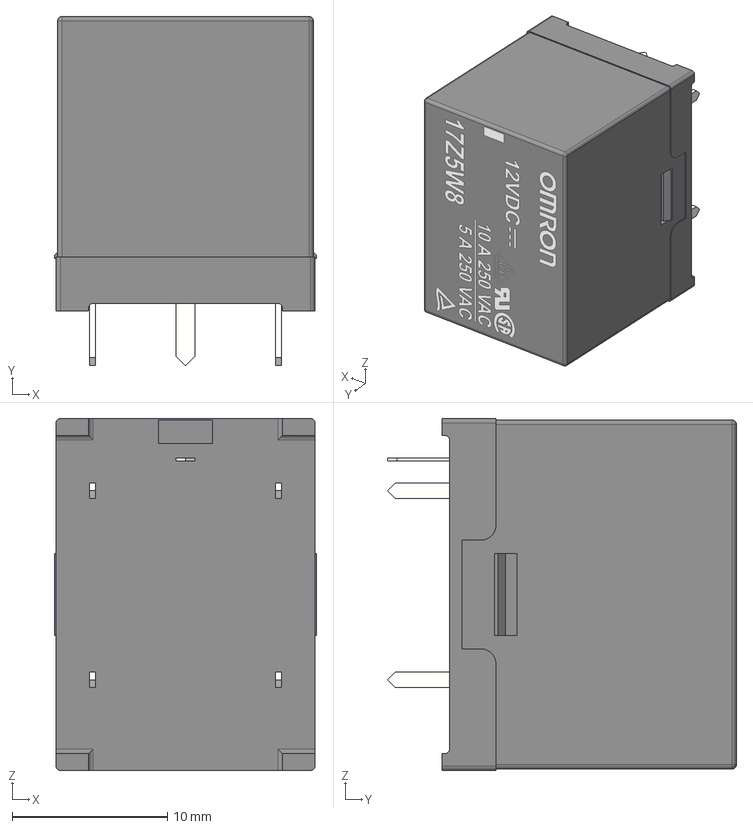
[picture p134: CAD file, 2023-01-22]
3DPackages/Omron Single.stp
16.9 x 22.5 x 22.7 mm
