Polarisru/kicad6_library/3DPackages/DOGM132.step

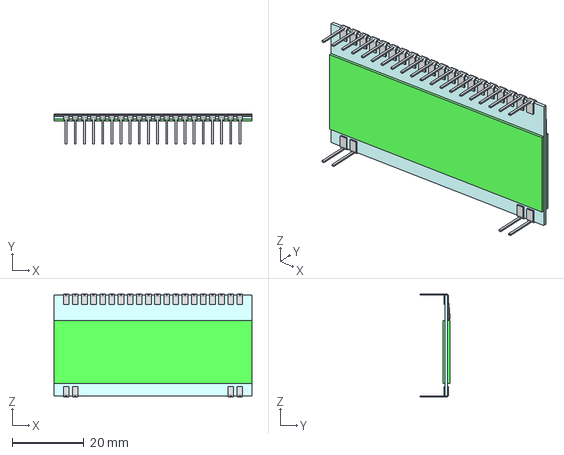
[picture p135: CAD file, 2023-01-22]
3DPackages/DOGM132.step
55.0 x 8.40 x 28.5 mm
