Polarisru/kicad6_library/3DPackages/WCSP6-YFF.step

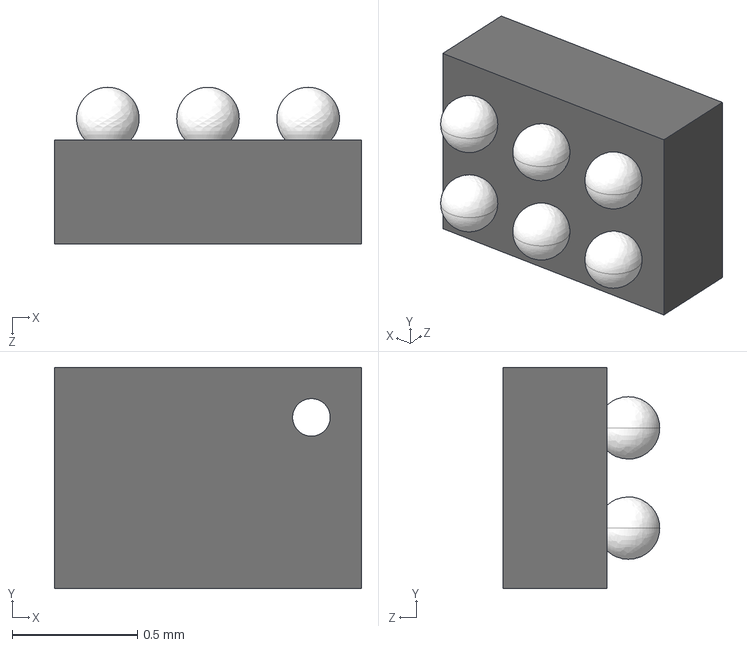
[picture p136: CAD file, 2023-01-22]
3DPackages/WCSP6-YFF.step
1.23 x 0.884 x 0.625 mm
