Polarisru/kicad6_library/3DPackages/TE-1909763-1.step

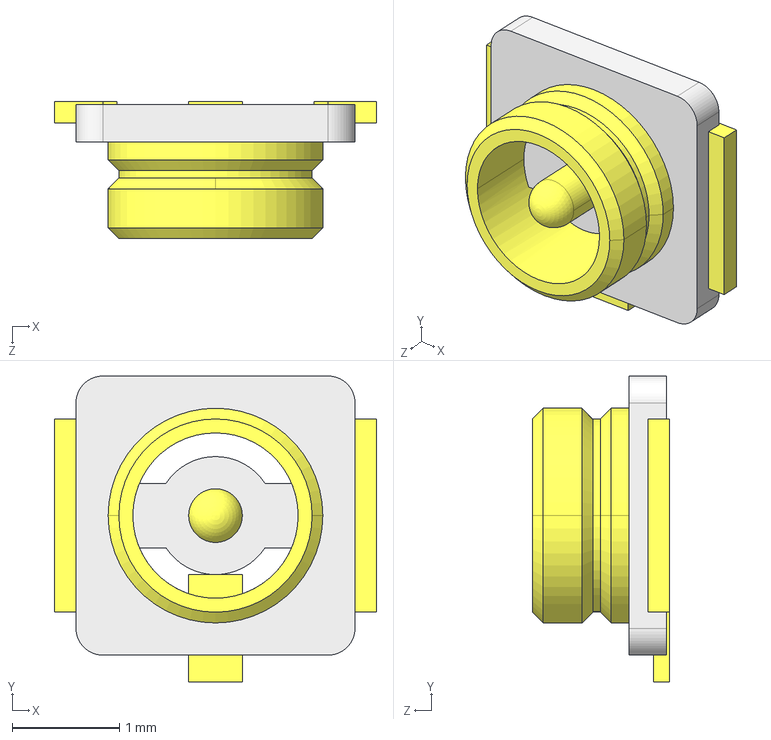
[picture p137: CAD file, 2023-01-22]
3DPackages/TE-1909763-1.step
3.00 x 2.85 x 1.28 mm
