Polarisru/kicad6_library/3DPackages/PinHeader_2x04_P1.27mm_Vertical.step

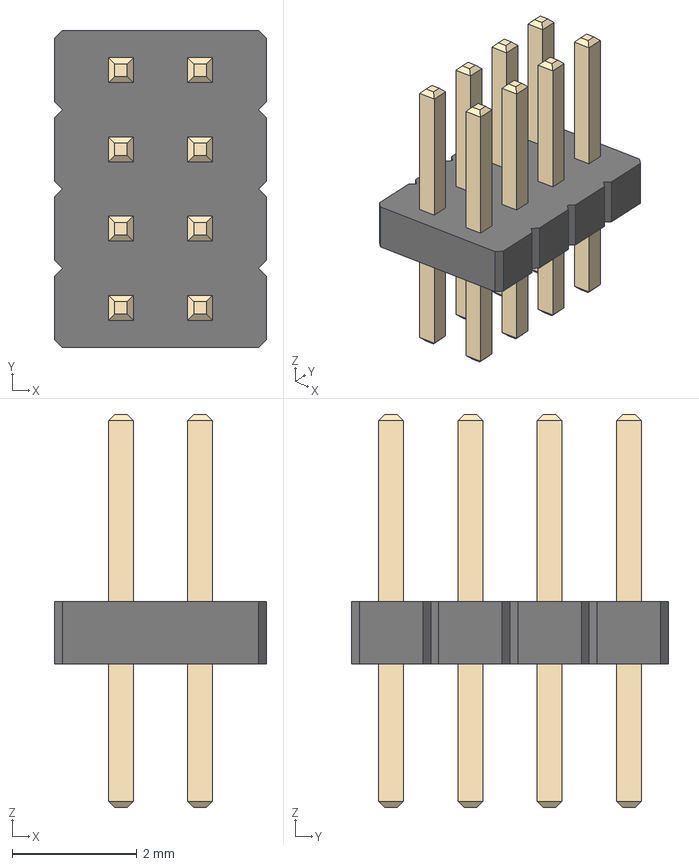
[picture p138: CAD file, 2023-01-22]
3DPackages/PinHeader_2x04_P1.27mm_Vertical.step
3.40 x 5.08 x 6.30 mm
