Polarisru/kicad6_library/3DPackages/DO-220AA.step

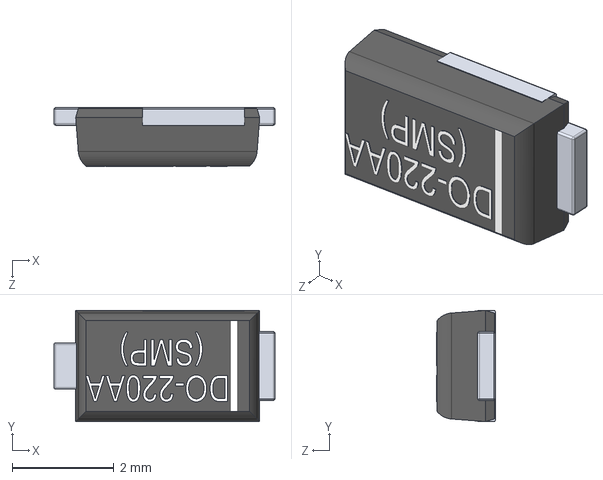
[picture p139: CAD file, 2023-01-22]
3DPackages/DO-220AA.step
4.34 x 2.18 x 1.16 mm
