Polarisru/kicad6_library/3DPackages/Murata_CSTNE.step

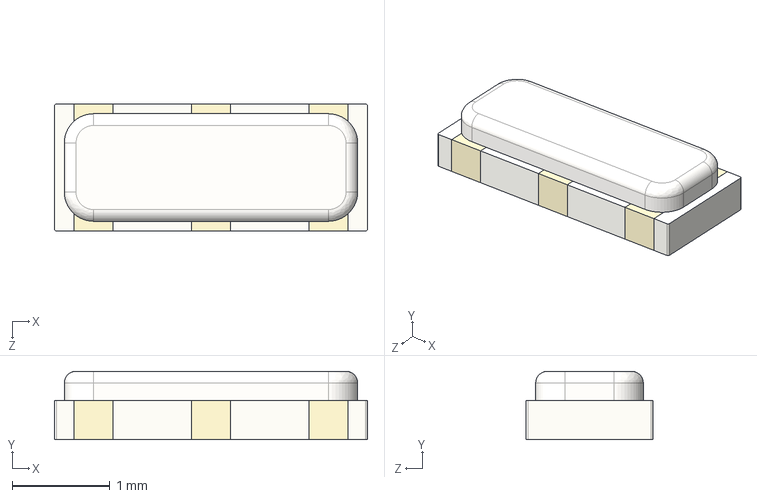
[picture p140: CAD file, 2023-01-22]
3DPackages/Murata_CSTNE.step
3.20 x 0.7 x 1.30 mm
