Polarisru/kicad6_library/3DPackages/JST_EH_B3B-EH-A_1x03_P2.50mm_Vertical.step

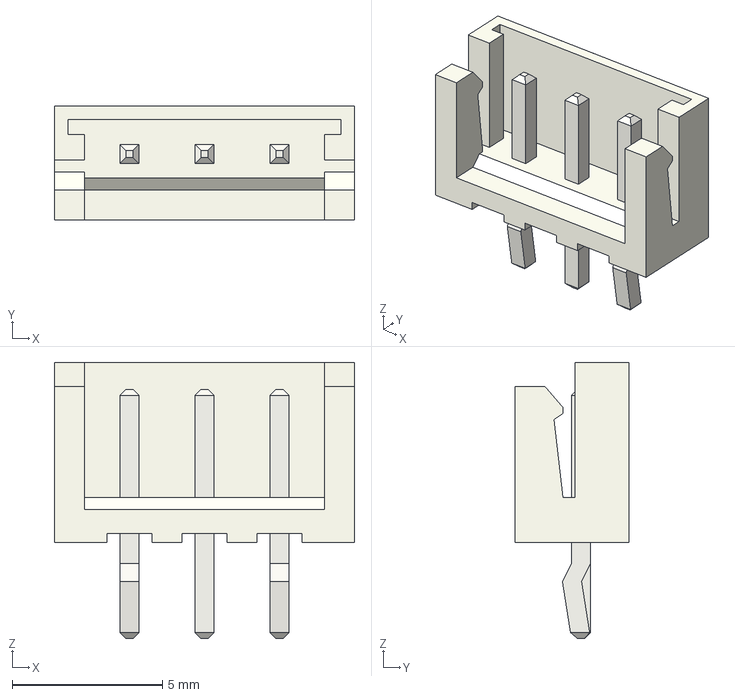
[picture p141: CAD file, 2023-01-22]
3DPackages/JST_EH_B3B-EH-A_1x03_P2.50mm_Vertical.step
10.0 x 3.80 x 9.20 mm
