Polarisru/kicad6_library/3DPackages/DFN-8-1EP_3x3mm_P0.5mm_EP1.66x2.38mm.step

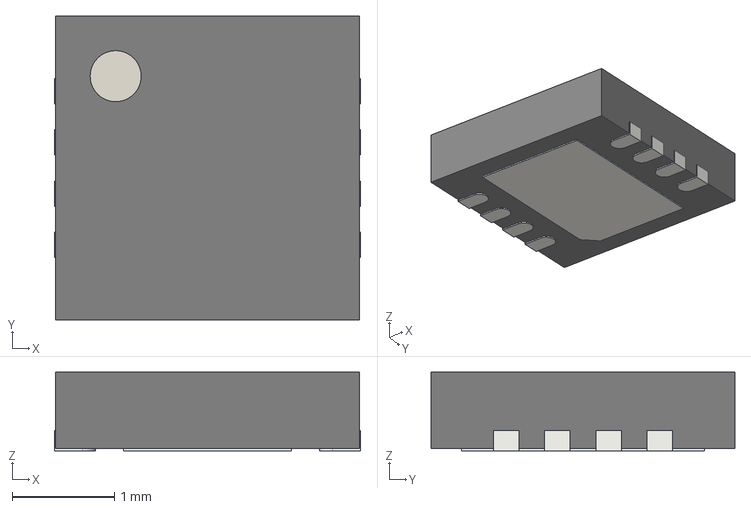
[picture p142: CAD file, 2023-01-22]
3DPackages/DFN-8-1EP_3x3mm_P0.5mm_EP1.66x2.38mm.step
3.00 x 2.98 x 0.77 mm
