Polarisru/kicad6_library/3DPackages/SOT-89-3.step

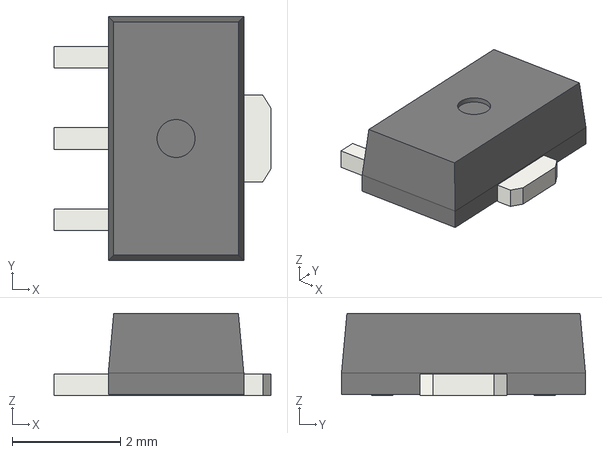
[picture p143: CAD file, 2023-01-22]
3DPackages/SOT-89-3.step
4.00 x 4.50 x 1.52 mm
