Polarisru/kicad6_library/3DPackages/SOT-723.step

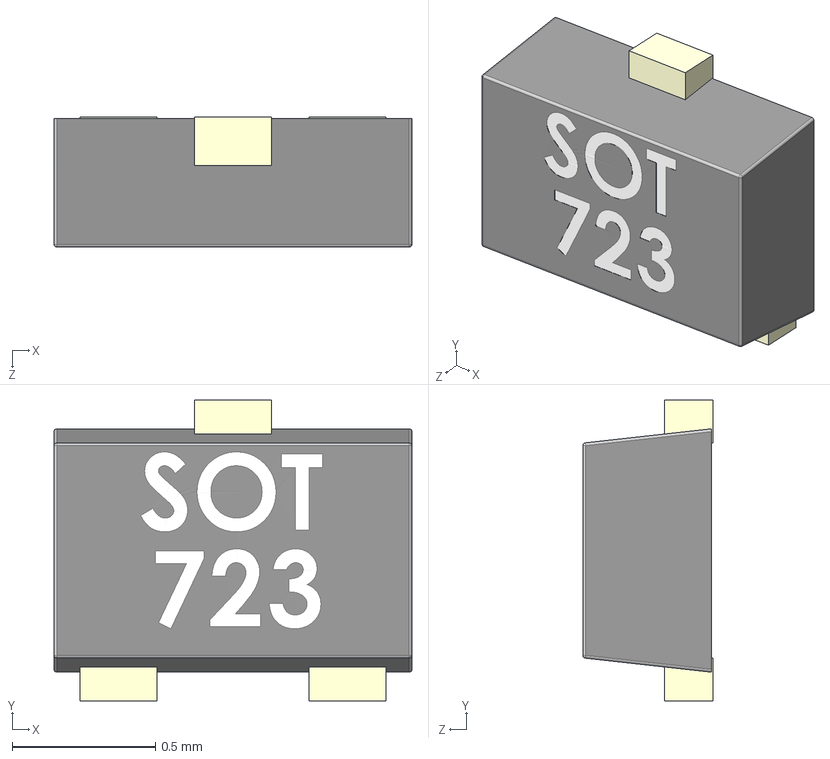
[picture p144: CAD file, 2023-01-22]
3DPackages/SOT-723.step
1.25 x 1.05 x 0.455 mm
