Polarisru/kicad6_library/3DPackages/C_Elec_10x10.2.step

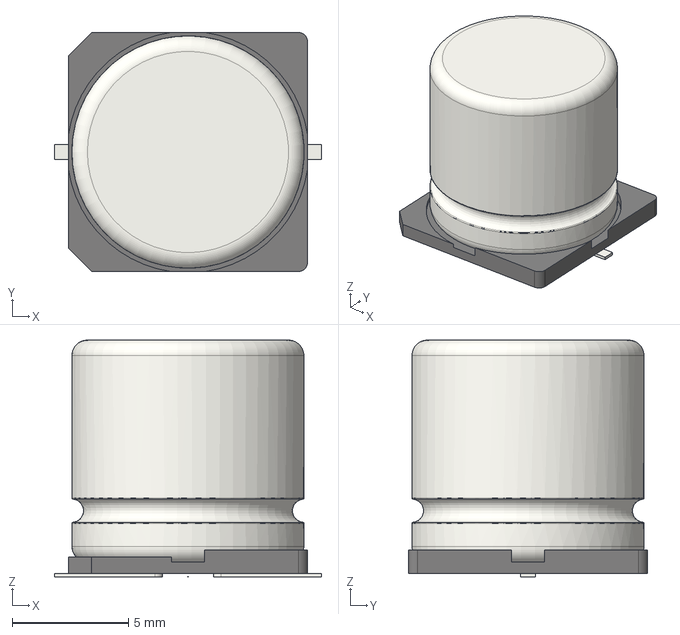
[picture p145: CAD file, 2023-01-22]
3DPackages/C_Elec_10x10.2.step
11.5 x 10.3 x 10.2 mm
