Polarisru/kicad6_library/3DPackages/Pin_D1.0mm_L10.0mm.step

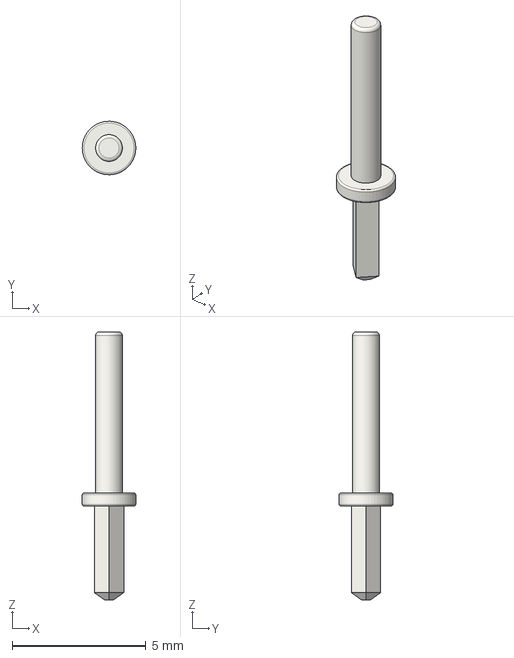
[picture p146: CAD file, 2023-01-22]
3DPackages/Pin_D1.0mm_L10.0mm.step
2.00 x 2.00 x 10.0 mm
