Polarisru/kicad6_library/3DPackages/SOT-353_SC-70-5.step

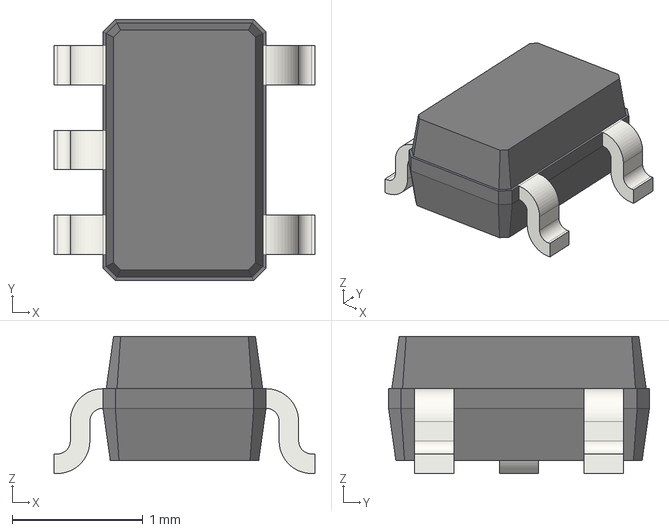
[picture p147: CAD file, 2023-01-22]
3DPackages/SOT-353_SC-70-5.step
2.00 x 2.00 x 1.05 mm
