Polarisru/kicad6_library/3DPackages/SOT-323_SC-70.step

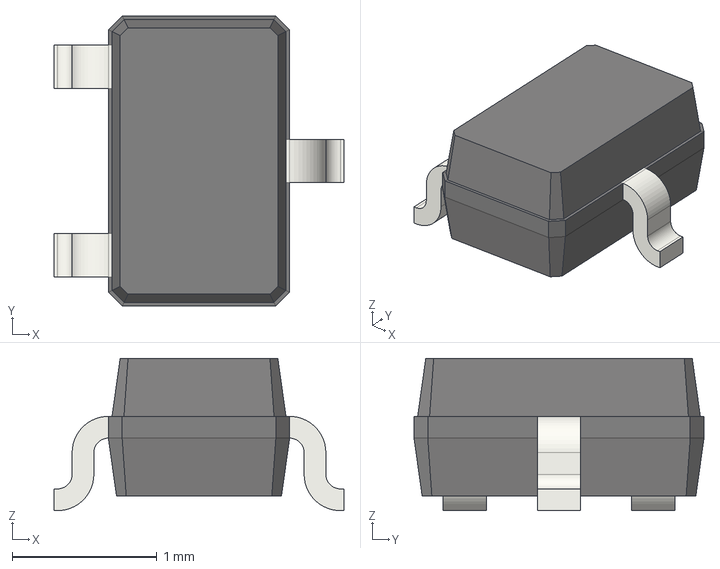
[picture p148: CAD file, 2023-01-22]
3DPackages/SOT-323_SC-70.step
2.00 x 2.00 x 1.05 mm
