Polarisru/kicad6_library/3DPackages/SOT-553.step

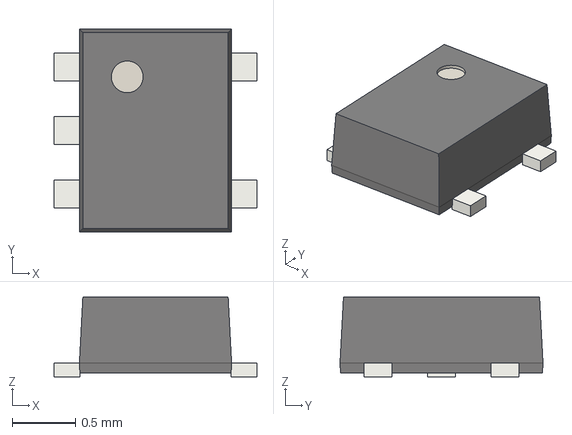
[picture p149: CAD file, 2023-01-22]
3DPackages/SOT-553.step
1.60 x 1.60 x 0.63 mm
