Polarisru/kicad6_library/(list of files, cad)

Other CAD files:
3DPackages/L_0805_2012Metric.step
3DPackages/C_1210_3225Metric.step
3DPackages/R_1206_3216Metric.step
3DPackages/DFN-8-1EP_3x3mm_P0.65mm_EP1.7x2.05mm.step
3DPackages/SOT-343_SC-70-4.step
3DPackages/10029449-111RLF.stp
3DPackages/10118194c.stp
3DPackages/1053131202.stp
3DPackages/1410516C_MUR.step
3DPackages/156120M173000.stp
3DPackages/2328702-6.stp
3DPackages/5034801000.step
3DPackages/5177983-3.step
3DPackages/5177984-3.stp
3DPackages/B12B-PHDSS.step
3DPackages/CP_Tantal_1311.step
3DPackages/CRR-104-M120.step
3DPackages/CSD88599.step
3DPackages/C_0603_1608Metric.step
3DPackages/DFN-10-1EP_3x3mm_P0.5mm_EP1.75x2.7mm.step
3DPackages/D_SMA.step
3DPackages/HSOP-8-1EP_3.9x4.9mm_P1.27mm_EP2.41x3.1mm.step
3DPackages/JST_EH_B2B-EH-A_1x02_P2.50mm_Vertical.step
3DPackages/JST_EH_B5B-EH-A_1x05_P2.50mm_Vertical.step
3DPackages/JST_EH_B6B-EH-A_1x06_P2.50mm_Vertical.step
3DPackages/JST_EH_B8B-EH-A_1x08_P2.50mm_Vertical.step
3DPackages/LED_0402_1005Metric.step
3DPackages/MSOP-8_3x3mm_P0.65mm.step
3DPackages/Molex_Picoblade_1x02.step
3DPackages/Molex_Picoblade_1x05.step
3DPackages/PinHeader_1x03_P2.54mm_Vertical.step
3DPackages/PinHeader_1x05_P2.54mm_Vertical.step
3DPackages/PinSocket_2x04_P1.27mm_Vertical_SMD.step
3DPackages/RK0971111-L15.STEP
3DPackages/RK09712_0-L20.STEP
3DPackages/R_0402_1005Metric.step
3DPackages/R_0603_1608Metric.step
3DPackages/S03B-PASK-2.STEP
3DPackages/SOIC-16W_7.5x10.3mm_P1.27mm.step
3DPackages/SSP-103-E246-95.step
3DPackages/TEC_3-2423.step
3DPackages/VSON4.STEP
3DPackages/pxc_1984633_02_PT-1-5-4-3-5-H_3D.stp
3DPackages/pxc_1984675_02_PT-1-5-8-3-5-H_3D.stp
