Polarisru/kicad6_library/(commit log)

2023-01-23 Footprint added for inductor 1255AY-220M
    [1255AY-220M_P3.step]
2023-01-25 3D models for L1210 and LED0805 added
    [LED_0805_2012Metric.step, L_1210_3225Metric.step]
2023-01-25 1x05_P2.54mm SMD PinHeader added
    [PinHeader_1x05_P2.54mm_Vertical_SMD.step]
2023-03-19 2x40 connector added, 8-bit buffer SN74AHC245 added
    [5177983-3.step]
2023-03-22 Micro SD card added
    [microSD_HC_Hirose_DM3D-SF.step]
2023-03-23 FPC10 connector added
    [1-2328702-0.step]
2023-03-24 Pushbutton and DIP switch x04 added
    [CUI_DEVICES_TS04-66-55-BK-160-SMT.step, SW_DIP_SPSTx04_Slide_Copal_CHS-04B_W7.62mm_P1.27mm.step]
2023-03-26 "Power" added to power pins
2023-03-28 Inverted pin order FPC-40 added
2023-03-28 FPC-10 pin order inverted
    [1-2328702-0.step]
2023-03-31 Some more new FPC connectors added as replacement of existing
    [5034801000.step, FFC2B35-10-T.stp, FH12A-40S-0.5SH.stp]
2023-03-31 Big TE connector changed, only pin1 marker moved
2023-04-02 MicroSD card connector changed
    [DM3CS-SF.stp]
2023-04-03 TE mesonine connector added
    [5177984-3.stp]
2023-04-22 Parts for BT project added (E104-BT5010, STM32G0B1)
    [E104-BT5010A.step]
2023-04-22 Double CAN transceiver added
    [VSON-14-EP-4.5x3mm_P0.65mm.step]
2023-04-25 Polyfuse added to library, improvements by Nr.
    [Fuse_1206_3216Metric.step]
2023-04-25 0603 LEDs added
2023-04-26 RGB LEDs added
    [CLV1.step, LED_IN-PI55TAT_INL.step]
2023-04-26 VREF of STM32G01B made passive
2023-04-27 Footprint for Tri-color LED 1206 added, to check!
    [156120M173000.stp]
2023-04-28 LED_PLCC4 added
    [LED_PLC4_2x2mm.stp]
2023-05-02 STM32G0B1 EP connected with GND
2023-05-02 EP changed for STM32G0B1
2023-07-05 New components added
    [PinHeader_2x05_P1.27mm_Vertical_SMD.step, WDFN-8-1EP_6x5mm_P1.27mm.step]
2023-10-21 LED driver KTD2026 added
    [KTD2026CEWE-TR.stp]
2024-08-14 3D models added for new project
    [ESP32-C3 supermini v5.step, GY-521.step]
2024-12-31 New components for new project added
    [DFN-10_2x2mm_P0.4mm.step, PinHeader_2x03_P2.54mm_Horizontal.step, PinSocket_2x20_P2.54mm_Vertical.step, TSSOP-28_4.4x9.7mm_P0.65mm.step]
2025-01-01 3x04 pin header added
    [PinHeader_3x04_P2.54mm_Horizontal.step]
2025-01-02 Soldering pad added
2025-01-13 Update of soldering pads
2025-02-09 Acceleromter LSM6DSV16X added
    [LGA-14_3x2.5mm_P0.5mm.step]
2025-02-22 ESP-C3 SuperMini and MPU-6050 added
    [ESP32-C3 supermini v5.step, ESP32-C3_SuperMini.step]
2025-04-22 BNO085 added
    [LGA-28.step]
2025-04-22 32kHz crystal added
    [Crystal_D2.1mm_L6.2mm_Horizontal_SMD.step]
2025-04-22 32kHz crystal footprint changed
2025-06-04 New components added, some footprints changed
    [ICM-42688-P.step, PinHeader_2x02_P2.54mm_Vertical.step]
2025-06-05 MAX3221 added
    [TSSOP-16_4.4x5mm_P0.65mm.step]
2025-06-11 Some changes in footprints
2025-06-12 1x07 Header added
    [PinHeader_1x07_P2.54mm_Vertical.step]
2025-06-15 Hirose 2x03 connector added, missing footprints added
    [DF11-6DP-2DSA.stp]
2025-12-02 MDBT42Q added
    [MDBT42Q.step]
2025-12-03 MDBT42Q footprint changed
2025-12-05 LED symbol changed to pass the grid
2026-04-21 MCP73812 added (Li battery loader)
2026-10-10 New components for Eagle board added
