Polarisru/kicad6_library/(notices)

Notices in the files:
3DPackages/C_1206_3216Metric.step:
Copyright (C) 2017, kicad StepUp
This work is licensed under the [Creative Commons CC-BY-SA 4.0 License](https://creativecommons.org/licenses/by-sa/4.0/legalcode),
with the following exception:
To the extent that the creation of electronic designs that use 'Licensed Material' can be considered to be 'Adapted Material',
You are free to use the library data in your own projects without the obligation to share your project files under this or any other license agreement.
3DPackages/LED_0603_1608Metric.step:
Copyright (C) 2018, kicad StepUp
3DPackages/JST_EH_B3B-EH-A_1x03_P2.50mm_Vertical.step:
Copyright (C) 2019, Rene Poeschl
3DPackages/D_SOD-123F.step:
This program is free software: you can redistribute it and/or modify
it under the terms of the GNU General Public License as published by
the Free Software Foundation, either version 3 of the License, or
any later version.
itself might be covered by the GNU General Public License.
3DPackages/Fuse_1206_3216Metric.step:
Copyright (C) 2020, kicad StepUp
3DPackages/Crystal_D2.1mm_L6.2mm_Horizontal_SMD.step:
Copyright (C) 2019, kicad StepUp
3DPackages/PinSocket_1x02_P2.54mm_Vertical.step:
Copyright (C) 2017, Terje Io
This work is licensed under the Creative Commons CC-BY-SA 4.0 License with the following exception:
To the extent that the creation of electronic designs that use 'Licensed Material'
https://creativecommons.org/licenses/by-sa/4.0/legalcode
3DPackages/TO-252-2.step:
Copyright (C) 2017, Ray Benitez
3DPackages/SW_DIP_SPSTx04_Slide_Copal_CHS-04B_W7.62mm_P1.27mm.step:
Copyright (C) 2018, Terje Io
3DPackages/FFC2B35-10-T.stp:
author */ ('License CC BY-ND 4.0'),
